bornier-dev/bornier/README.md

# Bornier

Open source EtherCAT slaves for machine tools running LinuxCNC: hardware, firmware and tooling.

- Website: [bornier.dev](https://bornier.dev)

> **Status: board bring-up.** Nothing here is usable yet. The first base boards are built and
> are being brought up block by block: the firmware runs on them and has on-target tests for
> the blocks checked so far, without the EtherCAT stack yet.

## Goals

- A family of standard-compliant EtherCAT slaves for CNC retrofits: motion (step/dir, encoders, probe), digital and analog I/O, spindle control, Modbus gateway.
- Works with any EtherCAT master; developed and tested against LinuxCNC with the IgH master (`lcec`).
- Firmware builds on the LinuxCNC PC itself with a free toolchain (`arm-none-eabi-gcc`, CMake) and updates over EtherCAT (FoE).
- Hardware designed in KiCad, published in full.

Out of scope: functional safety. E-stop and STO stay hardwired.

## Architecture

```
          EtherCAT (daisy chain)
LinuxCNC PC ──► [Base board A] ──► [EtherCAT drive] ──► [Base board B] ──► ...
 (IgH master)        │ HE10 ribbon (local bus, not EtherCAT)
                     ├── I/O module 1
                     └── I/O module n
```

- **One generic base board** per EtherCAT slave. More axes come from more boards on the
  EtherCAT chain (8 axes with two boards, 12 with three).
- **Extension modules** on DIN rail, chained to the base board by HE10 ribbons: slow I/O on SPI
  chips, without an MCU. A base board and its modules form a single modular slave.

## Base board

Schematic and PCB in [`hardware/base/`](hardware/base), generated by script (see below); the PCB is
being placed.

| Block | Content |
|---|---|
| Core | Microchip LAN9253 EtherCAT slave controller (two ports, RJ45 with magnetics), STM32H523 MCU in LQFP-100 over SPI/OCTOSPI, one shared 25 MHz MEMS oscillator |
| Power | 12 V or 24 V logic supply (10.8–30 V): fuse, TVS, reverse polarity protection, bucks to 5 V and 3.3 V; USB micro-B for bench power and DFU flashing |
| Motion | 4 axes, each on a dual RJ45: drive port (differential step/dir, enable, alarm, current-limited supply output) and encoder port (RS-422, TTL or HTL, 5 V or supply voltage); fast probe input |
| Spindle | 0-10 V speed reference, PWM, enable and direction |
| Modbus | Isolated RS-485, switchable termination |
| Safety | E-stop state input (wired, not a safety function), external watchdog on the MCU reset |
| Local bus | HE10 2 × 17 connector to the extension modules: SPI, 12 chip selects, I²C, IRQ, LATCH, OE |

The STM32H523 footprint takes any STM32H5 in LQFP-100 (H523, H533, H562, H563) without a PCB
change. The board is meant to be fed by a dedicated supply in the same cabinet; the
simulation of the input stage and its limits is in [`hardware/base/sim/`](hardware/base/sim/README.md).

The board is 107.5 × 150 mm. It mounts on a DIN rail in a Phoenix Contact UM-BASIC 108 profile
(housing kit UM-BASIC-KIT-B108-L150-7035), resting on the profile walls at the top level, or
screws onto a panel through four M3 holes at the corners, one of them plated to earth the board.
A plated hole takes the Phoenix PE contact, which earths the board to the DIN rail. Every edge
connector sits on a long edge: the profile closes the short ones; the USB jack is vertical.

## Repository layout

| Directory | Contents |
|---|---|
| [`firmware/`](firmware/README.md) | C++23 firmware on the [OpSy](https://github.com/Otatiaro/OpSy) RTOS, generated STM32H523 register headers, board support for the base board, bring-up examples and on-target tests |
| `hardware/lib/` | `kicadgen`, the Python schematic generator and checker (ERC, netlist), and the symbols, footprints and 3D models missing from the KiCad libraries, with their generators |
| `hardware/base/` | Base board: schematic generator (`gen/`), KiCad project (`kicad/`), Gerbers (`fab/`), circuit simulation (`sim/`) |
| [`tools/hil/`](tools/hil/README.md) | Hardware-in-the-loop test scripts |
| `tools/udev/` | udev rules for debug probes on Linux |

The schematic is generated: edit the scripts in `hardware/base/gen/`, then run
`python hardware/base/gen/schematic.py`, which regenerates it and runs the checks. The PCB is edited in
KiCad: after a schematic change, update it from the schematic (Tools > Update PCB from Schematic).

Building, flashing and coding rules: [CONTRIBUTING.md](CONTRIBUTING.md).

## Licensing

| Part | License |
|---|---|
| Hardware (KiCad projects) | [CERN-OHL-W-2.0](LICENSES/CERN-OHL-W-2.0.txt) |
| Firmware and tools | [MPL-2.0](LICENSES/MPL-2.0.txt) |
| Documentation | [CC-BY-4.0](LICENSES/CC-BY-4.0.txt) |

Each file carries an SPDX header naming its license.

## Official builds and forks

Official releases will carry the Bornier EtherCAT Vendor ID. Forks distributing hardware or firmware must use their own Vendor ID.

EtherCAT® is a registered trademark and patented technology, licensed by Beckhoff Automation GmbH, Germany.
