bornier-dev/bornier/firmware/devices/STM32H523/README.md

<!-- Generated by SvdGenerator 1.0.0; do not edit. -->

# STM32H523 register headers

Typed C++ register definitions for the STM32H523, generated by
[SvdGenerator](https://github.com/Otatiaro/SvdGenerator) 1.0.0. Every file here that
starts with a "Generated by SvdGenerator" line is replaced on the next run: change the
SVD file or the generator, not the file.

| | |
|---|---|
| Source | `STM32H523.svd` (device STM32H523, version 1.2) |
| SHA-256 of the source | `b989e9e5972266fa4f88ddf1c6e88730eb561bb5fadd696d822d5329803a197e` |
| Namespace | `STM32H523` |
| Core | CM33, r0p0, 4 interrupt priority bits, FPU, MPU |

## Whose is what

- **What the headers take from the source file**, names, addresses and descriptions,
  remains under the notice that file carries:

  > Copyright (c) 2025 STMicroelectronics.  
  >
  > SPDX-License-Identifier: Apache-2.0  
  >
  > Licensed under the Apache License, Version 2.0 (the "License");  
  > you may not use this file except in compliance with the License.  
  > You may obtain a copy of the License at  
  >
  > http://www.apache.org/licenses/LICENSE-2.0  
  >
  > Unless required by applicable law or agreed to in writing, software  
  > distributed under the License is distributed on an "AS IS" BASIS,  
  > WITHOUT WARRANTIES OR CONDITIONS OF ANY KIND, either express or implied.  
  > See the License for the specific language governing permissions and  
  > limitations under the License.  

- **The code generated around it** carries no license of SvdGenerator: the generator puts
  none of its own on what it generates.
- **`mmio.hpp`** is not generated from the source file: it is part of SvdGenerator, under
  the MIT license written in its header.

## Finding a register

A peripheral header can be thousands of lines long: do not read one from the top. Each
starts with a **map**: one line per register, with its offset, its access, its class, its
fields with their bits, and the lines of the file where its class is. From the table
below, open the header of the peripheral, read its map, then only the lines of the
register you need.

The [README of SvdGenerator](https://github.com/Otatiaro/SvdGenerator#the-generated-api)
describes the generated API: names, shared classes, arrays, named values, the vector table,
and what the code refuses to compile.

## Device headers

| Header | Holds |
|---|---|
| [`device.hpp`](device.hpp) | `device_name`, `device_version` and what the source says of the core |
| [`interrupts.hpp`](interrupts.hpp) | `irq_count` and the `IRQn_Type` enumeration |
| [`vectors.hpp`](vectors.hpp) | `vector_table`, the vector table built at compile time, and the `exception` enumeration of the core |
| [`mmio.hpp`](mmio.hpp) | The register building blocks every peripheral header includes (namespace `mmio`); the same for every device |

## Peripherals

"Line" is where the class starts in its header. Peripherals with the same registers share
a class.

| Peripheral | Address | Class | Header | Line | Interrupts | Description |
|---|---|---|---|---|---|---|
| `adc` | `0x42028000` | `adc_p` | [`adc.hpp`](adc.hpp) | 81 | `ADC1_IRQn` (37) | ADC register block |
| `adc2` | `0x42028100` | `adc_p` | [`adc.hpp`](adc.hpp) | 81 | `ADC2_IRQn` (69) | ADC register block |
| `adc2_s` | `0x52028100` | `adc_p` | [`adc.hpp`](adc.hpp) | 81 |  | ADC register block |
| `adcc` | `0x42028300` | `adcc_p` | [`adc.hpp`](adc.hpp) | 3921 |  | ADC common registers block |
| `adc_s` | `0x52028000` | `adc_p` | [`adc.hpp`](adc.hpp) | 81 |  | ADC register block |
| `crc` | `0x40023000` | `crc_p` | [`crc.hpp`](crc.hpp) | 47 |  | CRC address block description |
| `crc_s` | `0x50023000` | `crc_p` | [`crc.hpp`](crc.hpp) | 47 |  | CRC address block description |
| `crs` | `0x40006000` | `crs_p` | [`crs.hpp`](crs.hpp) | 46 | `CRS_IRQn` (75) | CRS address block description |
| `crs_s` | `0x50006000` | `crs_p` | [`crs.hpp`](crs.hpp) | 46 |  | CRS address block description |
| `dac` | `0x42028400` | `dac_p` | [`dac.hpp`](dac.hpp) | 62 | `DAC1_IRQn` (38) | DAC address block description |
| `dac_s` | `0x52028400` | `dac_p` | [`dac.hpp`](dac.hpp) | 62 |  | DAC address block description |
| `dbgmcu` | `0x44024000` | `dbgmcu_p` | [`dbgmcu.hpp`](dbgmcu.hpp) | 62 |  | DBGMCU register block |
| `dbgmcu_s` | `0x54024000` | `dbgmcu_p` | [`dbgmcu.hpp`](dbgmcu.hpp) | 62 |  | DBGMCU register block |
| `dcache` | `0x40031400` | `dcache_p` | [`dcache.hpp`](dcache.hpp) | 52 | `DCACHE_IRQn` (105) | DCACHE register block |
| `dcache_s` | `0x50031400` | `dcache_p` | [`dcache.hpp`](dcache.hpp) | 52 |  | DCACHE register block |
| `dcmi` | `0x4202C000` | `dcmi_p` | [`dcmi.hpp`](dcmi.hpp) | 53 | `DCMI_PSSI_IRQn` (108) | DCMI address block description |
| `dcmi_s` | `0x5202C000` | `dcmi_p` | [`dcmi.hpp`](dcmi.hpp) | 53 |  | DCMI address block description |
| `dlybos1` | `0x4600F000` | `dlyb_p` | [`dlyb.hpp`](dlyb.hpp) | 44 |  | DLYB address block description |
| `dlybos1_s` | `0x5600F000` | `dlyb_p` | [`dlyb.hpp`](dlyb.hpp) | 44 |  | DLYB address block description |
| `dlybsd1` | `0x46008400` | `dlyb_p` | [`dlyb.hpp`](dlyb.hpp) | 44 |  | DLYB address block description |
| `dlybsd1_s` | `0x56008400` | `dlyb_p` | [`dlyb.hpp`](dlyb.hpp) | 44 |  | DLYB address block description |
| `dts` | `0x40008C00` | `dts_p` | [`dts.hpp`](dts.hpp) | 51 | `DTS_OR_DTS_WKUP_IRQn` (113) | DTS address block description |
| `dts_s` | `0x50008C00` | `dts_p` | [`dts.hpp`](dts.hpp) | 51 |  | DTS address block description |
| `exti` | `0x44022000` | `exti_p` | [`exti.hpp`](exti.hpp) | 65 | `EXTI0_IRQn` (11), `EXTI1_IRQn` (12), `EXTI2_IRQn` (13), `EXTI3_IRQn` (14), `EXTI4_IRQn` (15), `EXTI5_IRQn` (16), `EXTI6_IRQn` (17), `EXTI7_IRQn` (18), `EXTI8_IRQn` (19), `EXTI9_IRQn` (20), `EXTI10_IRQn` (21), `EXTI11_IRQn` (22), `EXTI12_IRQn` (23), `EXTI13_IRQn` (24), `EXTI14_IRQn` (25), `EXTI15_IRQn` (26), `FPU_IRQn` (103), `CEC_IRQn` (119) | EXTI address block description |
| `exti_s` | `0x54022000` | `exti_p` | [`exti.hpp`](exti.hpp) | 65 |  | EXTI address block description |
| `fdcan` | `0x4000A400` | `fdcan_p` | [`fdcan.hpp`](fdcan.hpp) | 79 | `FDCAN1_IT0_IRQn` (39), `FDCAN1_IT1_IRQn` (40) | FDCAN register blank and RAM |
| `fdcan2` | `0x4000A800` | `fdcan_p` | [`fdcan.hpp`](fdcan.hpp) | 79 | `FDCAN2_IT0_IRQn` (109), `FDCAN2_IT1_IRQn` (110) | FDCAN register blank and RAM |
| `fdcan2_s` | `0x5000A800` | `fdcan_p` | [`fdcan.hpp`](fdcan.hpp) | 79 |  | FDCAN register blank and RAM |
| `fdcan_s` | `0x5000A400` | `fdcan_p` | [`fdcan.hpp`](fdcan.hpp) | 79 |  | FDCAN register blank and RAM |
| `flash` | `0x40022000` | `flash_p` | [`flash.hpp`](flash.hpp) | 107 | `FLASH_IRQn` (6) | Mustang_FLASH register block |
| `flash_s` | `0x50022000` | `flash_p` | [`flash.hpp`](flash.hpp) | 107 | `FLASH_S_IRQn` (7) | Mustang_FLASH register block |
| `fmc` | `0x47000400` | `fmc_p` | [`fmc.hpp`](fmc.hpp) | 67 | `FMC_IRQn` (77) | FMC address block description |
| `fmc_s` | `0x57000400` | `fmc_p` | [`fmc.hpp`](fmc.hpp) | 67 |  | FMC address block description |
| `gpdma` | `0x40020000` | `gpdma_p` | [`gpdma.hpp`](gpdma.hpp) | 60 | `GPDMA1_CH0_IRQn` (27), `GPDMA1_CH1_IRQn` (28), `GPDMA1_CH2_IRQn` (29), `GPDMA1_CH3_IRQn` (30), `GPDMA1_CH4_IRQn` (31), `GPDMA1_CH5_IRQn` (32), `GPDMA1_CH6_IRQn` (33), `GPDMA1_CH7_IRQn` (34) | GPDMA register block |
| `gpdma2` | `0x40021000` | `gpdma_p` | [`gpdma.hpp`](gpdma.hpp) | 60 | `GPDMA2_CH0_IRQn` (90), `GPDMA2_CH1_IRQn` (91), `GPDMA2_CH2_IRQn` (92), `GPDMA2_CH3_IRQn` (93), `GPDMA2_CH4_IRQn` (94), `GPDMA2_CH5_IRQn` (95), `GPDMA2_CH6_IRQn` (96), `GPDMA2_CH7_IRQn` (97) | GPDMA register block |
| `gpdma2_s` | `0x50021000` | `gpdma_p` | [`gpdma.hpp`](gpdma.hpp) | 60 |  | GPDMA register block |
| `gpdma_s` | `0x50020000` | `gpdma_p` | [`gpdma.hpp`](gpdma.hpp) | 60 |  | GPDMA register block |
| `gpioa` | `0x42020000` | `gpio_p` | [`gpio.hpp`](gpio.hpp) | 70 |  | GPIOA address block description |
| `gpioa_s` | `0x52020000` | `gpio_p` | [`gpio.hpp`](gpio.hpp) | 70 |  | GPIOA address block description |
| `gpiob` | `0x42020400` | `gpio_p` | [`gpio.hpp`](gpio.hpp) | 70 |  | GPIOB address block description |
| `gpiob_s` | `0x52020400` | `gpio_p` | [`gpio.hpp`](gpio.hpp) | 70 |  | GPIOB address block description |
| `gpioc` | `0x42020800` | `gpio_p` | [`gpio.hpp`](gpio.hpp) | 70 |  | GPIOC address block description |
| `gpioc_s` | `0x52020800` | `gpio_p` | [`gpio.hpp`](gpio.hpp) | 70 |  | GPIOC address block description |
| `gpiod` | `0x42020C00` | `gpio_p` | [`gpio.hpp`](gpio.hpp) | 70 |  | GPIOD address block description |
| `gpiod_s` | `0x52020C00` | `gpio_p` | [`gpio.hpp`](gpio.hpp) | 70 |  | GPIOD address block description |
| `gpioe` | `0x42021000` | `gpio_p` | [`gpio.hpp`](gpio.hpp) | 70 |  | GPIOE address block description |
| `gpioe_s` | `0x52021000` | `gpio_p` | [`gpio.hpp`](gpio.hpp) | 70 |  | GPIOE address block description |
| `gpiof` | `0x42021400` | `gpio_p` | [`gpio.hpp`](gpio.hpp) | 70 |  | GPIOF address block description |
| `gpiof_s` | `0x52021400` | `gpio_p` | [`gpio.hpp`](gpio.hpp) | 70 |  | GPIOF address block description |
| `gpiog` | `0x42021800` | `gpio_p` | [`gpio.hpp`](gpio.hpp) | 70 |  | GPIOG address block description |
| `gpiog_s` | `0x52021800` | `gpio_p` | [`gpio.hpp`](gpio.hpp) | 70 |  | GPIOG address block description |
| `gpioh` | `0x42021C00` | `gpio_p` | [`gpio.hpp`](gpio.hpp) | 70 |  | GPIOH address block description |
| `gpioh_s` | `0x52021C00` | `gpio_p` | [`gpio.hpp`](gpio.hpp) | 70 |  | GPIOH address block description |
| `gpioi` | `0x1A0` | `gpioi_p` | [`gpio.hpp`](gpio.hpp) | 5825 |  | GPIOI address block description |
| `gpioi_s` | `0x100001A0` | `gpioi_p` | [`gpio.hpp`](gpio.hpp) | 5825 |  | GPIOI address block description |
| `gtzc1_tzic` | `0x40032400` | `gtzc1_tzic_p` | [`gtzc1.hpp`](gtzc1.hpp) | 80 | `GTZC_IRQn` (8) | GTZC1_MPCBBz register block |
| `gtzc1_tzic_s` | `0x50032400` | `gtzc1_tzic_p` | [`gtzc1.hpp`](gtzc1.hpp) | 80 |  | GTZC1_MPCBBz register block |
| `gtzc1_tzsc` | `0x40036400` | `gtzc1_tzsc_p` | [`gtzc1.hpp`](gtzc1.hpp) | 7014 |  | GTZC1_MPCBBz register block |
| `gtzc1_tzsc_s` | `0x50036400` | `gtzc1_tzsc_p` | [`gtzc1.hpp`](gtzc1.hpp) | 7014 |  | GTZC1_MPCBBz register block |
| `hash` | `0x420C0400` | `hash_p` | [`hash.hpp`](hash.hpp) | 171 | `HASH_IRQn` (117) | HASH register bank |
| `hash_s` | `0x520C0400` | `hash_p` | [`hash.hpp`](hash.hpp) | 171 |  | HASH register bank |
| `i2c` | `0x40005400` | `i2c_p` | [`i2c.hpp`](i2c.hpp) | 53 | `I2C1_EV_IRQn` (51), `I2C1_ERR_IRQn` (52) | I2C address block description |
| `i2c2` | `0x40005800` | `i2c_p` | [`i2c.hpp`](i2c.hpp) | 53 | `I2C2_EV_IRQn` (53), `I2C2_ERR_IRQn` (54) | I2C address block description |
| `i2c2_s` | `0x50005800` | `i2c_p` | [`i2c.hpp`](i2c.hpp) | 53 |  | I2C address block description |
| `i2c3` | `0x44002800` | `i2c_p` | [`i2c.hpp`](i2c.hpp) | 53 | `I2C3_EV_IRQn` (80), `I2C3_ERR_IRQn` (81) | I2C address block description |
| `i2c3_s` | `0x54002800` | `i2c_p` | [`i2c.hpp`](i2c.hpp) | 53 |  | I2C address block description |
| `i2c_s` | `0x50005400` | `i2c_p` | [`i2c.hpp`](i2c.hpp) | 53 |  | I2C address block description |
| `i3c` | `0x40005C00` | `i3c_p` | [`i3c.hpp`](i3c.hpp) | 73 | `I3C1_EV_IRQn` (123), `I3C1_ERR_IRQn` (124) | I3C register block |
| `i3c2` | `0x44003000` | `i3c_p` | [`i3c.hpp`](i3c.hpp) | 73 | `I3C2_EV_IRQn` (131), `I3C2_ERR_IRQn` (132) | I3C register block |
| `i3c2_s` | `0x54003000` | `i3c_p` | [`i3c.hpp`](i3c.hpp) | 73 |  | I3C register block |
| `i3c_s` | `0x50005C00` | `i3c_p` | [`i3c.hpp`](i3c.hpp) | 73 |  | I3C register block |
| `icache` | `0x40030400` | `icache_p` | [`icache.hpp`](icache.hpp) | 52 | `ICACHE_IRQn` (104) | ICACHE register block |
| `icache_s` | `0x50030400` | `icache_p` | [`icache.hpp`](icache.hpp) | 52 |  | ICACHE register block |
| `iwdg` | `0x40003000` | `iwdg_p` | [`iwdg.hpp`](iwdg.hpp) | 48 | `IWDG_IRQn` (35) | IWDG address block description |
| `iwdg_s` | `0x50003000` | `iwdg_p` | [`iwdg.hpp`](iwdg.hpp) | 48 |  | IWDG address block description |
| `lptim1` | `0x44004400` | `lptim_p` | [`lptim.hpp`](lptim.hpp) | 57 | `LPTIM1_IRQn` (64) | LPTIM1 address block description |
| `lptim1_s` | `0x54004400` | `lptim_p` | [`lptim.hpp`](lptim.hpp) | 57 |  | LPTIM1 address block description |
| `lptim2` | `0x40009400` | `lptim_p` | [`lptim.hpp`](lptim.hpp) | 57 | `LPTIM2_IRQn` (70) | LPTIM2 address block description |
| `lptim2_s` | `0x50009400` | `lptim_p` | [`lptim.hpp`](lptim.hpp) | 57 |  | LPTIM2 address block description |
| `lpuart` | `0x44002400` | `lpuart_p` | [`lpuart.hpp`](lpuart.hpp) | 55 | `LPUART1_IRQn` (63) | LPUART address block description |
| `lpuart_s` | `0x54002400` | `lpuart_p` | [`lpuart.hpp`](lpuart.hpp) | 55 |  | LPUART address block description |
| `octospi` | `0x47001400` | `octospi_p` | [`octospi.hpp`](octospi.hpp) | 69 | `OCTOSPI1_IRQn` (78) | OCTOSPI register block |
| `octospi_s` | `0x57001400` | `octospi_p` | [`octospi.hpp`](octospi.hpp) | 69 |  | OCTOSPI register block |
| `pssi` | `0x4202C400` | `pssi_p` | [`pssi.hpp`](pssi.hpp) | 49 |  | PSSI register block |
| `pssi_s` | `0x5202C400` | `pssi_p` | [`pssi.hpp`](pssi.hpp) | 49 |  | PSSI register block |
| `pwr` | `0x44020800` | `pwr_p` | [`pwr.hpp`](pwr.hpp) | 61 |  | PWR address block description |
| `pwr_s` | `0x54020800` | `pwr_p` | [`pwr.hpp`](pwr.hpp) | 61 |  | PWR address block description |
| `ramcfg` | `0x40026000` | `ramcfg_p` | [`ramcfg.hpp`](ramcfg.hpp) | 73 | `RAMCFG_IRQn` (5) | RAMCFG address block description |
| `ramcfg_s` | `0x50026000` | `ramcfg_p` | [`ramcfg.hpp`](ramcfg.hpp) | 73 |  | RAMCFG address block description |
| `rcc` | `0x44020C00` | `rcc_p` | [`rcc.hpp`](rcc.hpp) | 90 | `RCC_IRQn` (9), `RCC_S_IRQn` (10) | RCC address block description |
| `rcc_s` | `0x54020C00` | `rcc_p` | [`rcc.hpp`](rcc.hpp) | 90 |  | RCC address block description |
| `rng` | `0x420C0800` | `rng_p` | [`rng.hpp`](rng.hpp) | 47 | `RNG_IRQn` (114) | RNG address block description |
| `rng_s` | `0x520C0800` | `rng_p` | [`rng.hpp`](rng.hpp) | 47 |  | RNG address block description |
| `rtc` | `0x44007800` | `rtc_p` | [`rtc.hpp`](rtc.hpp) | 68 | `RTC_IRQn` (2), `RTC_S_IRQn` (3) | RTC register block |
| `rtc_s` | `0x54007800` | `rtc_p` | [`rtc.hpp`](rtc.hpp) | 68 |  | RTC register block |
| `sbs` | `0x44000400` | `sbs_p` | [`sbs.hpp`](sbs.hpp) | 60 |  | SBS address block description |
| `sbs_s` | `0x54000400` | `sbs_p` | [`sbs.hpp`](sbs.hpp) | 60 |  | SBS address block description |
| `sdmmc` | `0x46008000` | `sdmmc_p` | [`sdmmc.hpp`](sdmmc.hpp) | 80 | `SDMMC1_IRQn` (79) | SDMMC address block description |
| `sdmmc_s` | `0x56008000` | `sdmmc_p` | [`sdmmc.hpp`](sdmmc.hpp) | 80 |  | SDMMC address block description |
| `sec_adcc` | `0x52028300` | `adcc_p` | [`adc.hpp`](adc.hpp) | 3921 |  | ADC common registers block |
| `spi` | `0x40013000` | `spi_p` | [`spi.hpp`](spi.hpp) | 56 | `SPI1_IRQn` (55) | SPI address block description |
| `spi2` | `0x40003800` | `spi_p` | [`spi.hpp`](spi.hpp) | 56 | `SPI2_IRQn` (56) | SPI address block description |
| `spi2_s` | `0x50003800` | `spi_p` | [`spi.hpp`](spi.hpp) | 56 |  | SPI address block description |
| `spi3` | `0x40003C00` | `spi_p` | [`spi.hpp`](spi.hpp) | 56 | `SPI3_IRQn` (57) | SPI address block description |
| `spi3_s` | `0x50003C00` | `spi_p` | [`spi.hpp`](spi.hpp) | 56 |  | SPI address block description |
| `spi4` | `0x40014C00` | `spi_p` | [`spi.hpp`](spi.hpp) | 56 | `SPI4_IRQn` (82) | SPI address block description |
| `spi4_s` | `0x50014C00` | `spi_p` | [`spi.hpp`](spi.hpp) | 56 |  | SPI address block description |
| `spi_s` | `0x50013000` | `spi_p` | [`spi.hpp`](spi.hpp) | 56 |  | SPI address block description |
| `tamp` | `0x44007C00` | `tamp_p` | [`tamp.hpp`](tamp.hpp) | 92 | `TAMP_IRQn` (4) | TAMP register block |
| `tamp_s` | `0x54007C00` | `tamp_p` | [`tamp.hpp`](tamp.hpp) | 92 |  | TAMP register block |
| `tim1` | `0x40012C00` | `tim1_p` | [`tim.hpp`](tim.hpp) | 162 | `TIM1_BRK_TERR_IERR_IRQn` (41), `TIM1_UPD_IRQn` (42), `TIM1_TRGI_COM_DIR_IDX_IRQn` (43), `TIM1_CC_IRQn` (44) | TIM1 address block description |
| `tim1_s` | `0x50012C00` | `tim1_p` | [`tim.hpp`](tim.hpp) | 162 |  | TIM1 address block description |
| `tim2` | `0x40000000` | `tim2_p` | [`tim.hpp`](tim.hpp) | 6623 | `TIM2_IRQn` (45) | TIM2 address block description |
| `tim2_s` | `0x50000000` | `tim2_p` | [`tim.hpp`](tim.hpp) | 6623 |  | TIM2 address block description |
| `tim3` | `0x40000400` | `tim3_p` | [`tim.hpp`](tim.hpp) | 10581 | `TIM3_IRQn` (46) | TIM3 address block description |
| `tim3_s` | `0x50000400` | `tim3_p` | [`tim.hpp`](tim.hpp) | 10581 |  | TIM3 address block description |
| `tim4` | `0x40000800` | `tim3_p` | [`tim.hpp`](tim.hpp) | 10581 | `TIM4_IRQn` (47) | TIM4 address block description |
| `tim4_s` | `0x50000800` | `tim3_p` | [`tim.hpp`](tim.hpp) | 10581 |  | TIM4 address block description |
| `tim5` | `0x40000C00` | `tim2_p` | [`tim.hpp`](tim.hpp) | 6623 | `TIM5_IRQn` (48) | TIM5 address block description |
| `tim5_s` | `0x50000C00` | `tim2_p` | [`tim.hpp`](tim.hpp) | 6623 |  | TIM5 address block description |
| `tim6` | `0x40001000` | `tim6_p` | [`tim.hpp`](tim.hpp) | 14539 | `TIM6_IRQn` (49) | TIM6 address block description |
| `tim6_s` | `0x50001000` | `tim6_p` | [`tim.hpp`](tim.hpp) | 14539 |  | TIM6 address block description |
| `tim7` | `0x40001400` | `tim6_p` | [`tim.hpp`](tim.hpp) | 14539 | `TIM7_IRQn` (50) | TIM7 address block description |
| `tim7_s` | `0x50001400` | `tim6_p` | [`tim.hpp`](tim.hpp) | 14539 |  | TIM7 address block description |
| `tim8` | `0x40013400` | `tim1_p` | [`tim.hpp`](tim.hpp) | 162 | `TIM8_BRK_TERR_IERR_IRQn` (65), `TIM8_UPD_IRQn` (66), `TIM8_TRGI_DIR_IDX_IRQn` (67), `TIM8_CC_IRQn` (68) | TIM8 address block description |
| `tim8_s` | `0x50013400` | `tim1_p` | [`tim.hpp`](tim.hpp) | 162 |  | TIM8 address block description |
| `tim15` | `0x40014000` | `tim15_p` | [`tim.hpp`](tim.hpp) | 15136 | `TIM15_IRQn` (71) | TIM15 address block description |
| `tim15_s` | `0x50014000` | `tim15_p` | [`tim.hpp`](tim.hpp) | 15136 |  | TIM15 address block description |
| `uart4` | `0x40004C00` | `usart_p` | [`usart.hpp`](usart.hpp) | 57 | `UART4_IRQn` (61) | USART address block description |
| `uart4_s` | `0x50004C00` | `usart_p` | [`usart.hpp`](usart.hpp) | 57 |  | USART address block description |
| `uart5` | `0x40005000` | `usart_p` | [`usart.hpp`](usart.hpp) | 57 | `UART5_IRQn` (62) | USART address block description |
| `uart5_s` | `0x50005000` | `usart_p` | [`usart.hpp`](usart.hpp) | 57 |  | USART address block description |
| `ucpd` | `0x4000DC00` | `ucpd_p` | [`ucpd.hpp`](ucpd.hpp) | 57 | `UCPD1_IRQn` (76) | UCPD register block |
| `ucpd_s` | `0x5000DC00` | `ucpd_p` | [`ucpd.hpp`](ucpd.hpp) | 57 |  | UCPD register block |
| `usart` | `0x40013800` | `usart_p` | [`usart.hpp`](usart.hpp) | 57 | `USART1_IRQn` (58) | USART address block description |
| `usart2` | `0x40004400` | `usart_p` | [`usart.hpp`](usart.hpp) | 57 | `USART2_IRQn` (59) | USART address block description |
| `usart2_s` | `0x50004400` | `usart_p` | [`usart.hpp`](usart.hpp) | 57 |  | USART address block description |
| `usart3` | `0x40004800` | `usart_p` | [`usart.hpp`](usart.hpp) | 57 | `USART3_IRQn` (60) | USART address block description |
| `usart3_s` | `0x50004800` | `usart_p` | [`usart.hpp`](usart.hpp) | 57 |  | USART address block description |
| `usart6` | `0x40006400` | `usart_p` | [`usart.hpp`](usart.hpp) | 57 | `USART6_IRQn` (85) | USART address block description |
| `usart6_s` | `0x50006400` | `usart_p` | [`usart.hpp`](usart.hpp) | 57 |  | USART address block description |
| `usart_s` | `0x50013800` | `usart_p` | [`usart.hpp`](usart.hpp) | 57 |  | USART address block description |
| `usb` | `0x40016000` | `usb_p` | [`usb.hpp`](usb.hpp) | 56 | `USB_FS_IRQn` (74) | USB address block description |
| `usbsram` | `0x40016400` | `usbsram_p` | [`usbsram.hpp`](usbsram.hpp) | 74 |  | USBSRAM address block description |
| `usbsram_s` | `0x50016400` | `usbsram_p` | [`usbsram.hpp`](usbsram.hpp) | 74 |  | USBSRAM address block description |
| `usb_s` | `0x50016000` | `usb_p` | [`usb.hpp`](usb.hpp) | 56 |  | USB address block description |
| `vrefbuf` | `0x44007400` | `vrefbuf_p` | [`vrefbuf.hpp`](vrefbuf.hpp) | 44 |  | VREFBUF address block description |
| `vrefbuf_s` | `0x54007400` | `vrefbuf_p` | [`vrefbuf.hpp`](vrefbuf.hpp) | 44 |  | VREFBUF address block description |
| `wwdg` | `0x40002C00` | `wwdg_p` | [`wwdg.hpp`](wwdg.hpp) | 45 | `WWDG_IRQn` (0) | WWDG address block description |
| `wwdg_s` | `0x50002C00` | `wwdg_p` | [`wwdg.hpp`](wwdg.hpp) | 45 |  | WWDG address block description |
