bornier-dev/bornier/hardware/base/fab/base-bom.csv

Comment | Designator | Footprint | LCSC Part #
TLP2361 | U29 | SO-5-6_4.55x3.7mm_P1.27mm | C107626
1k | R14,R18,R188,R228,R238,R240,R247,R248,R25,R251,R253,R26,R29,R30,R303,R304,R305,R31,R310,R313,R315,R32,R33,R34,R35,R36,R46,R55,R59,R65,R7,R71,R77 | R_0402_1005Metric | C11702
LTV-357T-C | U12,U14,U17,U19,U39 | SO-4_4.4x3.6mm_P2.54mm | C119091
SMF15A | D59 | D_SOD-123F | C123802
BAT54S | D29,D30,D31,D32,D33,D34,D36,D37,D38,D39,D40,D41,D43,D44,D45,D46,D47,D48,D50,D51,D52,D53,D54,D55 | SOT-23 | C12765
TPD4E05U06DQAR | D60,U13,U15,U18,U2,U20,U31,U32,U33,U34,U35,U7,U8 | USON-10_2.5x1.0mm_P0.5mm | C138714
SS56B | D2,D28,D3,D35,D4,D42,D49,D5 | D_SMB | C14651
AO3401A | Q11 | SOT-23 | C15127
2.2uF 100V | C2,C3 | C_1210_3225Metric | C153036
470pF | C21,C80 | C_0402_1005Metric | C1537
1uF 50V | C20,C25,C27,C29,C310,C311,C314,C315,C317,C318,C32,C46,C47,C48,C50,C54,C55,C59,C60,C63,C64,C67,C68,C71,C72,C78 | C_0603_1608Metric | C15849
10uF 25V | C10,C19,C300,C43,C76,C83,C85,C9 | C_0805_2012Metric | C15850
4.7k | R108,R116,R124,R13,R134,R142,R150,R160,R168,R176,R184,R185,R249,R250,R306,R60,R66,R72,R78,R82,R90,R98 | R_1206_3216Metric | C17936
3.5A 63V | F1 | Fuse_1206_3216Metric | C182975
TPS3828-33DBVR | U40 | SOT-23-5 | C20032
OPA2990IDR | U36 | SOIC-8_3.9x4.9mm_P1.27mm | C2058283
LOCAL BUS | J10 | IDC-Header_2x17_P2.54mm_Vertical | C20920
1N4148WS | D15,D19,D23,D27,D57,D70 | D_SOD-323 | C2128
120 | R232,R234,R235,R242,R243,R244,R245,R246 | R_0603_1608Metric | C22787
red ALM | D14,D18,D22,D26,D58,D71,D9 | LED_0603_1608Metric | C2286
green MCU | D11,D12,D16,D20,D24,D300,D56,D6,D61,D62,D64,D67,D68,D69,D7,D8 | LED_0603_1608Metric | C2289
49.9 | R15,R16,R203,R204,R205,R206,R207,R208,R209,R210,R211,R212,R213,R214,R215,R216,R217,R218,R219,R220,R221,R316,R37,R38,R39,R40,R41,R42,R43,R44,R47,R48,R49,R50,R51,R52 | R_0603_1608Metric | C23185
100k | R1,R11,R19,R223,R224,R225,R229,R233,R237,R239,R3,R300,R308,R311,R58,R64,R70,R76 | R_0402_1005Metric | C25741
10k | R106,R132,R158,R189,R190,R191,R192,R193,R194,R195,R196,R197,R198,R199,R20,R200,R201,R202,R21,R22,R222,R23,R230,R24,R241,R252,R312,R314,R45,R5,R54,R56,R57,R61,R62,R63,R67,R68,R69,R73,R74,R75,R79,R80,R9 | R_0402_1005Metric | C25744
47k | R187,R2,R301,R4 | R_0402_1005Metric | C25792
12.1k | R17,R302,R6 | R_0402_1005Metric | C25852
2.2k | R10,R107,R133,R159,R226,R227,R236,R8,R81 | R_0402_1005Metric | C25879
4.7k | R100,R101,R103,R104,R110,R111,R113,R114,R118,R119,R12,R121,R122,R126,R127,R129,R130,R136,R137,R139,R140,R144,R145,R147,R148,R152,R153,R155,R156,R162,R163,R165,R166,R170,R171,R173,R174,R178,R179,R181,R182,R186,R231,R84,R85,R87,R88,R92,R93,R95,R96 | R_0402_1005Metric | C25900
3.3k | R102,R109,R112,R117,R120,R125,R128,R135,R138,R143,R146,R151,R154,R161,R164,R169,R172,R177,R180,R83,R86,R91,R94,R99 | R_1206_3216Metric | C26032
TPS1H000AQDGNRQ1 | U10,U21,U23,U25,U27,U302,U303 | HVSSOP-8-1EP_3x3mm_P0.65mm_EP1.57x1.89mm | C2653764
STM32H523VET6 | U9 | LQFP-100_14x14mm_P0.5mm | C27338462
SN75ALS191DR | U11,U16,U300,U301 | SOIC-8_3.9x4.9mm_P1.27mm | C2871261
CA-IS3092W | U38 | SOIC-16W_7.5x10.3mm_P1.27mm | C2890051
ENC 5V|VIN | JP1,JP2,JP3,JP4 | PinHeader_1x03_P2.54mm_Vertical | C2937625
100nF | C11,C12,C13,C14,C15,C16,C17,C18,C22,C23,C24,C26,C28,C30,C31,C312,C313,C316,C320,C321,C33,C35,C36,C38,C39,C4,C40,C41,C42,C44,C45,C49,C51,C52,C53,C56,C57,C58,C61,C62,C65,C66,C69,C7,C70,C73,C74,C75,C77,C79,C81,C82,C84,C87 | C_0402_1005Metric | C307331
BOOT | SW1 | SW_XKB_TS-1187A | C318884
PSM712-LF-T7 | D66 | SOT-23 | C32677
AO3422 | Q1,Q2,Q3,Q4,Q6,Q7 | SOT-23 | C37130
8.2uH | L1 | L_Sunlord_MWSA1004S | C408486
1uH | L2 | L_1008_2520Metric | C435392
TPS3808G33DBVR | U5 | SOT-23-6 | C43698
POWER | J1,J11,J12,J13,J14 | PhoenixContact_MC_1,5_4-G-3.81_1x04_P3.81mm_Horizontal | C441184
47uF 63V | C1 | CP_Elec_6.3x7.7 | C46550423
TPS54360BDDAR | U1 | TI_SO-PowerPAD-8_ThermalVias | C524806
AM26LV32EIDR | U22,U24,U26,U28 | SOIC-16_3.9x9.9mm_P1.27mm | C527448
TPS2553DBVR | U30 | SOT-23-6 | C55266
LAN9253-I/R4X | U4 | QFN-64-1EP_9x9mm_P0.5mm_EP6x6mm_ThermalVias | C5745149
TPS62A02ADRLR | U3 | SOT-563 | C5820994
HY911105AE IN | J3,J4 | RJ45_Hanrun_HR911105A_Horizontal | C69427
SN74AHCT1G125DBVR | U37 | SOT-23-5 | C7484
HC-WK88-H132-1X2-55B | J6,J7,J8,J9 | RJ45x2_HongCheng_HC-WK88-H132-1X2-55B | C7501828
USB micro-B | J2 | USB_Micro-B_Molex-105133-0001 | C782257
SMBJ33CA | D1,D13,D17,D21,D25,D63,D65 | D_SMB | C78420
220R@100MHz | FB1,FB2,FB3,FB4,FB5 | L_0603_1608Metric | C80165
SiT8008BI-71-33E-25.000000 | X1 | Oscillator_SMD_SiT_PQFN-4Pin_2.0x1.6mm | C806295
100uF 10V | C5 | C_1210_3225Metric | C84455
SS8550 | Q5 | SOT-23 | C8542
1nF 2kV | C301,C302,C37,C86 | C_1206_3216Metric | C9196
