bornier-dev/bornier/hardware/base/sim/results.md

# VIN -> 5 V buck (TPS54360B): simulation results

Generated by `buck_sim.py`. Behavioural model of the regulator from its datasheet; see the module docstring for what it includes.

## Loop gain

| Vin | Load | Cout | Crossover | Phase margin | Gain margin |
|---|---|---|---|---|---|
| 7.8 V | 0.25 A | 34 uF | 38.0 kHz | 84 deg | 11.6 dB |
| 7.8 V | 0.25 A | 56 uF | 22.9 kHz | 87 deg | 16.0 dB |
| 7.8 V | 0.25 A | 80 uF | 16.0 kHz | 87 deg | 19.0 dB |
| 7.8 V | 2.50 A | 34 uF | 37.6 kHz | 87 deg | 11.6 dB |
| 7.8 V | 2.50 A | 56 uF | 22.9 kHz | 90 deg | 16.0 dB |
| 7.8 V | 2.50 A | 80 uF | 15.8 kHz | 91 deg | 19.0 dB |
| 7.8 V | 3.50 A | 34 uF | 37.6 kHz | 89 deg | 11.6 dB |
| 7.8 V | 3.50 A | 56 uF | 22.6 kHz | 91 deg | 16.0 dB |
| 7.8 V | 3.50 A | 80 uF | 15.8 kHz | 92 deg | 19.0 dB |
| 10.8 V | 0.25 A | 34 uF | 37.6 kHz | 82 deg | 15.4 dB |
| 10.8 V | 0.25 A | 56 uF | 22.9 kHz | 85 deg | 20.0 dB |
| 10.8 V | 0.25 A | 80 uF | 16.0 kHz | 86 deg | 23.3 dB |
| 10.8 V | 2.50 A | 34 uF | 37.6 kHz | 85 deg | 15.4 dB |
| 10.8 V | 2.50 A | 56 uF | 22.9 kHz | 88 deg | 20.0 dB |
| 10.8 V | 2.50 A | 80 uF | 15.8 kHz | 90 deg | 23.3 dB |
| 10.8 V | 3.50 A | 34 uF | 37.6 kHz | 87 deg | 15.4 dB |
| 10.8 V | 3.50 A | 56 uF | 22.6 kHz | 90 deg | 20.0 dB |
| 10.8 V | 3.50 A | 80 uF | 15.8 kHz | 91 deg | 23.3 dB |
| 16 V | 0.25 A | 34 uF | 37.6 kHz | 80 deg | 12.9 dB |
| 16 V | 0.25 A | 56 uF | 22.9 kHz | 84 deg | 17.4 dB |
| 16 V | 0.25 A | 80 uF | 16.0 kHz | 86 deg | 20.5 dB |
| 16 V | 2.50 A | 34 uF | 37.6 kHz | 84 deg | 13.0 dB |
| 16 V | 2.50 A | 56 uF | 22.6 kHz | 87 deg | 17.4 dB |
| 16 V | 2.50 A | 80 uF | 15.8 kHz | 89 deg | 20.5 dB |
| 16 V | 3.50 A | 34 uF | 37.6 kHz | 85 deg | 13.0 dB |
| 16 V | 3.50 A | 56 uF | 22.6 kHz | 89 deg | 17.4 dB |
| 16 V | 3.50 A | 80 uF | 15.8 kHz | 90 deg | 20.5 dB |
| 24 V | 0.25 A | 34 uF | 37.6 kHz | 79 deg | 16.3 dB |
| 24 V | 0.25 A | 56 uF | 22.9 kHz | 83 deg | 20.9 dB |
| 24 V | 0.25 A | 80 uF | 16.0 kHz | 85 deg | 24.4 dB |
| 24 V | 2.50 A | 34 uF | 37.6 kHz | 82 deg | 16.5 dB |
| 24 V | 2.50 A | 56 uF | 22.6 kHz | 87 deg | 21.0 dB |
| 24 V | 2.50 A | 80 uF | 15.8 kHz | 88 deg | 24.4 dB |
| 24 V | 3.50 A | 34 uF | 37.6 kHz | 84 deg | 16.5 dB |
| 24 V | 3.50 A | 56 uF | 22.6 kHz | 88 deg | 21.0 dB |
| 24 V | 3.50 A | 80 uF | 15.8 kHz | 90 deg | 24.4 dB |
| 30 V | 0.25 A | 34 uF | 37.6 kHz | 79 deg | 17.2 dB |
| 30 V | 0.25 A | 56 uF | 22.9 kHz | 83 deg | 21.9 dB |
| 30 V | 0.25 A | 80 uF | 16.0 kHz | 85 deg | 25.3 dB |
| 30 V | 2.50 A | 34 uF | 37.6 kHz | 82 deg | 17.3 dB |
| 30 V | 2.50 A | 56 uF | 22.6 kHz | 86 deg | 21.9 dB |
| 30 V | 2.50 A | 80 uF | 15.8 kHz | 88 deg | 25.4 dB |
| 30 V | 3.50 A | 34 uF | 37.2 kHz | 83 deg | 17.4 dB |
| 30 V | 3.50 A | 56 uF | 22.6 kHz | 88 deg | 21.9 dB |
| 30 V | 3.50 A | 80 uF | 15.8 kHz | 90 deg | 25.4 dB |

## Transient scenarios

- **start-up 10.8 V, 2.5 A**: vout = 5.09, ripple = 0.008064, overshoot = 5.093, il_max = 2.873, t_rise = 0.001454, iin_max = 19.18, vin_max = 12.53
- **start-up 12.0 V, 2.5 A**: vout = 5.09, ripple = 0.008596, overshoot = 5.094, il_max = 2.901, t_rise = 0.001456, iin_max = 21.41, vin_max = 13.99
- **start-up 19.2 V, 2.5 A**: vout = 5.089, ripple = 0.009127, overshoot = 5.093, il_max = 3, t_rise = 0.001469, iin_max = 34.79, vin_max = 22.74
- **start-up 24.0 V, 2.5 A**: vout = 5.089, ripple = 0.009923, overshoot = 5.093, il_max = 3.034, t_rise = 0.00148, iin_max = 43.72, vin_max = 28.57
- **start-up 30.0 V, 2.5 A**: vout = 5.089, ripple = 0.01089, overshoot = 5.094, il_max = 3.059, t_rise = 0.001482, iin_max = 54.88, vin_max = 35.87
- **load step 0.5-2.5-0.5 A, 10.8 V, Cout 56 uF**: vmin = 4.854, vmax = 5.229, il_max = 2.757
- **load step 0.5-2.5-0.5 A, 10.8 V, Cout 34 uF**: vmin = 4.848, vmax = 5.231, il_max = 2.751
- **load step 0.5-2.5-0.5 A, 24.0 V, Cout 56 uF**: vmin = 4.851, vmax = 5.229, il_max = 2.92
- **load step 0.5-2.5-0.5 A, 24.0 V, Cout 34 uF**: vmin = 4.844, vmax = 5.231, il_max = 2.915
- **load step 0.5-2.5-0.5 A, 30.0 V, Cout 56 uF**: vmin = 4.85, vmax = 5.229, il_max = 2.947
- **load step 0.5-2.5-0.5 A, 30.0 V, Cout 34 uF**: vmin = 4.844, vmax = 5.231, il_max = 2.944
- **7.8 V input (UVLO stop 7.79 V), Ron hot 0.19 ohm, 2.5 A**: vout = 5.09, ripple = 0.006806
- **light load 20 mA, 24 V**: vout = 5.1, ripple = 0.006181, il_max = 0.3374
- **output short 1 ms at 30.0 V**: il_max = 5.498, il_mean = 4.851, isw_max = 113.9, recover_overshoot = 5.493
- **output short 1 ms at 53.0 V**: il_max = 5.623, il_mean = 4.957, isw_max = 168.4, recover_overshoot = 5.552
- **hot plug 30 V, with C1**: vin_max = 35.87, iin_max = 54.88, i2t_fuse = 0.03146, tvs_max = 2.079e-06
- **hot plug 30 V, without C1**: vin_max = 47.4, iin_max = 49.92, i2t_fuse = 0.01195, tvs_max = 7.131
- **surge 0.5 kV 1.2/50 us, 2 ohm**: vin_max = 118.2, vclamp = 121.3, tvs_max = 62.61, tvs_energy = 0.5592, i2t_fuse = 1.168, vmin = 4.818, vmax = 5.448
