bornier-dev/bornier/hardware/base/kicad/base.kicad_pcb

## KiCad design hardware/base/kicad/base.kicad_pcb (2026-11-02)

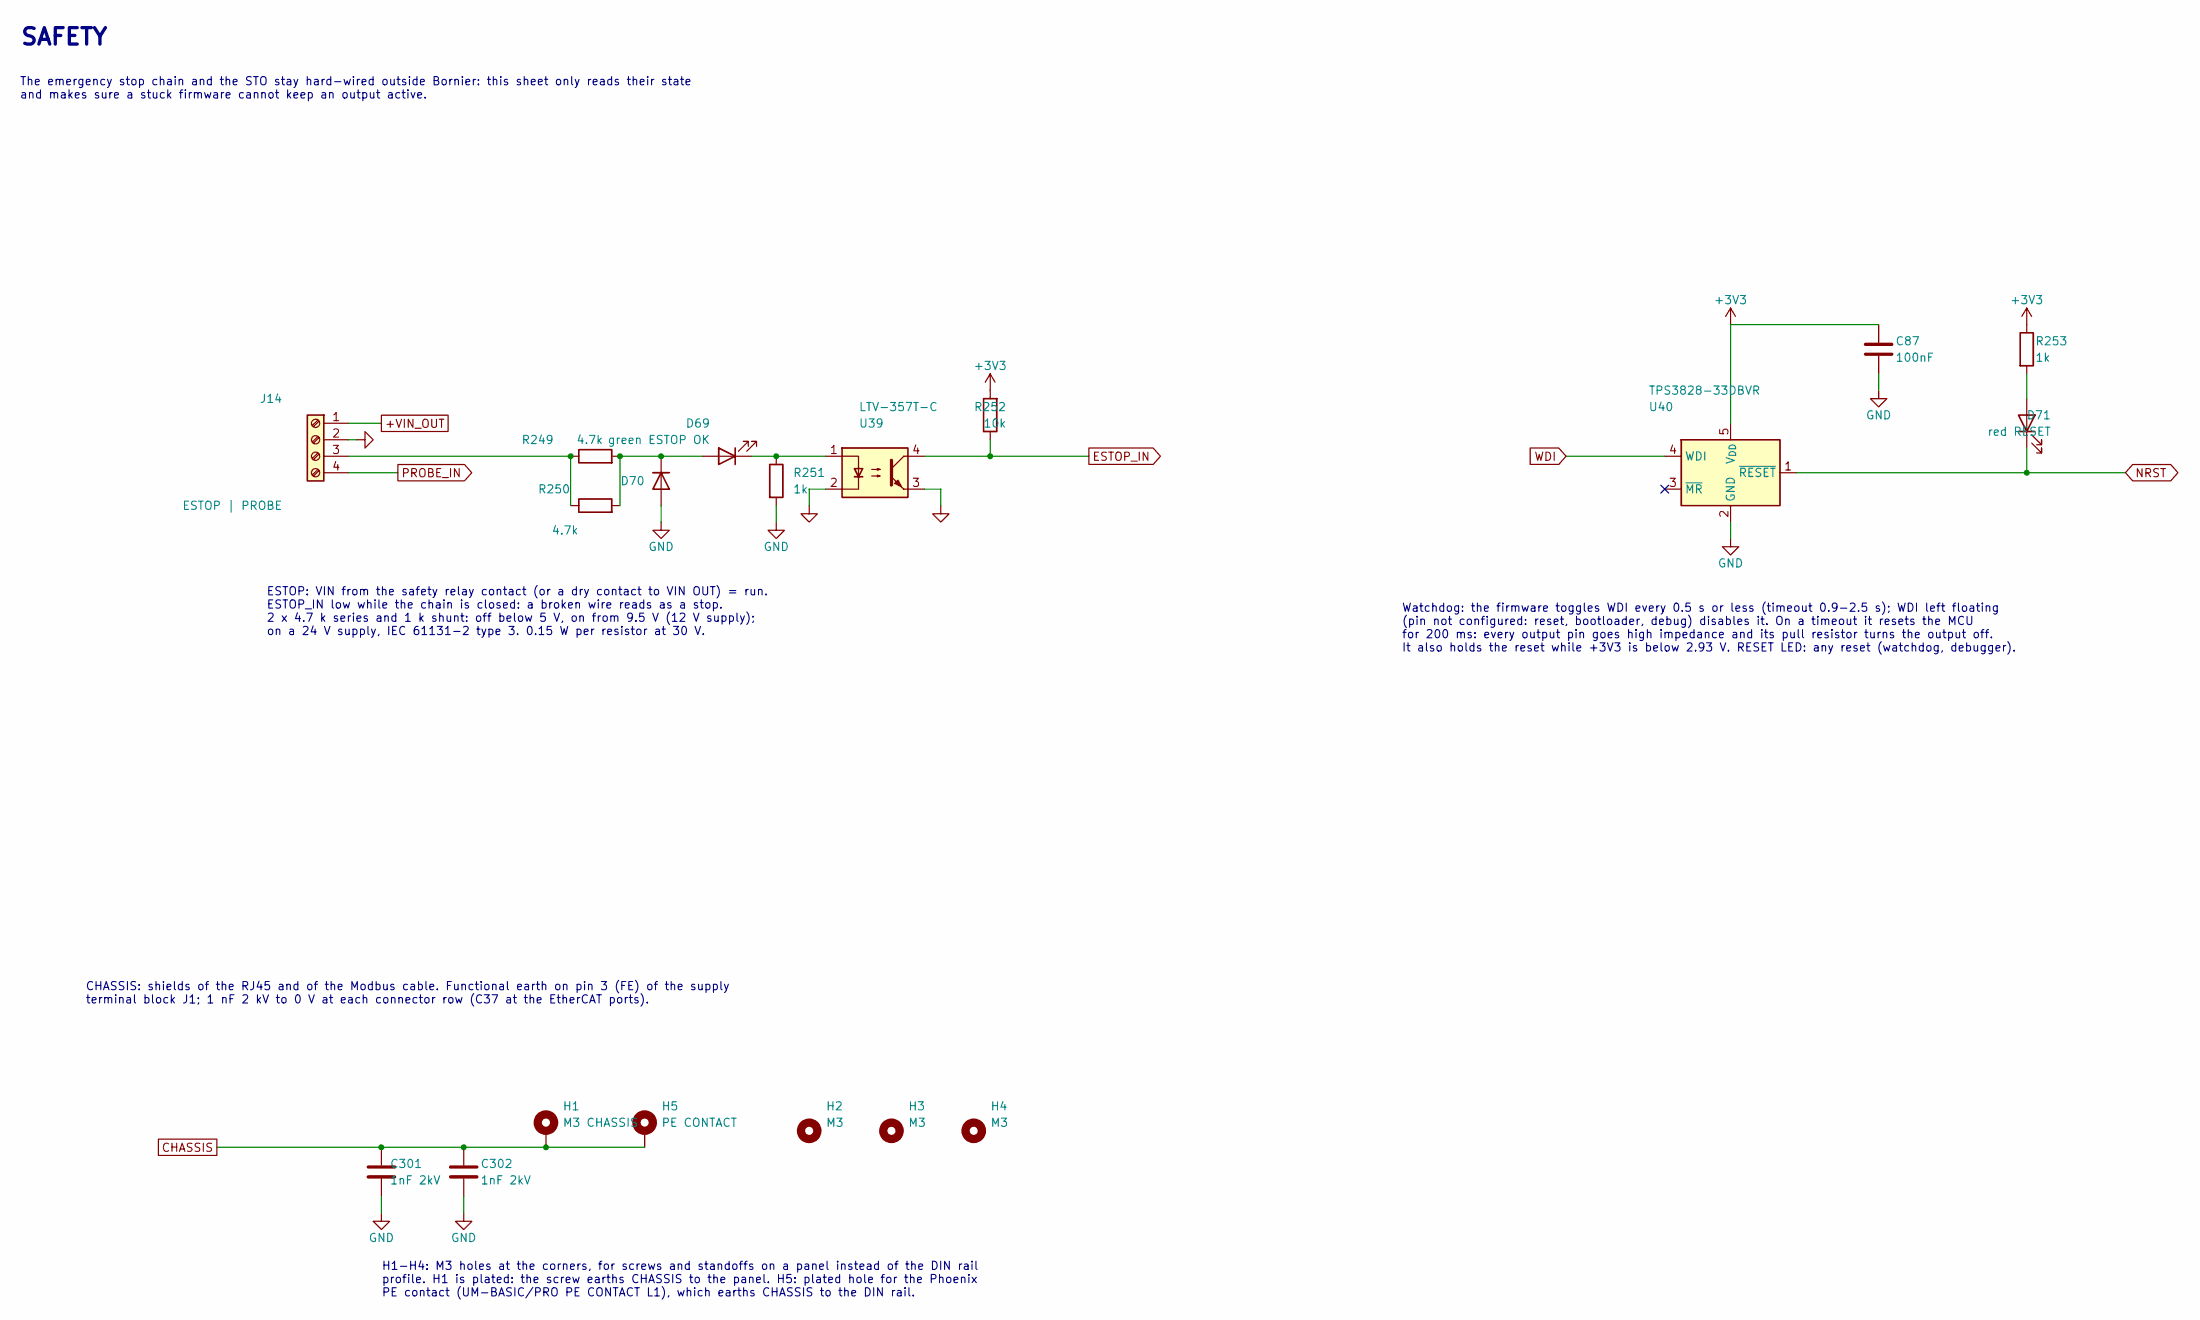
[picture p1: schematic safety.kicad_sch, Emergency stop state, external watchdog]

Parts:
C87: 100nF; C_0402_1005Metric; LCSC C307331
C301, C302: 1nF 2kV; C_1206_3216Metric; LCSC C9196
D69: green ESTOP OK; LED_0603_1608Metric; LCSC C2289
D70: 1N4148WS; D_SOD-323; LCSC C2128
D71: red RESET; LED_0603_1608Metric; LCSC C2286
H1: M3 CHASSIS; MountingHole_3.2mm_M3_Pad
H2, H3, H4: M3; MountingHole_3.2mm_M3
H5: PE CONTACT; MountingHole_3.2mm_M3_Pad
J14: ESTOP | PROBE; PhoenixContact_MC_1,5_4-G-3.81_1x04_P3.81mm_Horizontal; LCSC C441184
R249, R250: 4.7k; R_1206_3216Metric; LCSC C17936
R251, R253: 1k; R_0402_1005Metric; LCSC C11702
R252: 10k; R_0402_1005Metric; LCSC C25744
U39: LTV-357T-C; SO-4_4.4x3.6mm_P2.54mm; LCSC C119091
U40: TPS3828-33DBVR; SOT-23-5; LCSC C20032

Connections:
+3V3: C87.1, R252.2, R253.1, U40.5 (V_{DD}); also elsewhere on the board
+VIN_OUT: J14.1; also elsewhere on the board
CHASSIS: C301.1, C302.1, H1.1, H5.1; also elsewhere on the board
ESTOP_IN: R252.1, U39.4; also elsewhere on the board
GND: C87.2, C301.2, C302.2, D70.2 (A), J14.2, R251.2, U39.2, U39.3, U40.2 (GND); also elsewhere on the board
NRST: D71.1 (K), U40.1 (~RESET); also elsewhere on the board
unnamed: D69.2 (A), D70.1 (K), R249.2, R250.2
unnamed: D69.1 (K), R251.1, U39.1
unnamed: D71.2 (A), R253.2
unnamed: J14.3, R249.1, R250.1
PROBE_IN: J14.4; also elsewhere on the board
WDI: U40.4 (WDI); also elsewhere on the board

Notes on the sheet:
SAFETY
The emergency stop chain and the STO stay hard-wired outside Bornier: this sheet only reads their state and makes sure a stuck firmware cannot keep an output active.
ESTOP: VIN from the safety relay contact (or a dry contact to VIN OUT) = run. ESTOP_IN low while the chain is closed: a broken wire reads as a stop. 2 x 4.7 k series and 1 k shunt: off below 5 V, on from 9.5 V (12 V supply); on a 24 V supply, IEC 61131-2 type 3. 0.15 W per resistor at 30 V.
Watchdog: the firmware toggles WDI every 0.5 s or less (timeout 0.9-2.5 s); WDI left floating (pin not configured: reset, bootloader, debug) disables it. On a timeout it resets the MCU for 200 ms: every output pin goes high impedance and its pull resistor turns the output off. It also holds the res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
CHASSIS: shields of the RJ45 and of the Modbus cable. Functional earth on pin 3 (FE) of the supply terminal block J1; 1 nF 2 kV to 0 V at each connector row (C37 at the EtherCAT ports).
H1-H4: M3 holes at the corners, for screws and standoffs on a panel instead of the DIN rail profile. H1 is plated: the screw earths CHASSIS to the panel. H5: plated hole for the Phoenix PE contact (UM-BASIC/PRO PE CONTACT L1), which earths CHASSIS to the DIN rail.

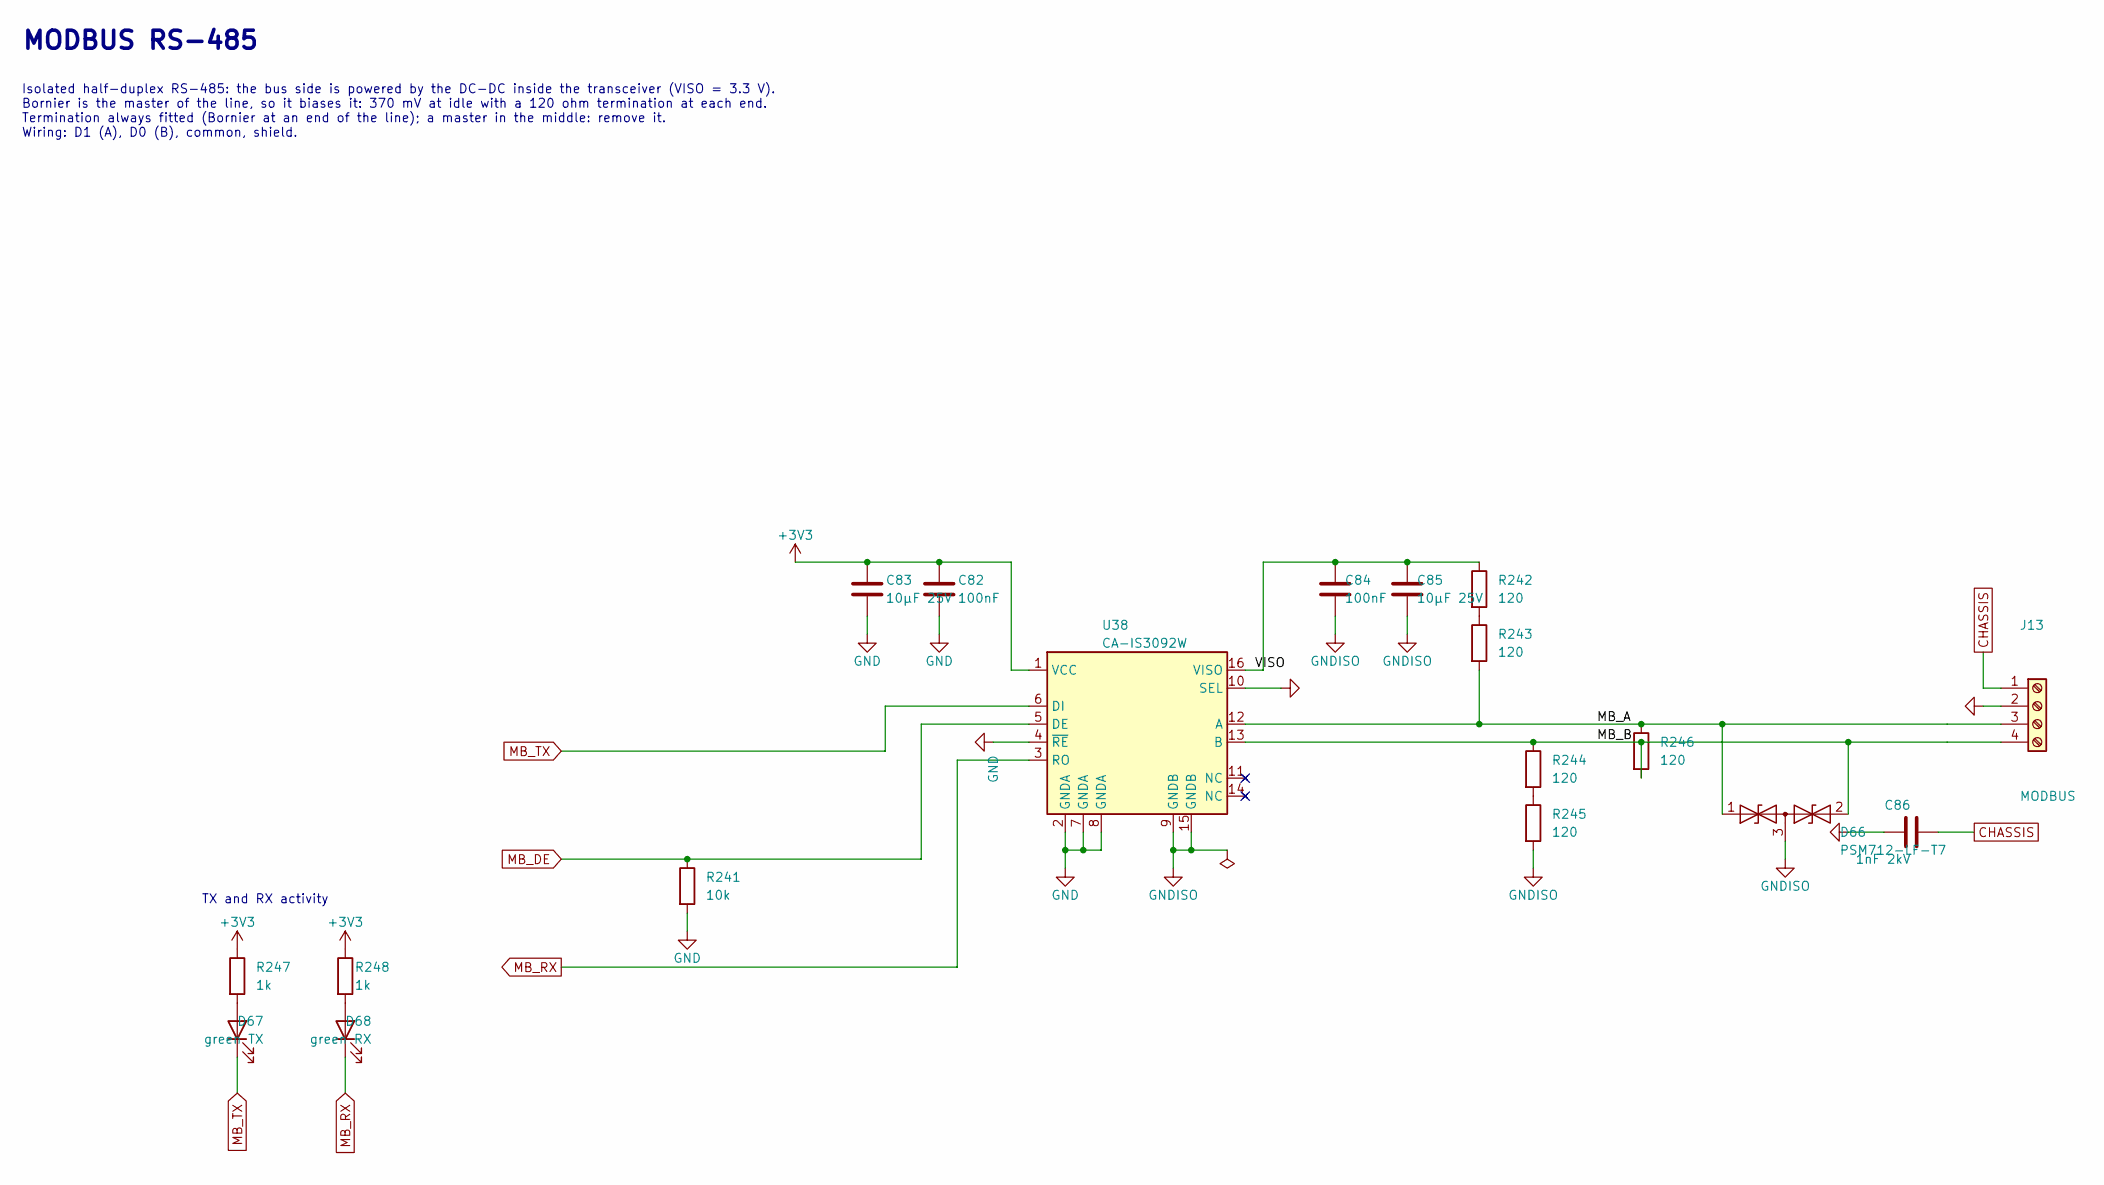
[picture p2: schematic modbus.kicad_sch, Modbus RS-485, isolated, Bornier is the line master]

Parts:
C82, C84: 100nF; C_0402_1005Metric; LCSC C307331
C83, C85: 10µF 25V; C_0805_2012Metric; LCSC C15850
C86: 1nF 2kV; C_1206_3216Metric; LCSC C9196
D66: PSM712-LF-T7; SOT-23; LCSC C32677
D67: green TX; LED_0603_1608Metric; LCSC C2289
D68: green RX; LED_0603_1608Metric; LCSC C2289
J13: MODBUS; PhoenixContact_MC_1,5_4-G-3.81_1x04_P3.81mm_Horizontal; LCSC C441184
R241: 10k; R_0402_1005Metric; LCSC C25744
R242, R243, R244, R245, R246: 120; R_0603_1608Metric; LCSC C22787
R247, R248: 1k; R_0402_1005Metric; LCSC C11702
U38: CA-IS3092W; SOIC-16W_7.5x10.3mm_P1.27mm; LCSC C2890051

Connections:
+3V3: C82.1, C83.1, R247.1, R248.1, U38.1 (VCC); also elsewhere on the board
/Modbus/MB_A: D66.1 (A1), J13.3, R243.2, R246.1, U38.12 (A)
/Modbus/MB_B: D66.2 (A2), J13.4, R244.1, R246.2, U38.13 (B)
/Modbus/VISO: C84.1, C85.1, R242.1, U38.16 (VISO)
CHASSIS: C86.2, J13.1; also elsewhere on the board
GND: C82.2, C83.2, R241.2, U38.2 (GNDA), U38.4 (~RE), U38.7 (GNDA), U38.8 (GNDA); also elsewhere on the board
GNDISO: C84.2, C85.2, C86.1, D66.3 (common), J13.2, R245.2, U38.9 (GNDB), U38.10 (SEL), U38.15 (GNDB)
MB_DE: R241.1, U38.5 (DE); also elsewhere on the board
MB_RX: D68.1 (K), U38.3 (RO); also elsewhere on the board
MB_TX: D67.1 (K), U38.6 (DI); also elsewhere on the board
unnamed: D67.2 (A), R247.2
unnamed: D68.2 (A), R248.2
unnamed: R242.2, R243.1
unnamed: R244.2, R245.1

Notes on the sheet:
MODBUS RS-485
Isolated half-duplex RS-485: the bus side is powered by the DC-DC inside the transceiver (VISO = 3.3 V). Bornier is the master of the line, so it biases it: 370 mV at idle with a 120 ohm termination at each end. Termination always fitted (Bornier at an end of the line); a master in the middle: remo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
TX and RX activity

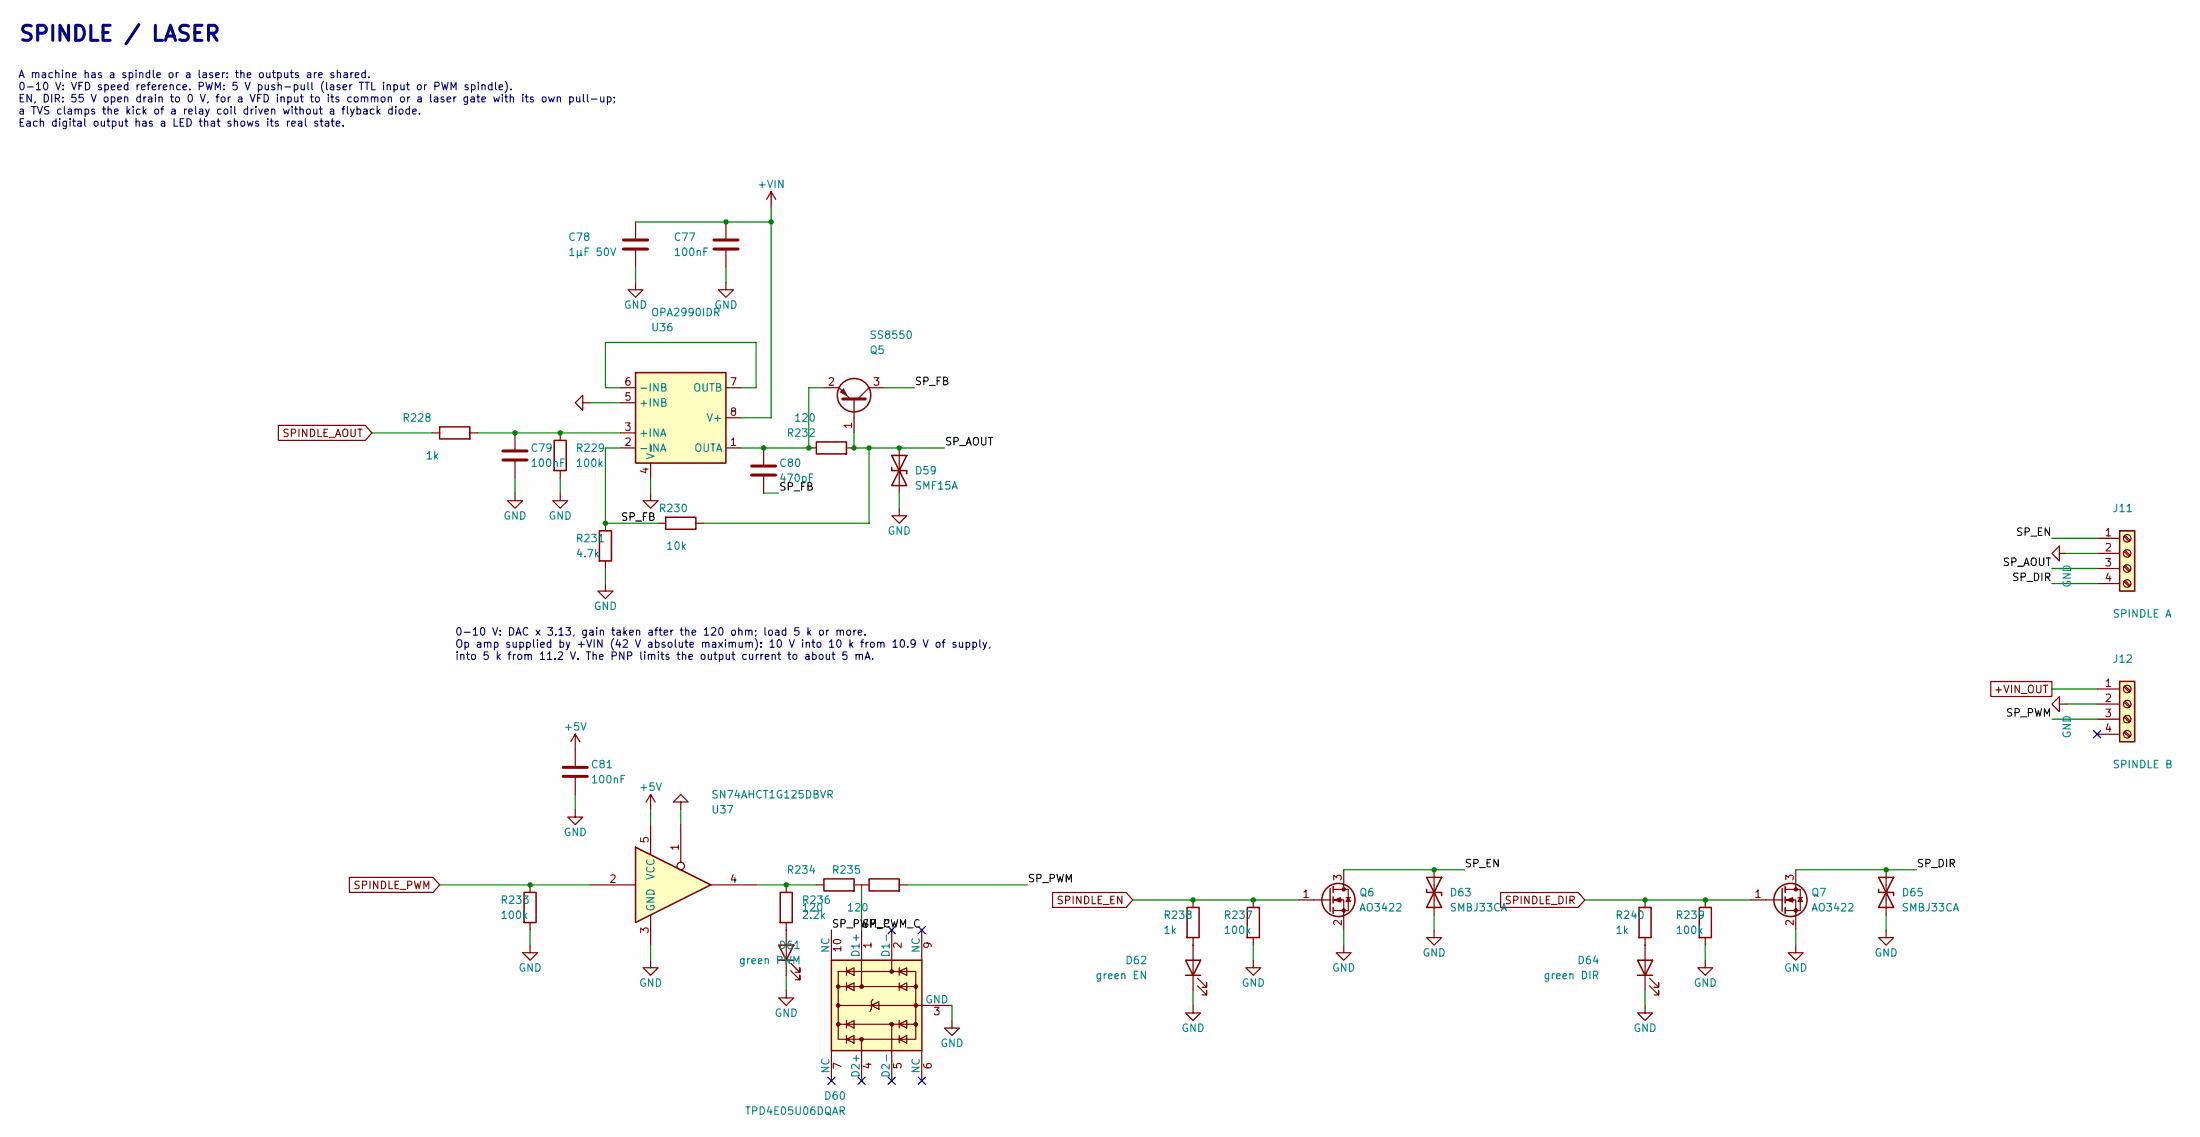
[picture p3: schematic spindle.kicad_sch, Spindle or laser: 0-10 V, PWM, enable, direction]

Parts:
C77, C79, C81: 100nF; C_0402_1005Metric; LCSC C307331
C78: 1µF 50V; C_0603_1608Metric; LCSC C15849
C80: 470pF; C_0402_1005Metric; LCSC C1537
D59: SMF15A; D_SOD-123F; LCSC C123802
D60: TPD4E05U06DQAR; USON-10_2.5x1.0mm_P0.5mm; LCSC C138714
D61: green PWM; LED_0603_1608Metric; LCSC C2289
D62: green EN; LED_0603_1608Metric; LCSC C2289
D63, D65: SMBJ33CA; D_SMB; LCSC C78420
D64: green DIR; LED_0603_1608Metric; LCSC C2289
J11: SPINDLE A; PhoenixContact_MC_1,5_4-G-3.81_1x04_P3.81mm_Horizontal; LCSC C441184
J12: SPINDLE B; PhoenixContact_MC_1,5_4-G-3.81_1x04_P3.81mm_Horizontal; LCSC C441184
Q5: SS8550; SOT-23; LCSC C8542
Q6, Q7: AO3422; SOT-23; LCSC C37130
R228, R238, R240: 1k; R_0402_1005Metric; LCSC C11702
R229, R233, R237, R239: 100k; R_0402_1005Metric; LCSC C25741
R230: 10k; R_0402_1005Metric; LCSC C25744
R231: 4.7k; R_0402_1005Metric; LCSC C25900
R232, R234, R235: 120; R_0603_1608Metric; LCSC C22787
R236: 2.2k; R_0402_1005Metric; LCSC C25879
U36: OPA2990IDR; SOIC-8_3.9x4.9mm_P1.27mm; LCSC C2058283
U37: SN74AHCT1G125DBVR; SOT-23-5; LCSC C7484

Connections:
+5V: C81.1, U37.5 (VCC); also elsewhere on the board
+VIN: C77.1, C78.1, U36.8 (V+); also elsewhere on the board
+VIN_OUT: J12.1; also elsewhere on the board
/Spindle/SP_AOUT: D59.1 (A1), J11.3, Q5.1 (B), R230.1, R232.2
/Spindle/SP_DIR: D65.1 (A1), J11.4, Q7.3 (D)
/Spindle/SP_EN: D63.1 (A1), J11.1, Q6.3 (D)
/Spindle/SP_FB: C80.2, Q5.3 (C), R230.2, R231.1, U36.2 (-INA)
/Spindle/SP_PWM: J12.3, R235.2
/Spindle/SP_PWM_C: D60.1 (D1+), D60.10 (NC), R234.2, R235.1
GND: C77.2, C78.2, C79.2, C81.2, D59.2 (A2), D60.3 (GND), D60.8 (GND), D61.1 (K), D62.1 (K), D63.2 (A2), D64.1 (K), D65.2 (A2), J11.2, J12.2, Q6.2 (S), Q7.2 (S), R229.2, R231.2, R233.2, R237.2, R239.2, U36.4 (V-), U36.5 (+INB), U37.1, U37.3 (GND); also elsewhere on the board
unnamed: D61.2 (A), R236.2
unnamed: D62.2 (A), R238.2
unnamed: D64.2 (A), R240.2
unnamed: C80.1, Q5.2 (E), R232.1, U36.1 (OUTA)
unnamed: R234.1, R236.1, U37.4
unnamed: C79.1, R228.2, R229.1, U36.3 (+INA)
unnamed: U36.6 (-INB), U36.7 (OUTB)
SPINDLE_AOUT: R228.1; also elsewhere on the board
SPINDLE_DIR: Q7.1 (G), R239.1, R240.1; also elsewhere on the board
SPINDLE_EN: Q6.1 (G), R237.1, R238.1; also elsewhere on the board
SPINDLE_PWM: R233.1, U37.2; also elsewhere on the board

Notes on the sheet:
SPINDLE / LASER
A machine has a spindle or a laser: the outputs are shared. 0-10 V: VFD speed reference. PWM: 5 V push-pull (laser TTL input or PWM spindle). EN, DIR: 55 V open drain to 0 V, for a VFD input to its common or a laser gate with its own pull-up; a TVS clamps the kick of a relay coil driven without a f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
0-10 V: DAC x 3.13, gain taken after the 120 ohm; load 5 k or more. Op amp supplied by +VIN (42 V absolute maximum): 10 V into 10 k from 10.9 V of supply, into 5 k from 11.2 V. The PNP limits the output current to about 5 mA.

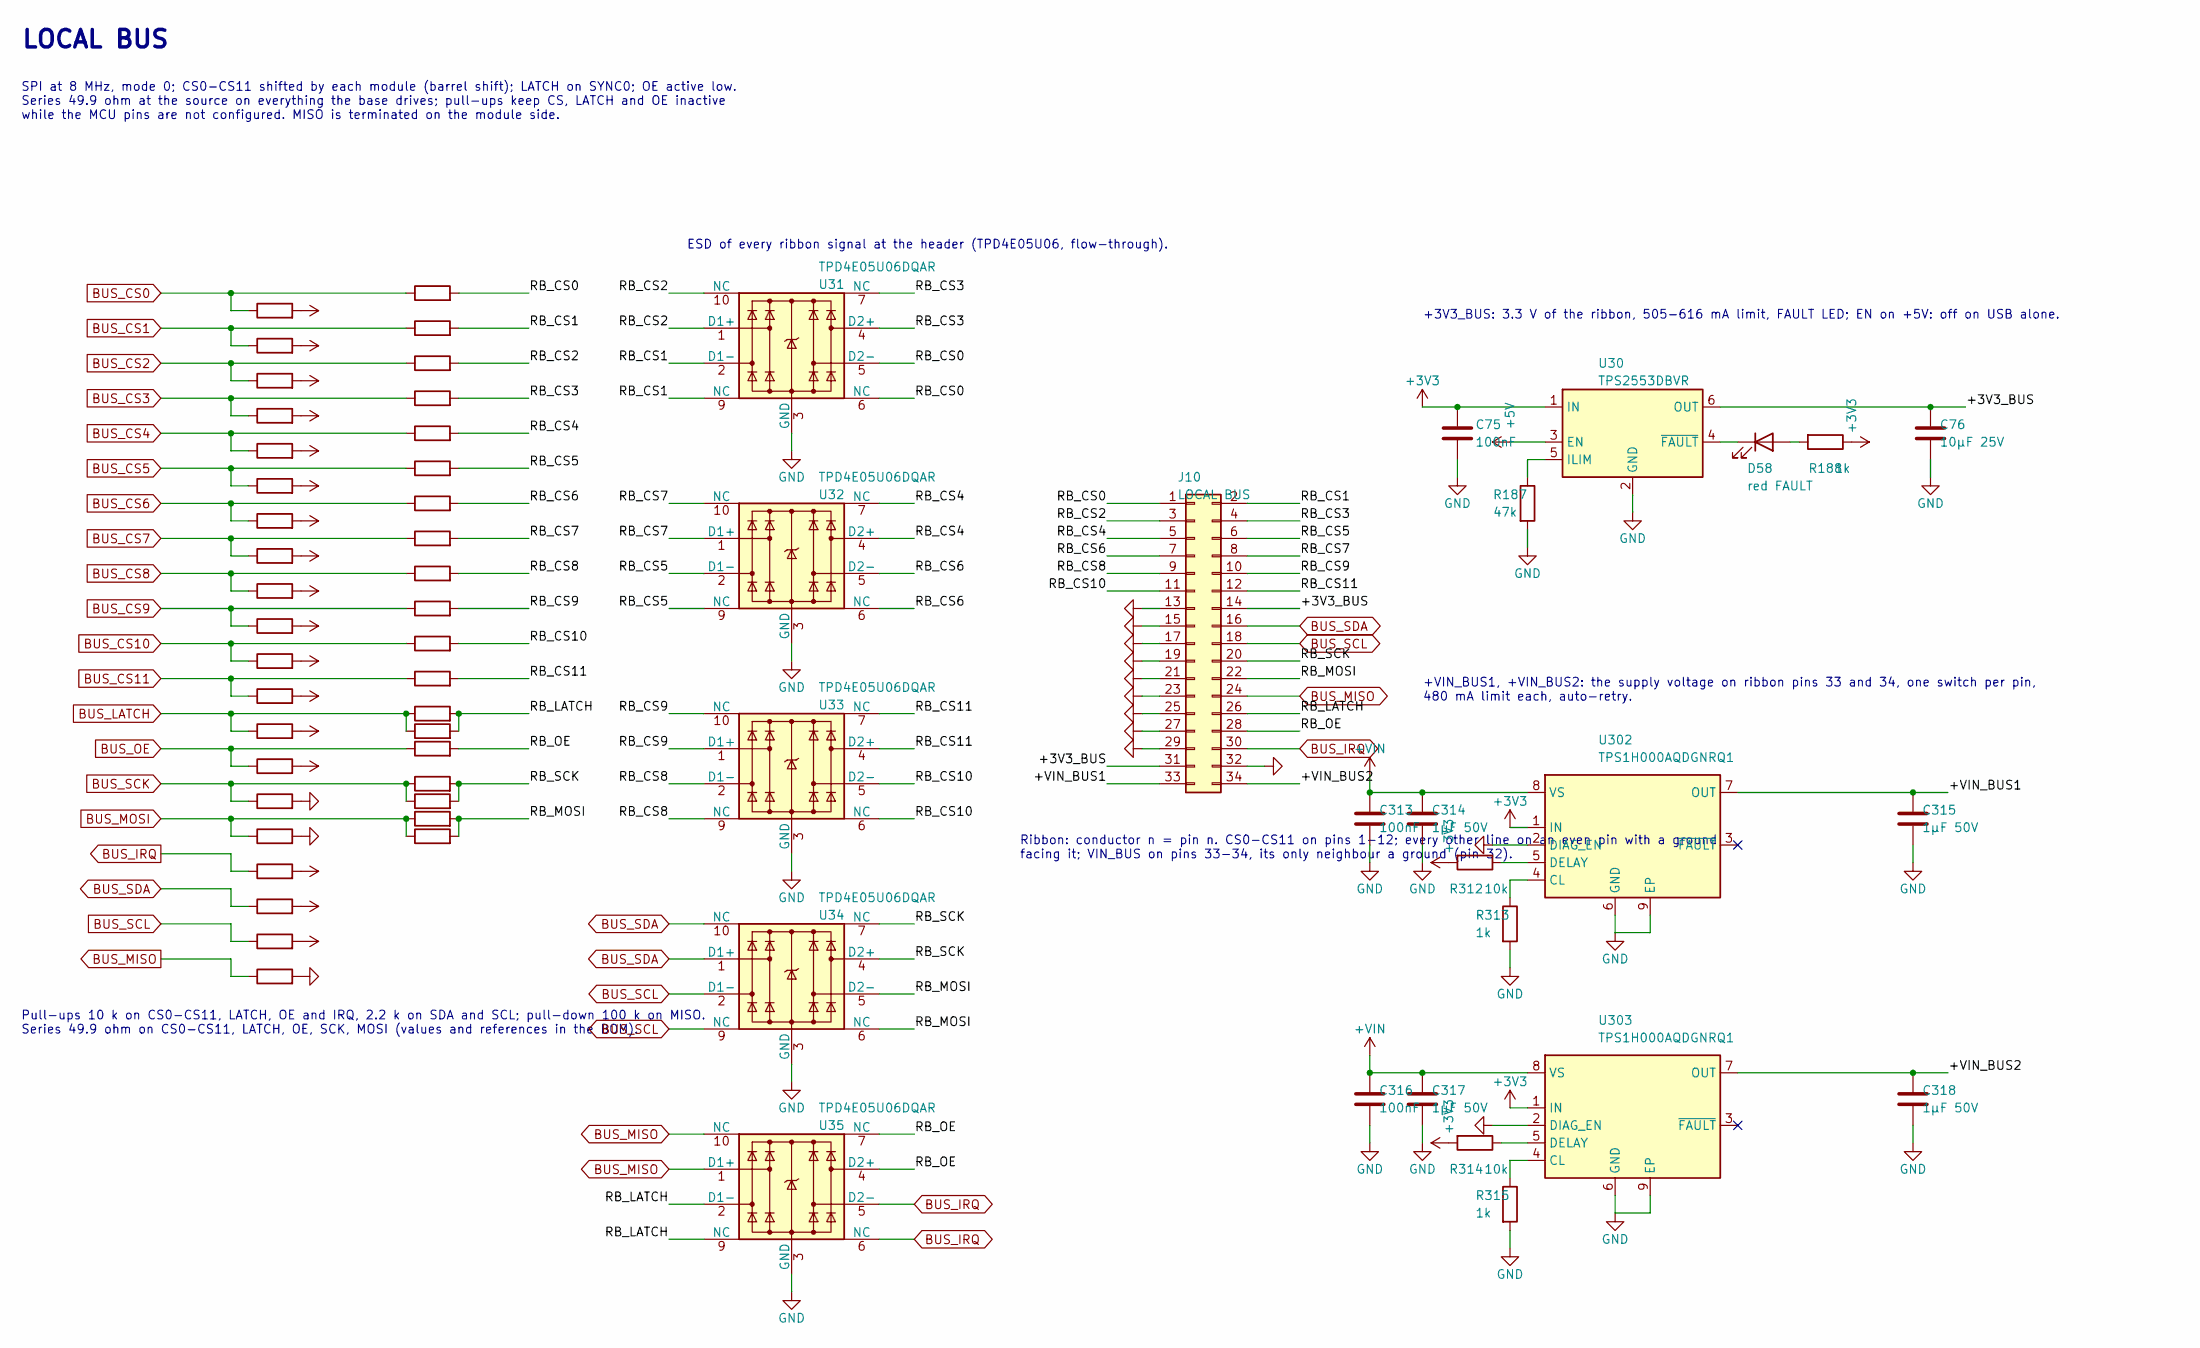
[picture p4: schematic bus.kicad_sch, Local bus: HE10 2x17 ribbon to the extension modules]

Parts:
C75, C313, C316: 100nF; C_0402_1005Metric; LCSC C307331
C76: 10µF 25V; C_0805_2012Metric; LCSC C15850
C314, C315, C317, C318: 1µF 50V; C_0603_1608Metric; LCSC C15849
D58: red FAULT; LED_0603_1608Metric; LCSC C2286
J10: LOCAL BUS; IDC-Header_2x17_P2.54mm_Vertical; LCSC C20920
R187: 47k; R_0402_1005Metric; LCSC C25792
R188, R313, R315: 1k; R_0402_1005Metric; LCSC C11702
R189, R190, R191, R192, R193, R194, R195, R196, R197, R198, R199, R200, R201, R202, R222, R312, R314: 10k; R_0402_1005Metric; LCSC C25744
R203, R204, R205, R206, R207, R208, R209, R210, R211, R212, R213, R214, R215, R216, R217, R218, R219, R220, R221: 49.9; R_0603_1608Metric; LCSC C23185
R223, R224, R225: 100k; R_0402_1005Metric; LCSC C25741
R226, R227: 2.2k; R_0402_1005Metric; LCSC C25879
U30: TPS2553DBVR; SOT-23-6; LCSC C55266
U31, U32, U33, U34, U35: TPD4E05U06DQAR; USON-10_2.5x1.0mm_P0.5mm; LCSC C138714
U302, U303: TPS1H000AQDGNRQ1; HVSSOP-8-1EP_3x3mm_P0.65mm_EP1.57x1.89mm; LCSC C2653764

Connections:
+3V3: C75.1, R188.1, R189.2, R190.2, R191.2, R192.2, R193.2, R194.2, R195.2, R196.2, R197.2, R198.2, R199.2, R200.2, R201.2, R202.2, R222.2, R226.2, R227.2, R312.2, R314.2, U30.1 (IN), U302.1 (IN), U303.1 (IN); also elsewhere on the board
+5V: U30.3 (EN); also elsewhere on the board
+VIN: C313.1, C314.1, C316.1, C317.1, U302.8 (VS), U303.8 (VS); also elsewhere on the board
/Local bus/+3V3_BUS: C76.1, J10.14, J10.31, U30.6 (OUT)
/Local bus/+VIN_BUS1: C315.1, J10.33, U302.7 (OUT)
/Local bus/+VIN_BUS2: C318.1, J10.34, U303.7 (OUT)
/Local bus/RB_CS0: J10.1, R203.2, U31.5 (D2-), U31.6 (NC)
/Local bus/RB_CS1: J10.2, R204.2, U31.2 (D1-), U31.9 (NC)
/Local bus/RB_CS2: J10.3, R205.2, U31.1 (D1+), U31.10 (NC)
/Local bus/RB_CS3: J10.4, R206.2, U31.4 (D2+), U31.7 (NC)
/Local bus/RB_CS4: J10.5, R207.2, U32.4 (D2+), U32.7 (NC)
/Local bus/RB_CS5: J10.6, R208.2, U32.2 (D1-), U32.9 (NC)
/Local bus/RB_CS6: J10.7, R209.2, U32.5 (D2-), U32.6 (NC)
/Local bus/RB_CS7: J10.8, R210.2, U32.1 (D1+), U32.10 (NC)
/Local bus/RB_CS8: J10.9, R211.2, U33.2 (D1-), U33.9 (NC)
/Local bus/RB_CS9: J10.10, R212.2, U33.1 (D1+), U33.10 (NC)
/Local bus/RB_CS10: J10.11, R213.2, U33.5 (D2-), U33.6 (NC)
/Local bus/RB_CS11: J10.12, R214.2, U33.4 (D2+), U33.7 (NC)
/Local bus/RB_LATCH: J10.26, R217.2, R221.2, U35.2 (D1-), U35.9 (NC)
/Local bus/RB_MOSI: J10.22, R216.2, R220.2, U34.5 (D2-), U34.6 (NC)
/Local bus/RB_OE: J10.28, R218.2, U35.4 (D2+), U35.7 (NC)
/Local bus/RB_SCK: J10.20, R215.2, R219.2, U34.4 (D2+), U34.7 (NC)
BUS_CS0: R189.1, R203.1; also elsewhere on the board
BUS_CS1: R190.1, R204.1; also elsewhere on the board
BUS_CS2: R191.1, R205.1; also elsewhere on the board
BUS_CS3: R192.1, R206.1; also elsewhere on the board
BUS_CS4: R193.1, R207.1; also elsewhere on the board
BUS_CS5: R194.1, R208.1; also elsewhere on the board
BUS_CS6: R195.1, R209.1; also elsewhere on the board
BUS_CS7: R196.1, R210.1; also elsewhere on the board
BUS_CS8: R197.1, R211.1; also elsewhere on the board
BUS_CS9: R198.1, R212.1; also elsewhere on the board
BUS_CS10: R199.1, R213.1; also elsewhere on the board
BUS_CS11: R200.1, R214.1; also elsewhere on the board
BUS_IRQ: J10.30, R222.1, U35.5 (D2-), U35.6 (NC); also elsewhere on the board
BUS_LATCH: R201.1, R217.1, R221.1; also elsewhere on the board
BUS_MISO: J10.24, R223.1, U35.1 (D1+), U35.10 (NC); also elsewhere on the board
BUS_MOSI: R216.1, R220.1, R225.1; also elsewhere on the board
BUS_OE: R202.1, R218.1; also elsewhere on the board
BUS_SCK: R215.1, R219.1, R224.1; also elsewhere on the board
BUS_SCL: J10.18, R227.1, U34.2 (D1-), U34.9 (NC); also elsewhere on the board
BUS_SDA: J10.16, R226.1, U34.1 (D1+), U34.10 (NC); also elsewhere on the board
GND: C75.2, C76.2, C313.2, C314.2, C315.2, C316.2, C317.2, C318.2, J10.13, J10.15, J10.17, J10.19, J10.21, J10.23, J10.25, J10.27, J10.29, J10.32, R187.2, R223.2, R224.2, R225.2, R313.2, R315.2, U30.2 (GND), U31.3 (GND), U31.8 (GND), U32.3 (GND), U32.8 (GND), U33.3 (GND), U33.8 (GND), U34.3 (GND), U34.8 (GND), U35.3 (GND), U35.8 (GND), U302.2 (DIAG_EN), U302.6 (GND), U302.9 (EP), U303.2 (DIAG_EN), U303.6 (GND), U303.9 (EP); also elsewhere on the board
unnamed: D58.2 (A), R188.2
unnamed: D58.1 (K), U30.4 (~FAULT)
unnamed: R187.1, U30.5 (ILIM)
unnamed: R313.1, U302.4 (CL)
unnamed: R312.1, U302.5 (DELAY)
unnamed: R315.1, U303.4 (CL)
unnamed: R314.1, U303.5 (DELAY)

Notes on the sheet:
LOCAL BUS
SPI at 8 MHz, mode 0; CS0-CS11 shifted by each module (barrel shift); LATCH on SYNC0; OE active low. Series 49.9 ohm at the source on everything the base drives; pull-ups keep CS, LATCH and OE inactive while the MCU pins are not configured. MISO is terminated on the module side.
Pull-ups 10 k on CS0-CS11, LATCH, OE and IRQ, 2.2 k on SDA and SCL; pull-down 100 k on MISO. Series 49.9 ohm on CS0-CS11, LATCH, OE, SCK, MOSI (values and references in the BOM).
Ribbon: conductor n = pin n. CS0-CS11 on pins 1-12; every other line on an even pin with a ground facing it; VIN_BUS on pins 33-34, its only neighbour a ground (pin 32).
ESD of every ribbon signal at the header (TPD4E05U06, flow-through).
+3V3_BUS: 3.3 V of the ribbon, 505-616 mA limit, FAULT LED; EN on +5V: off on USB alone.
+VIN_BUS1, +VIN_BUS2: the supply voltage on ribbon pins 33 and 34, one switch per pin, 480 mA limit each, auto-retry.
