bornier-dev/bornier/hardware/base/kicad/base.kicad_pcb

## KiCad design hardware/base/kicad/base.kicad_pcb (continued)

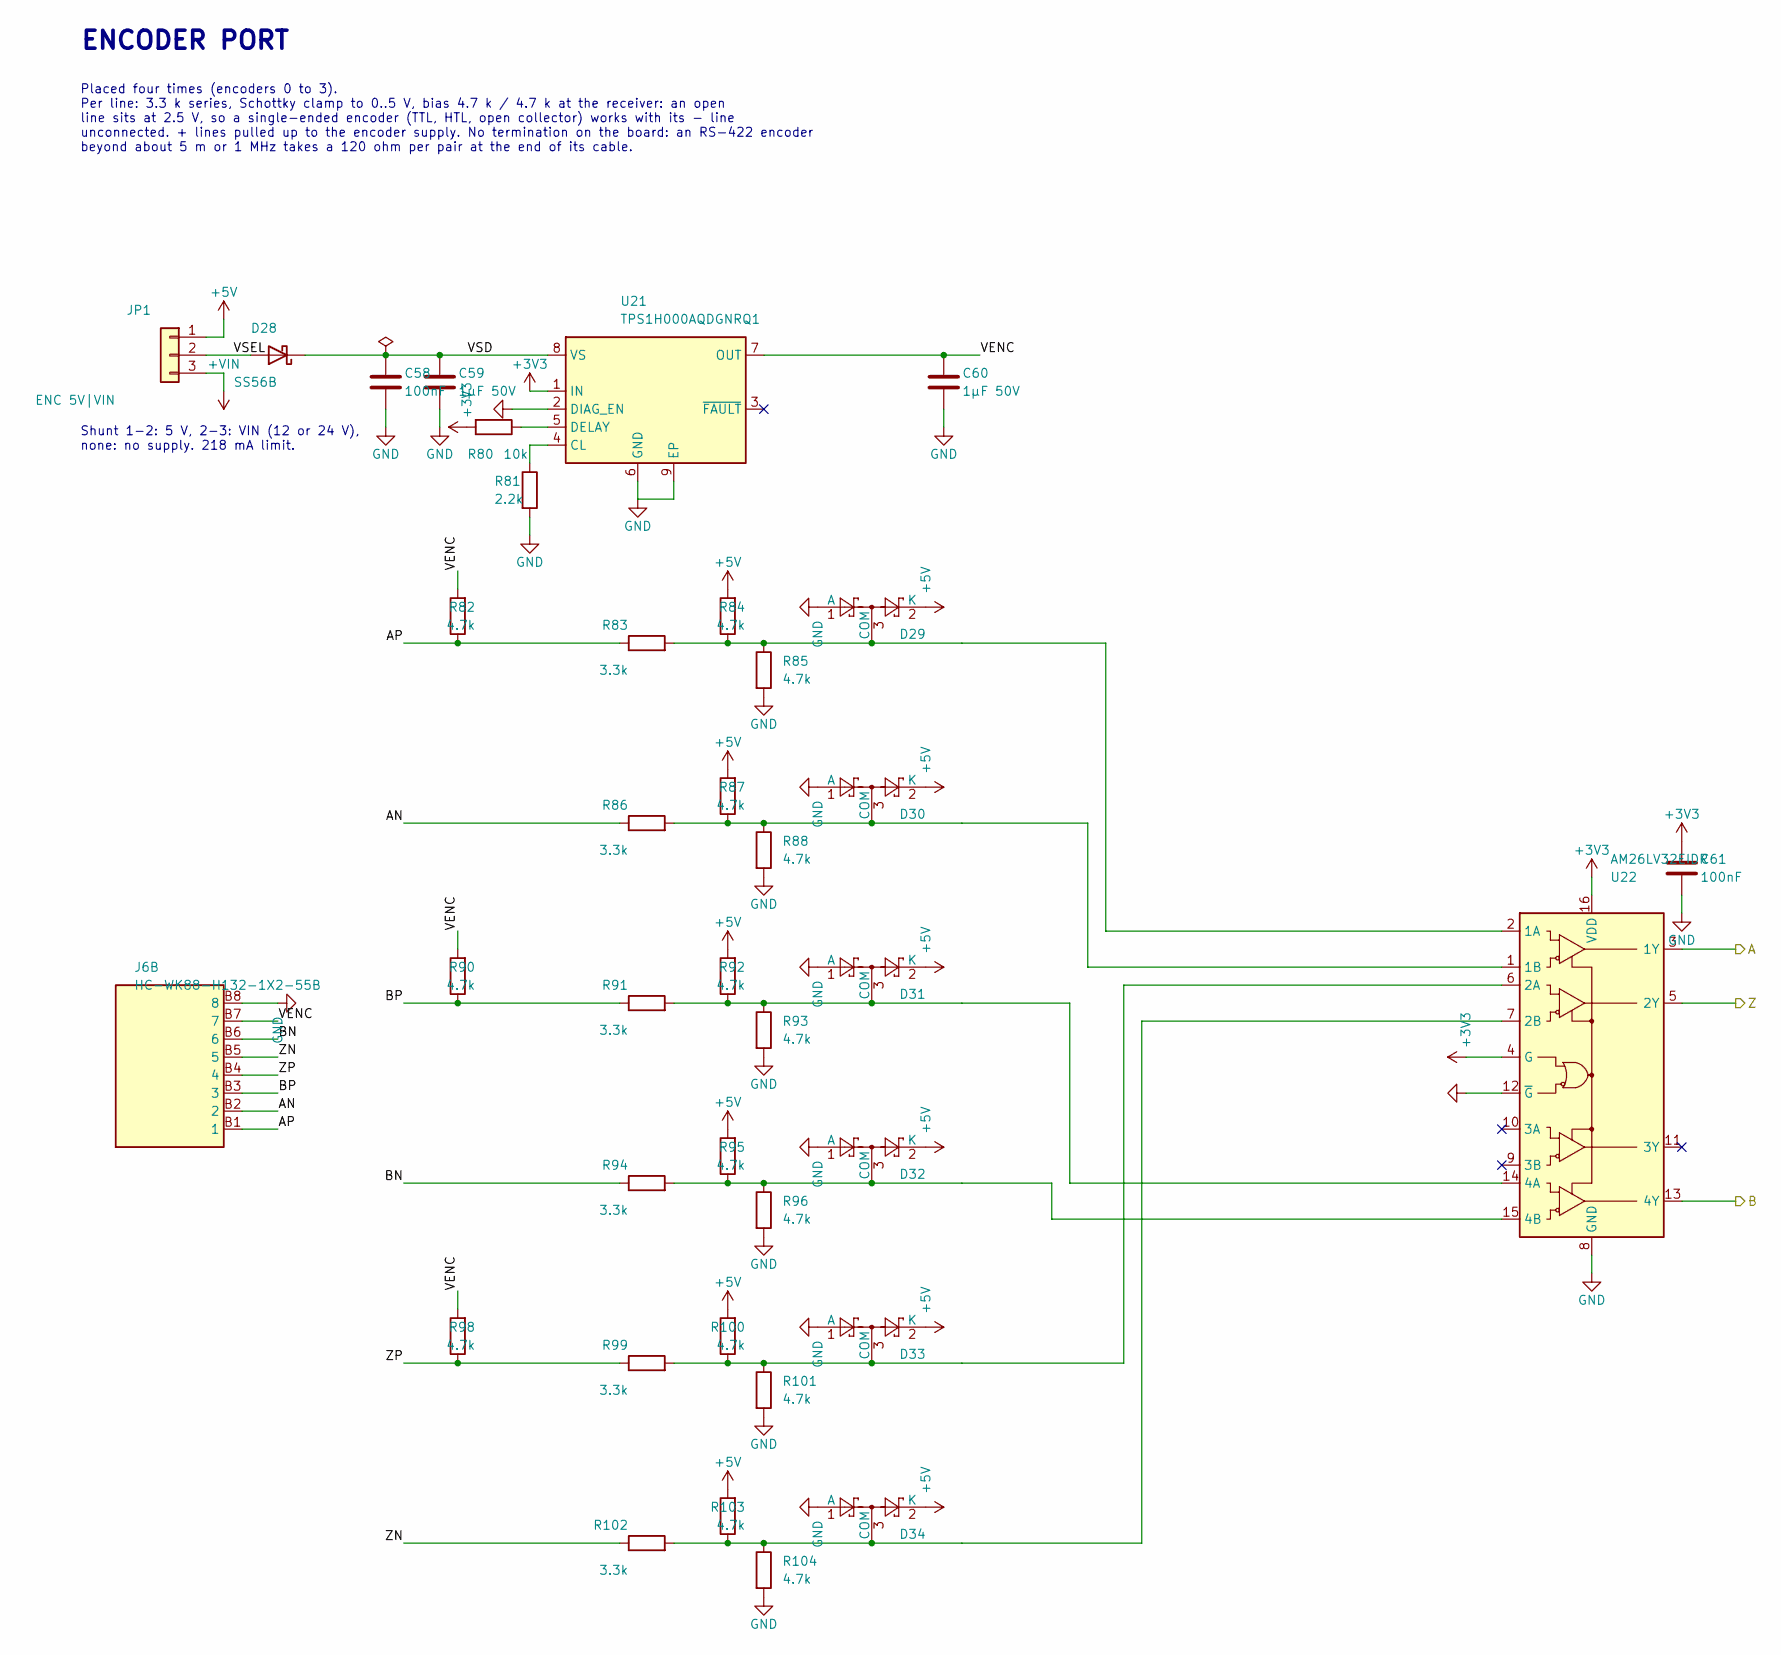
[picture p5: schematic encoder.kicad_sch, Encoder port: RS-422, TTL or HTL, 5 V or VIN (4 instances)]

Parts:
C58, C61: 100nF; C_0402_1005Metric; LCSC C307331
C59, C60: 1µF 50V; C_0603_1608Metric; LCSC C15849
D28: SS56B; D_SMB; LCSC C14651
D29, D30, D31, D32, D33, D34: BAT54S; SOT-23; LCSC C12765
J6: HC-WK88-H132-1X2-55B; RJ45x2_HongCheng_HC-WK88-H132-1X2-55B; LCSC C7501828
JP1: ENC 5V|VIN; PinHeader_1x03_P2.54mm_Vertical; LCSC C2937625
R80: 10k; R_0402_1005Metric; LCSC C25744
R81: 2.2k; R_0402_1005Metric; LCSC C25879
R82, R90, R98: 4.7k; R_1206_3216Metric; LCSC C17936
R83, R86, R91, R94, R99, R102: 3.3k; R_1206_3216Metric; LCSC C26032
R84, R85, R87, R88, R92, R93, R95, R96, R100, R101, R103, R104: 4.7k; R_0402_1005Metric; LCSC C25900
U21: TPS1H000AQDGNRQ1; HVSSOP-8-1EP_3x3mm_P0.65mm_EP1.57x1.89mm; LCSC C2653764
U22: AM26LV32EIDR; SOIC-16_3.9x9.9mm_P1.27mm; LCSC C527448

Connections:
+3V3: C61.1, R80.2, U21.1 (IN), U22.4 (G), U22.16 (VDD); also elsewhere on the board
+5V: D29.2 (K), D30.2 (K), D31.2 (K), D32.2 (K), D33.2 (K), D34.2 (K), JP1.1, R84.2, R87.2, R92.2, R95.2, R100.2, R103.2; also elsewhere on the board
+VIN: JP1.3; also elsewhere on the board
/Encoder 0/AN: J6.B2 (2), R86.1
/Encoder 0/AP: J6.B1 (1), R82.1, R83.1
/Encoder 0/BN: J6.B6 (6), R94.1
/Encoder 0/BP: J6.B3 (3), R90.1, R91.1
/Encoder 0/VENC: C60.1, J6.B7 (7), R82.2, R90.2, R98.2, U21.7 (OUT)
/Encoder 0/VSD: C58.1, C59.1, D28.1 (K), U21.8 (VS)
/Encoder 0/VSEL: D28.2 (A), JP1.2
/Encoder 0/ZN: J6.B5 (5), R102.1
/Encoder 0/ZP: J6.B4 (4), R98.1, R99.1
ENC0_A: U22.3 (1Y); also elsewhere on the board
ENC0_B: U22.13 (4Y); also elsewhere on the board
ENC0_Z: U22.5 (2Y); also elsewhere on the board
GND: C58.2, C59.2, C60.2, C61.2, D29.1 (A), D30.1 (A), D31.1 (A), D32.1 (A), D33.1 (A), D34.1 (A), J6.B8 (8), R81.2, R85.2, R88.2, R93.2, R96.2, R101.2, R104.2, U21.2 (DIAG_EN), U21.6 (GND), U21.9 (EP), U22.8 (GND), U22.12 (~G); also elsewhere on the board
unnamed: D29.3 (COM), R83.2, R84.1, R85.1, U22.2 (1A)
unnamed: D30.3 (COM), R86.2, R87.1, R88.1, U22.1 (1B)
unnamed: D31.3 (COM), R91.2, R92.1, R93.1, U22.14 (4A)
unnamed: D32.3 (COM), R94.2, R95.1, R96.1, U22.15 (4B)
unnamed: D33.3 (COM), R99.2, R100.1, R101.1, U22.6 (2A)
unnamed: D34.3 (COM), R102.2, R103.1, R104.1, U22.7 (2B)
unnamed: R81.1, U21.4 (CL)
unnamed: R80.1, U21.5 (DELAY)

Parts of its further copies:
C62, C65, C66, C69, C70, C73: 100nF; C_0402_1005Metric; LCSC C307331
C63, C64, C67, C68, C71, C72: 1µF 50V; C_0603_1608Metric; LCSC C15849
D35, D42, D49: SS56B; D_SMB; LCSC C14651
D36, D37, D38, D39, D40, D41, D43, D44, D45, D46, D47, D48, D50, D51, D52, D53, D54, D55: BAT54S; SOT-23; LCSC C12765
J7, J8, J9: HC-WK88-H132-1X2-55B; RJ45x2_HongCheng_HC-WK88-H132-1X2-55B; LCSC C7501828
JP2, JP3, JP4: ENC 5V|VIN; PinHeader_1x03_P2.54mm_Vertical; LCSC C2937625
R106, R132, R158: 10k; R_0402_1005Metric; LCSC C25744
R107, R133, R159: 2.2k; R_0402_1005Metric; LCSC C25879
R108, R116, R124, R134, R142, R150, R160, R168, R176: 4.7k; R_1206_3216Metric; LCSC C17936
R109, R112, R117, R120, R125, R128, R135, R138, R143, R146, R151, R154, R161, R164, R169, R172, R177, R180: 3.3k; R_1206_3216Metric; LCSC C26032
R110, R111, R113, R114, R118, R119, R121, R122, R126, R127, R129, R130, R136, R137, R139, R140, R144, R145, R147, R148, R152, R153, R155, R156, R162, R163, R165, R166, R170, R171, R173, R174, R178, R179, R181, R182: 4.7k; R_0402_1005Metric; LCSC C25900
U23, U25, U27: TPS1H000AQDGNRQ1; HVSSOP-8-1EP_3x3mm_P0.65mm_EP1.57x1.89mm; LCSC C2653764
U24, U26, U28: AM26LV32EIDR; SOIC-16_3.9x9.9mm_P1.27mm; LCSC C527448

Connections of its further copies:
+3V3: C65.1, C69.1, C73.1, R106.2, R132.2, R158.2, U23.1 (IN), U24.4 (G), U24.16 (VDD), U25.1 (IN), U26.4 (G), U26.16 (VDD), U27.1 (IN), U28.4 (G), U28.16 (VDD); also elsewhere on the board
+5V: D36.2 (K), D37.2 (K), D38.2 (K), D39.2 (K), D40.2 (K), D41.2 (K), D43.2 (K), D44.2 (K), D45.2 (K), D46.2 (K), D47.2 (K), D48.2 (K), D50.2 (K), D51.2 (K), D52.2 (K), D53.2 (K), D54.2 (K), D55.2 (K), JP2.1, JP3.1, JP4.1, R110.2, R113.2, R118.2, R121.2, R126.2, R129.2, R136.2, R139.2, R144.2, R147.2, R152.2, R155.2, R162.2, R165.2, R170.2, R173.2, R178.2, R181.2; also elsewhere on the board
+VIN: JP2.3, JP3.3, JP4.3; also elsewhere on the board
+VIN_OUT: J7.A7 (7), J8.A7 (7), J9.A7 (7); also elsewhere on the board
/Drive 1/ALM_IN: J7.A5 (5); also elsewhere on the board
/Drive 1/DIR_N: J7.A6 (6); also elsewhere on the board
/Drive 1/DIR_P: J7.A3 (3); also elsewhere on the board
/Drive 1/ENA_OUT: J7.A4 (4); also elsewhere on the board
/Drive 1/STEP_N: J7.A2 (2); also elsewhere on the board
/Drive 1/STEP_P: J7.A1 (1); also elsewhere on the board
/Drive 2/ALM_IN: J8.A5 (5); also elsewhere on the board
/Drive 2/DIR_N: J8.A6 (6); also elsewhere on the board
/Drive 2/DIR_P: J8.A3 (3); also elsewhere on the board
/Drive 2/ENA_OUT: J8.A4 (4); also elsewhere on the board
/Drive 2/STEP_N: J8.A2 (2); also elsewhere on the board
/Drive 2/STEP_P: J8.A1 (1); also elsewhere on the board
/Drive 3/ALM_IN: J9.A5 (5); also elsewhere on the board
/Drive 3/DIR_N: J9.A6 (6); also elsewhere on the board
/Drive 3/DIR_P: J9.A3 (3); also elsewhere on the board
/Drive 3/ENA_OUT: J9.A4 (4); also elsewhere on the board
/Drive 3/STEP_N: J9.A2 (2); also elsewhere on the board
/Drive 3/STEP_P: J9.A1 (1); also elsewhere on the board
/Encoder 1/AN: J7.B2 (2), R112.1
/Encoder 1/AP: J7.B1 (1), R108.1, R109.1
/Encoder 1/BN: J7.B6 (6), R120.1
/Encoder 1/BP: J7.B3 (3), R116.1, R117.1
/Encoder 1/VENC: C64.1, J7.B7 (7), R108.2, R116.2, R124.2, U23.7 (OUT)
/Encoder 1/VSD: C62.1, C63.1, D35.1 (K), U23.8 (VS)
/Encoder 1/VSEL: D35.2 (A), JP2.2
/Encoder 1/ZN: J7.B5 (5), R128.1
/Encoder 1/ZP: J7.B4 (4), R124.1, R125.1
/Encoder 2/AN: J8.B2 (2), R138.1
/Encoder 2/AP: J8.B1 (1), R134.1, R135.1
/Encoder 2/BN: J8.B6 (6), R146.1
/Encoder 2/BP: J8.B3 (3), R142.1, R143.1
/Encoder 2/VENC: C68.1, J8.B7 (7), R134.2, R142.2, R150.2, U25.7 (OUT)
/Encoder 2/VSD: C66.1, C67.1, D42.1 (K), U25.8 (VS)
/Encoder 2/VSEL: D42.2 (A), JP3.2
/Encoder 2/ZN: J8.B5 (5), R154.1
/Encoder 2/ZP: J8.B4 (4), R150.1, R151.1
/Encoder 3/AN: J9.B2 (2), R164.1
/Encoder 3/AP: J9.B1 (1), R160.1, R161.1
/Encoder 3/BN: J9.B6 (6), R172.1
/Encoder 3/BP: J9.B3 (3), R168.1, R169.1
/Encoder 3/VENC: C72.1, J9.B7 (7), R160.2, R168.2, R176.2, U27.7 (OUT)
/Encoder 3/VSD: C70.1, C71.1, D49.1 (K), U27.8 (VS)
/Encoder 3/VSEL: D49.2 (A), JP4.2
/Encoder 3/ZN: J9.B5 (5), R180.1
/Encoder 3/ZP: J9.B4 (4), R176.1, R177.1
CHASSIS: J7.SH, J8.SH, J9.SH; also elsewhere on the board
ENC1_A: U24.3 (1Y); also elsewhere on the board
ENC1_B: U24.13 (4Y); also elsewhere on the board
ENC1_Z: U24.5 (2Y); also elsewhere on the board
ENC2_A: U26.3 (1Y); also elsewhere on the board
ENC2_B: U26.13 (4Y); also elsewhere on the board
ENC2_Z: U26.5 (2Y); also elsewhere on the board
ENC3_A: U28.3 (1Y); also elsewhere on the board
ENC3_B: U28.13 (4Y); also elsewhere on the board
ENC3_Z: U28.5 (2Y); also elsewhere on the board
GND: C62.2, C63.2, C64.2, C65.2, C66.2, C67.2, C68.2, C69.2, C70.2, C71.2, C72.2, C73.2, D36.1 (A), D37.1 (A), D38.1 (A), D39.1 (A), D40.1 (A), D41.1 (A), D43.1 (A), D44.1 (A), D45.1 (A), D46.1 (A), D47.1 (A), D48.1 (A), D50.1 (A), D51.1 (A), D52.1 (A), D53.1 (A), D54.1 (A), D55.1 (A), J7.A8 (8), J7.B8 (8), J8.A8 (8), J8.B8 (8), J9.A8 (8), J9.B8 (8), R107.2, R111.2, R114.2, R119.2, R122.2, R127.2, R130.2, R133.2, R137.2, R140.2, R145.2, R148.2, R153.2, R156.2, R159.2, R163.2, R166.2, R171.2, R174.2, R179.2, R182.2, U23.2 (DIAG_EN), U23.6 (GND), U23.9 (EP), U24.8 (GND), U24.12 (~G), U25.2 (DIAG_EN), U25.6 (GND), U25.9 (EP), U26.8 (GND), U26.12 (~G), U27.2 (DIAG_EN), U27.6 (GND), U27.9 (EP), U28.8 (GND), U28.12 (~G); also elsewhere on the board
unnamed: D36.3 (COM), R109.2, R110.1, R111.1, U24.2 (1A)
unnamed: D37.3 (COM), R112.2, R113.1, R114.1, U24.1 (1B)
unnamed: D38.3 (COM), R117.2, R118.1, R119.1, U24.14 (4A)
unnamed: D39.3 (COM), R120.2, R121.1, R122.1, U24.15 (4B)
unnamed: D40.3 (COM), R125.2, R126.1, R127.1, U24.6 (2A)
unnamed: D41.3 (COM), R128.2, R129.1, R130.1, U24.7 (2B)
unnamed: D43.3 (COM), R135.2, R136.1, R137.1, U26.2 (1A)
unnamed: D44.3 (COM), R138.2, R139.1, R140.1, U26.1 (1B)
unnamed: D45.3 (COM), R143.2, R144.1, R145.1, U26.14 (4A)
unnamed: D46.3 (COM), R146.2, R147.1, R148.1, U26.15 (4B)
unnamed: D47.3 (COM), R151.2, R152.1, R153.1, U26.6 (2A)
unnamed: D48.3 (COM), R154.2, R155.1, R156.1, U26.7 (2B)
unnamed: D50.3 (COM), R161.2, R162.1, R163.1, U28.2 (1A)
unnamed: D51.3 (COM), R164.2, R165.1, R166.1, U28.1 (1B)
unnamed: D52.3 (COM), R169.2, R170.1, R171.1, U28.14 (4A)
unnamed: D53.3 (COM), R172.2, R173.1, R174.1, U28.15 (4B)
unnamed: D54.3 (COM), R177.2, R178.1, R179.1, U28.6 (2A)
unnamed: D55.3 (COM), R180.2, R181.1, R182.1, U28.7 (2B)
unnamed: R107.1, U23.4 (CL)
unnamed: R106.1, U23.5 (DELAY)
unnamed: R133.1, U25.4 (CL)
unnamed: R132.1, U25.5 (DELAY)
unnamed: R159.1, U27.4 (CL)
unnamed: R158.1, U27.5 (DELAY)

Notes on the sheet:
ENCODER PORT
Placed four times (encoders 0 to 3). Per line: 3.3 k series, Schottky clamp to 0..5 V, bias 4.7 k / 4.7 k at the receiver: an open line sits at 2.5 V, so a single-ended encoder (TTL, HTL, open collector) works with its - line unconnected. + lines pulled up to the encoder supply. No termination on t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
Shunt 1-2: 5 V, 2-3: VIN (12 or 24 V), none: no supply. 218 mA limit.

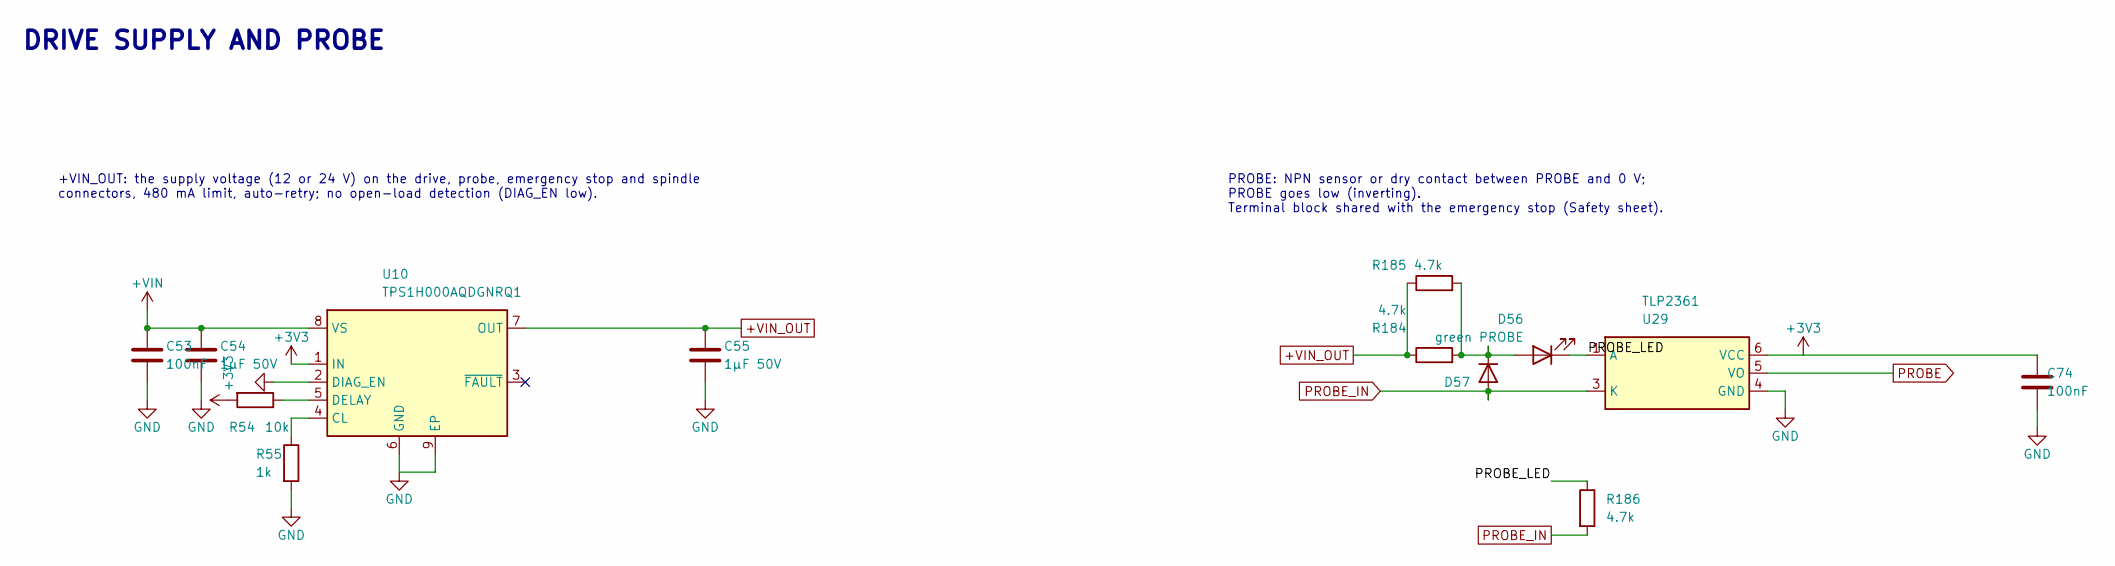
[picture p6: schematic drive_supply.kicad_sch, VIN OUT of the drive ports; probe input]

Parts:
C53, C74: 100nF; C_0402_1005Metric; LCSC C307331
C54, C55: 1µF 50V; C_0603_1608Metric; LCSC C15849
D56: green PROBE; LED_0603_1608Metric; LCSC C2289
D57: 1N4148WS; D_SOD-323; LCSC C2128
R54: 10k; R_0402_1005Metric; LCSC C25744
R55: 1k; R_0402_1005Metric; LCSC C11702
R184, R185: 4.7k; R_1206_3216Metric; LCSC C17936
R186: 4.7k; R_0402_1005Metric; LCSC C25900
U10: TPS1H000AQDGNRQ1; HVSSOP-8-1EP_3x3mm_P0.65mm_EP1.57x1.89mm; LCSC C2653764
U29: TLP2361; SO-5-6_4.55x3.7mm_P1.27mm; LCSC C107626

Connections:
+3V3: C74.1, R54.2, U10.1 (IN), U29.6 (VCC); also elsewhere on the board
+VIN: C53.1, C54.1, U10.8 (VS); also elsewhere on the board
+VIN_OUT: C55.1, R184.1, R185.1, U10.7 (OUT); also elsewhere on the board
/Drive supply and probe/PROBE_LED: D56.1 (K), R186.1, U29.1 (A)
GND: C53.2, C54.2, C55.2, C74.2, R55.2, U10.2 (DIAG_EN), U10.6 (GND), U10.9 (EP), U29.4 (GND); also elsewhere on the board
unnamed: D56.2 (A), D57.1 (K), R184.2, R185.2
unnamed: R55.1, U10.4 (CL)
unnamed: R54.1, U10.5 (DELAY)
PROBE: U29.5 (VO); also elsewhere on the board
PROBE_IN: D57.2 (A), R186.2, U29.3 (K); also elsewhere on the board

Notes on the sheet:
DRIVE SUPPLY AND PROBE
+VIN_OUT: the supply voltage (12 or 24 V) on the drive, probe, emergency stop and spindle connectors, 480 mA limit, auto-retry; no open-load detection (DIAG_EN low).
PROBE: NPN sensor or dry contact between PROBE and 0 V; PROBE goes low (inverting). Terminal block shared with the emergency stop (Safety sheet).

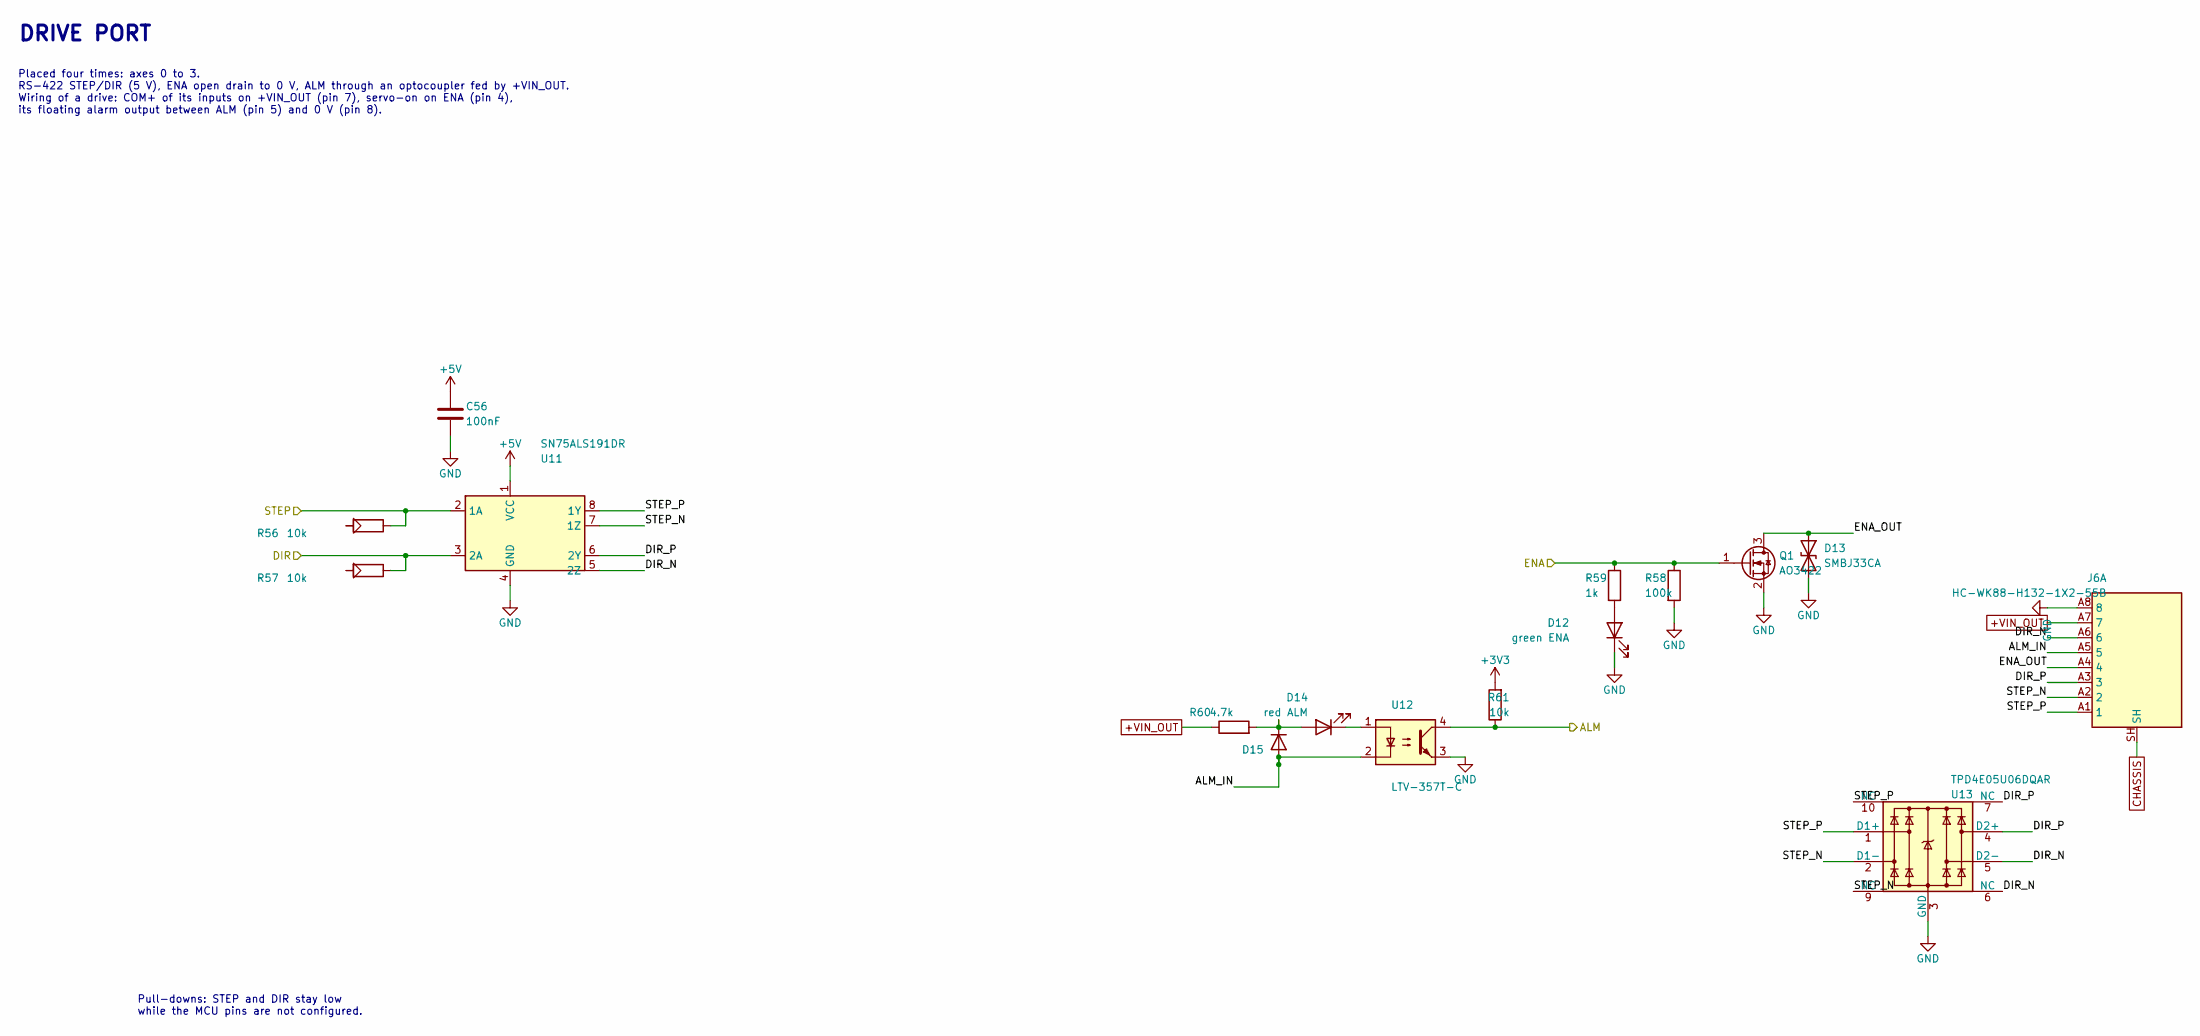
[picture p7: schematic drive.kicad_sch, Drive port: STEP/DIR, ENA, ALM (4 instances)]

Parts:
C56: 100nF; C_0402_1005Metric; LCSC C307331
D12: green ENA; LED_0603_1608Metric; LCSC C2289
D13: SMBJ33CA; D_SMB; LCSC C78420
D14: red ALM; LED_0603_1608Metric; LCSC C2286
D15: 1N4148WS; D_SOD-323; LCSC C2128
J6: HC-WK88-H132-1X2-55B; RJ45x2_HongCheng_HC-WK88-H132-1X2-55B; LCSC C7501828
Q1: AO3422; SOT-23; LCSC C37130
R56, R57, R61: 10k; R_0402_1005Metric; LCSC C25744
R58: 100k; R_0402_1005Metric; LCSC C25741
R59: 1k; R_0402_1005Metric; LCSC C11702
R60: 4.7k; R_1206_3216Metric; LCSC C17936
U11: SN75ALS191DR; SOIC-8_3.9x4.9mm_P1.27mm; LCSC C2871261
U12: LTV-357T-C; SO-4_4.4x3.6mm_P2.54mm; LCSC C119091
U13: TPD4E05U06DQAR; USON-10_2.5x1.0mm_P0.5mm; LCSC C138714

Connections:
+3V3: R61.2; also elsewhere on the board
+5V: C56.1, U11.1 (VCC); also elsewhere on the board
+VIN_OUT: J6.A7 (7), R60.1; also elsewhere on the board
/Drive 0/ALM_IN: D15.2 (A), J6.A5 (5), U12.2
/Drive 0/DIR_N: J6.A6 (6), U11.5 (2Z), U13.5 (D2-), U13.6 (NC)
/Drive 0/DIR_P: J6.A3 (3), U11.6 (2Y), U13.4 (D2+), U13.7 (NC)
/Drive 0/ENA_OUT: D13.1 (A1), J6.A4 (4), Q1.3 (D)
/Drive 0/STEP_N: J6.A2 (2), U11.7 (1Z), U13.2 (D1-), U13.9 (NC)
/Drive 0/STEP_P: J6.A1 (1), U11.8 (1Y), U13.1 (D1+), U13.10 (NC)
ALM0: R61.1, U12.4; also elsewhere on the board
CHASSIS: J6.SH; also elsewhere on the board
DIR0: R57.1, U11.3 (2A); also elsewhere on the board
ENA0: Q1.1 (G), R58.1, R59.1; also elsewhere on the board
GND: C56.2, D12.1 (K), D13.2 (A2), J6.A8 (8), Q1.2 (S), R56.2, R57.2, R58.2, U11.4 (GND), U12.3, U13.3 (GND), U13.8 (GND); also elsewhere on the board
unnamed: D12.2 (A), R59.2
unnamed: D14.2 (A), D15.1 (K), R60.2
unnamed: D14.1 (K), U12.1
STEP0: R56.1, U11.2 (1A); also elsewhere on the board

Parts of its further copies:
C57, C320, C321: 100nF; C_0402_1005Metric; LCSC C307331
D16, D20, D24: green ENA; LED_0603_1608Metric; LCSC C2289
D17, D21, D25: SMBJ33CA; D_SMB; LCSC C78420
D18, D22, D26: red ALM; LED_0603_1608Metric; LCSC C2286
D19, D23, D27: 1N4148WS; D_SOD-323; LCSC C2128
J7, J8, J9: HC-WK88-H132-1X2-55B; RJ45x2_HongCheng_HC-WK88-H132-1X2-55B; LCSC C7501828
Q2, Q3, Q4: AO3422; SOT-23; LCSC C37130
R62, R63, R67, R68, R69, R73, R74, R75, R79: 10k; R_0402_1005Metric; LCSC C25744
R64, R70, R76: 100k; R_0402_1005Metric; LCSC C25741
R65, R71, R77: 1k; R_0402_1005Metric; LCSC C11702
R66, R72, R78: 4.7k; R_1206_3216Metric; LCSC C17936
U14, U17, U19: LTV-357T-C; SO-4_4.4x3.6mm_P2.54mm; LCSC C119091
U15, U18, U20: TPD4E05U06DQAR; USON-10_2.5x1.0mm_P0.5mm; LCSC C138714
U16, U300, U301: SN75ALS191DR; SOIC-8_3.9x4.9mm_P1.27mm; LCSC C2871261

Connections of its further copies:
+3V3: R67.2, R73.2, R79.2; also elsewhere on the board
+5V: C57.1, C320.1, C321.1, U16.1 (VCC), U300.1 (VCC), U301.1 (VCC); also elsewhere on the board
+VIN_OUT: J7.A7 (7), J8.A7 (7), J9.A7 (7), R66.1, R72.1, R78.1; also elsewhere on the board
/Drive 1/ALM_IN: D19.2 (A), J7.A5 (5), U14.2
/Drive 1/DIR_N: J7.A6 (6), U15.5 (D2-), U15.6 (NC), U300.5 (2Z)
/Drive 1/DIR_P: J7.A3 (3), U15.4 (D2+), U15.7 (NC), U300.6 (2Y)
/Drive 1/ENA_OUT: D17.1 (A1), J7.A4 (4), Q2.3 (D)
/Drive 1/STEP_N: J7.A2 (2), U15.2 (D1-), U15.9 (NC), U300.7 (1Z)
/Drive 1/STEP_P: J7.A1 (1), U15.1 (D1+), U15.10 (NC), U300.8 (1Y)
/Drive 2/ALM_IN: D23.2 (A), J8.A5 (5), U17.2
/Drive 2/DIR_N: J8.A6 (6), U16.5 (2Z), U18.5 (D2-), U18.6 (NC)
/Drive 2/DIR_P: J8.A3 (3), U16.6 (2Y), U18.4 (D2+), U18.7 (NC)
/Drive 2/ENA_OUT: D21.1 (A1), J8.A4 (4), Q3.3 (D)
/Drive 2/STEP_N: J8.A2 (2), U16.7 (1Z), U18.2 (D1-), U18.9 (NC)
/Drive 2/STEP_P: J8.A1 (1), U16.8 (1Y), U18.1 (D1+), U18.10 (NC)
/Drive 3/ALM_IN: D27.2 (A), J9.A5 (5), U19.2
/Drive 3/DIR_N: J9.A6 (6), U20.5 (D2-), U20.6 (NC), U301.5 (2Z)
/Drive 3/DIR_P: J9.A3 (3), U20.4 (D2+), U20.7 (NC), U301.6 (2Y)
/Drive 3/ENA_OUT: D25.1 (A1), J9.A4 (4), Q4.3 (D)
/Drive 3/STEP_N: J9.A2 (2), U20.2 (D1-), U20.9 (NC), U301.7 (1Z)
/Drive 3/STEP_P: J9.A1 (1), U20.1 (D1+), U20.10 (NC), U301.8 (1Y)
/Encoder 1/AN: J7.B2 (2); also elsewhere on the board
/Encoder 1/AP: J7.B1 (1); also elsewhere on the board
/Encoder 1/BN: J7.B6 (6); also elsewhere on the board
/Encoder 1/BP: J7.B3 (3); also elsewhere on the board
/Encoder 1/VENC: J7.B7 (7); also elsewhere on the board
/Encoder 1/ZN: J7.B5 (5); also elsewhere on the board
/Encoder 1/ZP: J7.B4 (4); also elsewhere on the board
/Encoder 2/AN: J8.B2 (2); also elsewhere on the board
/Encoder 2/AP: J8.B1 (1); also elsewhere on the board
/Encoder 2/BN: J8.B6 (6); also elsewhere on the board
/Encoder 2/BP: J8.B3 (3); also elsewhere on the board
/Encoder 2/VENC: J8.B7 (7); also elsewhere on the board
/Encoder 2/ZN: J8.B5 (5); also elsewhere on the board
/Encoder 2/ZP: J8.B4 (4); also elsewhere on the board
/Encoder 3/AN: J9.B2 (2); also elsewhere on the board
/Encoder 3/AP: J9.B1 (1); also elsewhere on the board
/Encoder 3/BN: J9.B6 (6); also elsewhere on the board
/Encoder 3/BP: J9.B3 (3); also elsewhere on the board
/Encoder 3/VENC: J9.B7 (7); also elsewhere on the board
/Encoder 3/ZN: J9.B5 (5); also elsewhere on the board
/Encoder 3/ZP: J9.B4 (4); also elsewhere on the board
ALM1: R67.1, U14.4; also elsewhere on the board
ALM2: R73.1, U17.4; also elsewhere on the board
ALM3: R79.1, U19.4; also elsewhere on the board
CHASSIS: J7.SH, J8.SH, J9.SH; also elsewhere on the board
DIR1: R63.1, U300.3 (2A); also elsewhere on the board
DIR2: R69.1, U16.3 (2A); also elsewhere on the board
DIR3: R75.1, U301.3 (2A); also elsewhere on the board
ENA1: Q2.1 (G), R64.1, R65.1; also elsewhere on the board
ENA2: Q3.1 (G), R70.1, R71.1; also elsewhere on the board
ENA3: Q4.1 (G), R76.1, R77.1; also elsewhere on the board
GND: C57.2, C320.2, C321.2, D16.1 (K), D17.2 (A2), D20.1 (K), D21.2 (A2), D24.1 (K), D25.2 (A2), J7.A8 (8), J7.B8 (8), J8.A8 (8), J8.B8 (8), J9.A8 (8), J9.B8 (8), Q2.2 (S), Q3.2 (S), Q4.2 (S), R62.2, R63.2, R64.2, R68.2, R69.2, R70.2, R74.2, R75.2, R76.2, U14.3, U15.3 (GND), U15.8 (GND), U16.4 (GND), U17.3, U18.3 (GND), U18.8 (GND), U19.3, U20.3 (GND), U20.8 (GND), U300.4 (GND), U301.4 (GND); also elsewhere on the board
unnamed: D16.2 (A), R65.2
unnamed: D18.2 (A), D19.1 (K), R66.2
unnamed: D18.1 (K), U14.1
unnamed: D20.2 (A), R71.2
unnamed: D22.2 (A), D23.1 (K), R72.2
unnamed: D22.1 (K), U17.1
unnamed: D24.2 (A), R77.2
unnamed: D26.2 (A), D27.1 (K), R78.2
unnamed: D26.1 (K), U19.1
STEP1: R62.1, U300.2 (1A); also elsewhere on the board
STEP2: R68.1, U16.2 (1A); also elsewhere on the board
STEP3: R74.1, U301.2 (1A); also elsewhere on the board

Notes on the sheet:
DRIVE PORT
Placed four times: axes 0 to 3. RS-422 STEP/DIR (5 V), ENA open drain to 0 V, ALM through an optocoupler fed by +VIN_OUT. Wiring of a drive: COM+ of its inputs on +VIN_OUT (pin 7), servo-on on ENA (pin 4), its floating alarm output between ALM (pin 5) and 0 V (pin 8).
Pull-downs: STEP and DIR stay low while the MCU pins are not configured.
