bornier-dev/bornier/hardware/base/kicad/base.kicad_pcb

## KiCad design hardware/base/kicad/base.kicad_pcb (continued)

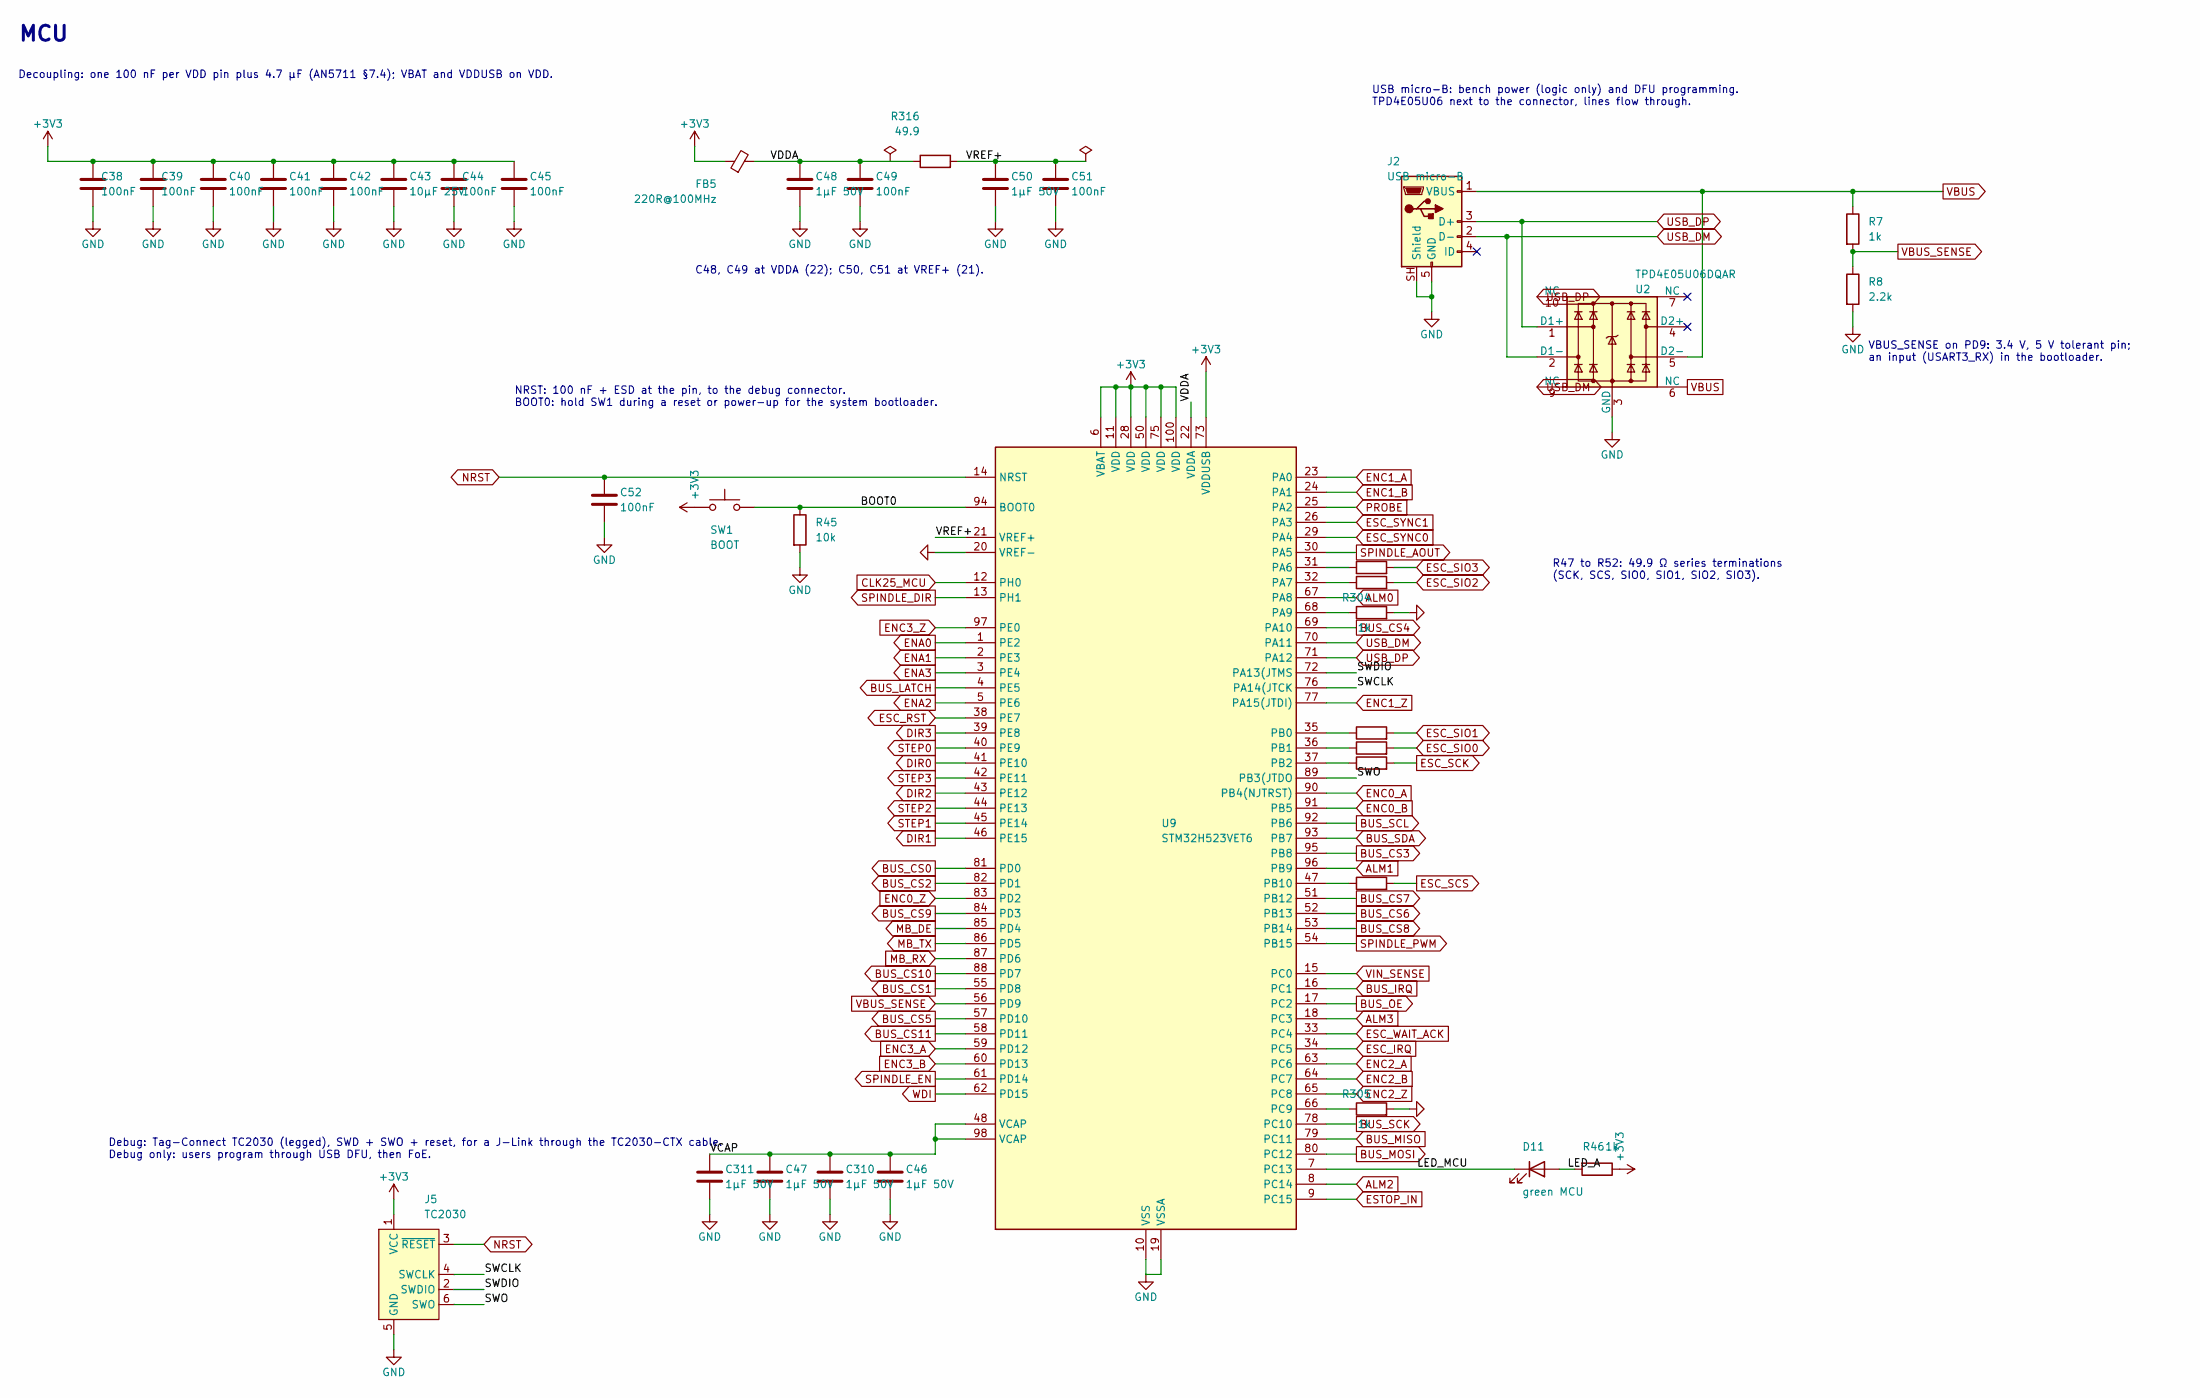
[picture p8: schematic mcu.kicad_sch, MCU STM32H523VET6, decoupling, debug, USB]

Parts:
C38, C39, C40, C41, C42, C44, C45, C49, C51, C52: 100nF; C_0402_1005Metric; LCSC C307331
C43: 10µF 25V; C_0805_2012Metric; LCSC C15850
C46, C47, C48, C50, C310, C311: 1µF 50V; C_0603_1608Metric; LCSC C15849
D11: green MCU; LED_0603_1608Metric; LCSC C2289
FB5: 220R@100MHz; L_0603_1608Metric; LCSC C80165
J2: USB micro-B; USB_Micro-B_Molex-105133-0001; LCSC C782257
J5: TC2030; Tag-Connect_TC2030-IDC-FP_2x03_P1.27mm_Vertical
R7, R46, R304, R305: 1k; R_0402_1005Metric; LCSC C11702
R8: 2.2k; R_0402_1005Metric; LCSC C25879
R45: 10k; R_0402_1005Metric; LCSC C25744
R47, R48, R49, R50, R51, R52, R316: 49.9; R_0603_1608Metric; LCSC C23185
SW1: BOOT; SW_XKB_TS-1187A; LCSC C318884
U2: TPD4E05U06DQAR; USON-10_2.5x1.0mm_P0.5mm; LCSC C138714
U9: STM32H523VET6; LQFP-100_14x14mm_P0.5mm; LCSC C27338462

Connections:
+3V3: C38.1, C39.1, C40.1, C41.1, C42.1, C43.1, C44.1, C45.1, FB5.1, J5.1 (VCC), R46.1, SW1.1, U9.6 (VBAT), U9.11 (VDD), U9.28 (VDD), U9.50 (VDD), U9.73 (VDDUSB), U9.75 (VDD), U9.100 (VDD); also elsewhere on the board
/MCU/BOOT0: R45.1, SW1.2, U9.94 (BOOT0)
/MCU/LED_A: D11.2 (A), R46.2
/MCU/LED_MCU: D11.1 (K), U9.7 (PC13)
/MCU/SWCLK: J5.4 (SWCLK), U9.76 (PA14(JTCK)
/MCU/SWDIO: J5.2 (SWDIO), U9.72 (PA13(JTMS)
/MCU/SWO: J5.6 (SWO), U9.89 (PB3(JTDO)
/MCU/VCAP: C46.1, C47.1, C310.1, C311.1, U9.48 (VCAP), U9.98 (VCAP)
/MCU/VDDA: C48.1, C49.1, FB5.2, R316.1, U9.22 (VDDA)
/MCU/VREF+: C50.1, C51.1, R316.2, U9.21 (VREF+)
ALM0: U9.67 (PA8); also elsewhere on the board
ALM1: U9.96 (PB9); also elsewhere on the board
ALM2: U9.8 (PC14); also elsewhere on the board
ALM3: U9.18 (PC3); also elsewhere on the board
BUS_CS0: U9.81 (PD0); also elsewhere on the board
BUS_CS1: U9.55 (PD8); also elsewhere on the board
BUS_CS2: U9.82 (PD1); also elsewhere on the board
BUS_CS3: U9.95 (PB8); also elsewhere on the board
BUS_CS4: U9.69 (PA10); also elsewhere on the board
BUS_CS5: U9.57 (PD10); also elsewhere on the board
BUS_CS6: U9.52 (PB13); also elsewhere on the board
BUS_CS7: U9.51 (PB12); also elsewhere on the board
BUS_CS8: U9.53 (PB14); also elsewhere on the board
BUS_CS9: U9.84 (PD3); also elsewhere on the board
BUS_CS10: U9.88 (PD7); also elsewhere on the board
BUS_CS11: U9.58 (PD11); also elsewhere on the board
BUS_IRQ: U9.16 (PC1); also elsewhere on the board
BUS_LATCH: U9.4 (PE5); also elsewhere on the board
BUS_MISO: U9.79 (PC11); also elsewhere on the board
BUS_MOSI: U9.80 (PC12); also elsewhere on the board
BUS_OE: U9.17 (PC2); also elsewhere on the board
BUS_SCK: U9.78 (PC10); also elsewhere on the board
BUS_SCL: U9.92 (PB6); also elsewhere on the board
BUS_SDA: U9.93 (PB7); also elsewhere on the board
CLK25_MCU: U9.12 (PH0); also elsewhere on the board
DIR0: U9.41 (PE10); also elsewhere on the board
DIR1: U9.46 (PE15); also elsewhere on the board
DIR2: U9.43 (PE12); also elsewhere on the board
DIR3: U9.39 (PE8); also elsewhere on the board
ENA0: U9.1 (PE2); also elsewhere on the board
ENA1: U9.2 (PE3); also elsewhere on the board
ENA2: U9.5 (PE6); also elsewhere on the board
ENA3: U9.3 (PE4); also elsewhere on the board
ENC0_A: U9.90 (PB4(NJTRST)); also elsewhere on the board
ENC0_B: U9.91 (PB5); also elsewhere on the board
ENC0_Z: U9.83 (PD2); also elsewhere on the board
ENC1_A: U9.23 (PA0); also elsewhere on the board
ENC1_B: U9.24 (PA1); also elsewhere on the board
ENC1_Z: U9.77 (PA15(JTDI)); also elsewhere on the board
ENC2_A: U9.63 (PC6); also elsewhere on the board
ENC2_B: U9.64 (PC7); also elsewhere on the board
ENC2_Z: U9.65 (PC8); also elsewhere on the board
ENC3_A: U9.59 (PD12); also elsewhere on the board
ENC3_B: U9.60 (PD13); also elsewhere on the board
ENC3_Z: U9.97 (PE0); also elsewhere on the board
ESC_IRQ: U9.34 (PC5); also elsewhere on the board
ESC_RST: U9.38 (PE7); also elsewhere on the board
ESC_SCK: R47.2; also elsewhere on the board
ESC_SCS: R48.2; also elsewhere on the board
ESC_SIO0: R49.2; also elsewhere on the board
ESC_SIO1: R50.2; also elsewhere on the board
ESC_SIO2: R51.2; also elsewhere on the board
ESC_SIO3: R52.2; also elsewhere on the board
ESC_SYNC0: U9.29 (PA4); also elsewhere on the board
ESC_SYNC1: U9.26 (PA3); also elsewhere on the board
ESC_WAIT_ACK: U9.33 (PC4); also elsewhere on the board
ESTOP_IN: U9.9 (PC15); also elsewhere on the board
GND: C38.2, C39.2, C40.2, C41.2, C42.2, C43.2, C44.2, C45.2, C46.2, C47.2, C48.2, C49.2, C50.2, C51.2, C52.2, C310.2, C311.2, J2.5 (GND), J2.SH (Shield), J5.5 (GND), R8.2, R45.2, R304.2, R305.2, U2.3 (GND), U2.8 (GND), U9.10 (VSS), U9.19 (VSSA), U9.20 (VREF-), U9.27 (VSS), U9.49 (VSS), U9.74 (VSS), U9.99 (VSS); also elsewhere on the board
MB_DE: U9.85 (PD4); also elsewhere on the board
MB_RX: U9.87 (PD6); also elsewhere on the board
MB_TX: U9.86 (PD5); also elsewhere on the board
NRST: C52.1, J5.3 (~RESET), U9.14 (NRST); also elsewhere on the board
unnamed: R52.1, U9.31 (PA6)
unnamed: R51.1, U9.32 (PA7)
unnamed: R304.1, U9.68 (PA9)
unnamed: R50.1, U9.35 (PB0)
unnamed: R49.1, U9.36 (PB1)
unnamed: R47.1, U9.37 (PB2)
unnamed: R48.1, U9.47 (PB10)
unnamed: R305.1, U9.66 (PC9)
PROBE: U9.25 (PA2); also elsewhere on the board
SPINDLE_AOUT: U9.30 (PA5); also elsewhere on the board
SPINDLE_DIR: U9.13 (PH1); also elsewhere on the board
SPINDLE_EN: U9.61 (PD14); also elsewhere on the board
SPINDLE_PWM: U9.54 (PB15); also elsewhere on the board
STEP0: U9.40 (PE9); also elsewhere on the board
STEP1: U9.45 (PE14); also elsewhere on the board
STEP2: U9.44 (PE13); also elsewhere on the board
STEP3: U9.42 (PE11); also elsewhere on the board
USB_DM: J2.2 (D-), U2.2 (D1-), U2.9 (NC), U9.70 (PA11)
USB_DP: J2.3 (D+), U2.1 (D1+), U2.10 (NC), U9.71 (PA12)
VBUS: J2.1 (VBUS), R7.1, U2.5 (D2-), U2.6 (NC); also elsewhere on the board
VBUS_SENSE: R7.2, R8.1, U9.56 (PD9)
VIN_SENSE: U9.15 (PC0); also elsewhere on the board
WDI: U9.62 (PD15); also elsewhere on the board

Notes on the sheet:
MCU
Decoupling: one 100 nF per VDD pin plus 4.7 µF (AN5711 §7.4); VBAT and VDDUSB on VDD.
C48, C49 at VDDA (22); C50, C51 at VREF+ (21).
NRST: 100 nF + ESD at the pin, to the debug connector. BOOT0: hold SW1 during a reset or power-up for the system bootloader.
R47 to R52: 49.9 Ω series terminations (SCK, SCS, SIO0, SIO1, SIO2, SIO3).
Debug: Tag-Connect TC2030 (legged), SWD + SWO + reset, for a J-Link through the TC2030-CTX cable. Debug only: users program through USB DFU, then FoE.
USB micro-B: bench power (logic only) and DFU programming. TPD4E05U06 next to the connector, lines flow through.
VBUS_SENSE on PD9: 3.4 V, 5 V tolerant pin; an input (USART3_RX) in the bootloader.

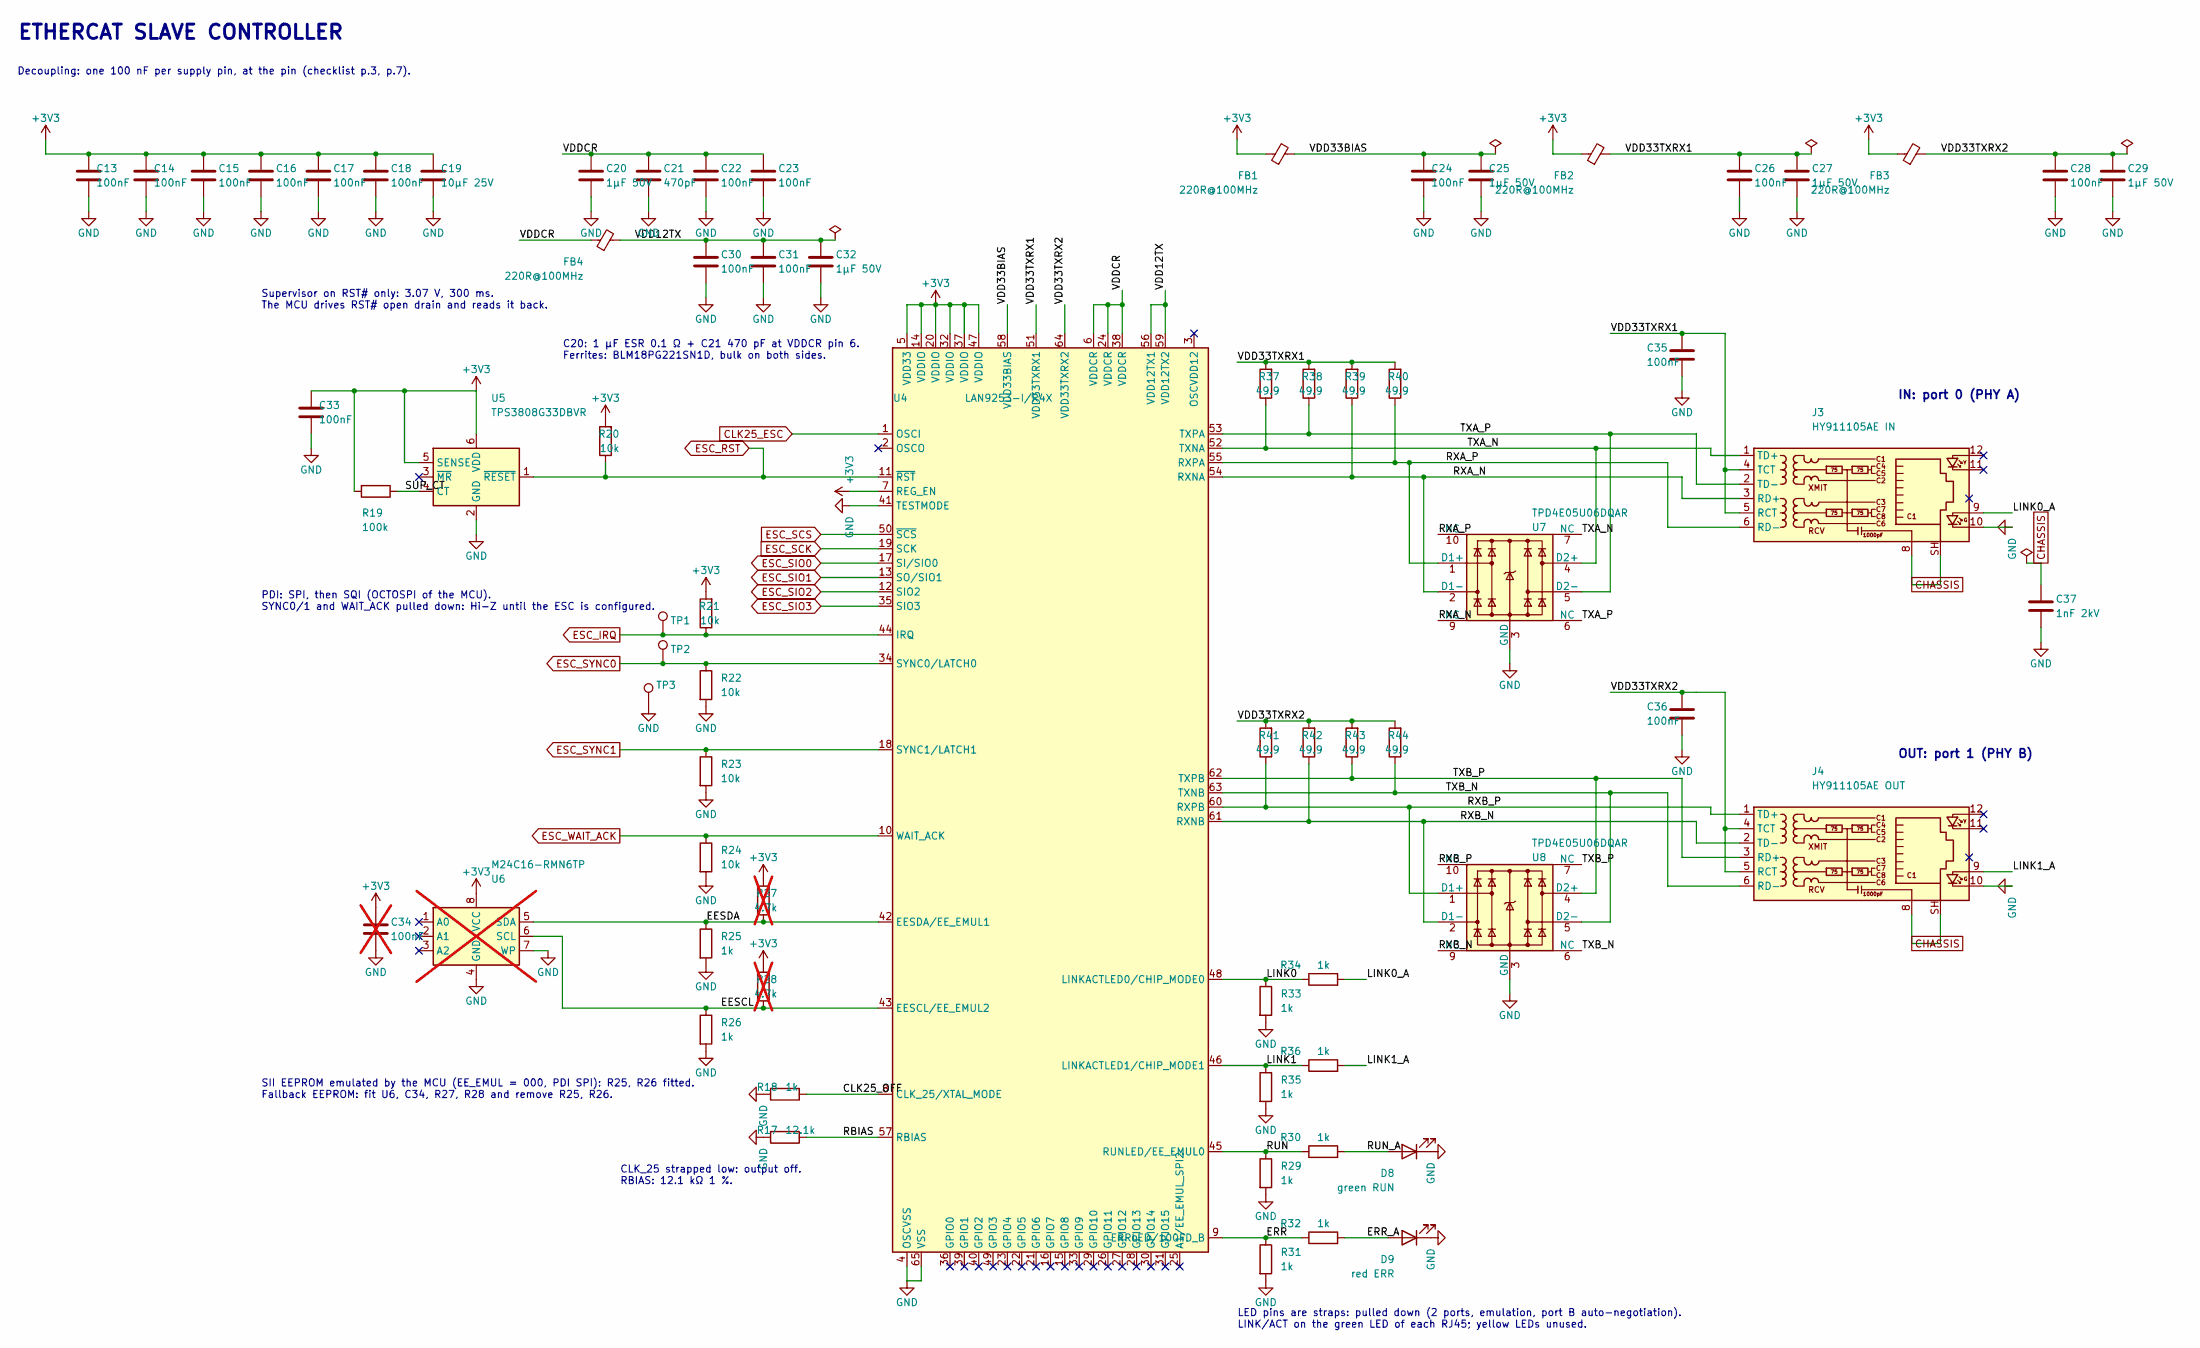
[picture p9: schematic esc.kicad_sch, EtherCAT slave controller LAN9253, ports, LEDs]

Parts:
C13, C14, C15, C16, C17, C18, C22, C23, C24, C26, C28, C30, C31, C33, C35, C36: 100nF; C_0402_1005Metric; LCSC C307331
C19: 10µF 25V; C_0805_2012Metric; LCSC C15850
C20, C25, C27, C29, C32: 1µF 50V; C_0603_1608Metric; LCSC C15849
C21: 470pF; C_0402_1005Metric; LCSC C1537
C34: 100nF; C_0402_1005Metric; LCSC C307331; not fitted
C37: 1nF 2kV; C_1206_3216Metric; LCSC C9196
D8: green RUN; LED_0603_1608Metric; LCSC C2289
D9: red ERR; LED_0603_1608Metric; LCSC C2286
FB1, FB2, FB3, FB4: 220R@100MHz; L_0603_1608Metric; LCSC C80165
J3: HY911105AE IN; RJ45_Hanrun_HR911105A_Horizontal; LCSC C69427
J4: HY911105AE OUT; RJ45_Hanrun_HR911105A_Horizontal; LCSC C69427
R17: 12.1k; R_0402_1005Metric; LCSC C25852
R18, R25, R26, R29, R30, R31, R32, R33, R34, R35, R36: 1k; R_0402_1005Metric; LCSC C11702
R19: 100k; R_0402_1005Metric; LCSC C25741
R20, R21, R22, R23, R24: 10k; R_0402_1005Metric; LCSC C25744
R27, R28: 4.7k; R_0402_1005Metric; LCSC C25900; not fitted
R37, R38, R39, R40, R41, R42, R43, R44: 49.9; R_0603_1608Metric; LCSC C23185
TP1: ESC_IRQ; TestPoint_Pad_D1.5mm
TP2: SYNC0; TestPoint_Pad_D1.5mm
TP3: GND; TestPoint_Pad_D1.5mm
U4: LAN9253-I/R4X; QFN-64-1EP_9x9mm_P0.5mm_EP6x6mm_ThermalVias; LCSC C5745149
U5: TPS3808G33DBVR; SOT-23-6; LCSC C43698
U6: M24C16-RMN6TP; SOIC-8_3.9x4.9mm_P1.27mm; LCSC C79946; not fitted
U7, U8: TPD4E05U06DQAR; USON-10_2.5x1.0mm_P0.5mm; LCSC C138714

Connections:
+3V3: C13.1, C14.1, C15.1, C16.1, C17.1, C18.1, C19.1, C33.1, C34.1, FB1.1, FB2.1, FB3.1, R19.2, R20.2, R21.2, R27.2, R28.2, U4.5 (VDD33), U4.7 (REG_EN), U4.14 (VDDIO), U4.20 (VDDIO), U4.32 (VDDIO), U4.37 (VDDIO), U4.47 (VDDIO), U5.5 (SENSE), U5.6 (VDD), U6.8 (VCC); also elsewhere on the board
/ESC/CLK25_OFF: R18.1, U4.8 (CLK_25/XTAL_MODE)
/ESC/EESCL: R26.1, R28.1, U4.43 (EESCL/EE_EMUL2), U6.6 (SCL)
/ESC/EESDA: R25.1, R27.1, U4.42 (EESDA/EE_EMUL1), U6.5 (SDA)
/ESC/ERR: R31.1, R32.1, U4.9 (ERRLED/100FD_B)
/ESC/ERR_A: D9.2 (A), R32.2
/ESC/LINK0: R33.1, R34.1, U4.48 (LINKACTLED0/CHIP_MODE0)
/ESC/LINK0_A: J3.9, R34.2
/ESC/LINK1: R35.1, R36.1, U4.46 (LINKACTLED1/CHIP_MODE1)
/ESC/LINK1_A: J4.9, R36.2
/ESC/RBIAS: R17.1, U4.57 (RBIAS)
/ESC/RUN: R29.1, R30.1, U4.45 (RUNLED/EE_EMUL0)
/ESC/RUN_A: D8.2 (A), R30.2
/ESC/RXA_N: J3.3 (RD+), R39.1, U4.54 (RXNA), U7.2 (D1-), U7.9 (NC)
/ESC/RXA_P: J3.6 (RD-), R40.1, U4.55 (RXPA), U7.1 (D1+), U7.10 (NC)
/ESC/RXB_N: J4.2 (TD-), R42.1, U4.61 (RXNB), U8.2 (D1-), U8.9 (NC)
/ESC/RXB_P: J4.1 (TD+), R41.1, U4.60 (RXPB), U8.1 (D1+), U8.10 (NC)
/ESC/SUP_CT: R19.1, U5.4 (CT)
/ESC/TXA_N: J3.1 (TD+), R37.1, U4.52 (TXNA), U7.4 (D2+), U7.7 (NC)
/ESC/TXA_P: J3.2 (TD-), R38.1, U4.53 (TXPA), U7.5 (D2-), U7.6 (NC)
/ESC/TXB_N: J4.6 (RD-), R44.1, U4.63 (TXNB), U8.5 (D2-), U8.6 (NC)
/ESC/TXB_P: J4.3 (RD+), R43.1, U4.62 (TXPB), U8.4 (D2+), U8.7 (NC)
/ESC/VDD12TX: C30.1, C31.1, C32.1, FB4.2, U4.56 (VDD12TX1), U4.59 (VDD12TX2)
/ESC/VDD33BIAS: C24.1, C25.1, FB1.2, U4.58 (VDD33BIAS)
/ESC/VDD33TXRX1: C26.1, C27.1, C35.1, FB2.2, J3.4 (TCT), J3.5 (RCT), R37.2, R38.2, R39.2, R40.2, U4.51 (VDD33TXRX1)
/ESC/VDD33TXRX2: C28.1, C29.1, C36.1, FB3.2, J4.4 (TCT), J4.5 (RCT), R41.2, R42.2, R43.2, R44.2, U4.64 (VDD33TXRX2)
/ESC/VDDCR: C20.1, C21.1, C22.1, C23.1, FB4.1, U4.6 (VDDCR), U4.24 (VDDCR), U4.38 (VDDCR)
CHASSIS: C37.1, J3.8, J3.SH, J4.8, J4.SH; also elsewhere on the board
CLK25_ESC: U4.1 (OSCI); also elsewhere on the board
ESC_IRQ: R21.1, TP1.1, U4.44 (IRQ); also elsewhere on the board
ESC_RST: R20.1, U4.11 (~RST), U5.1 (~RESET); also elsewhere on the board
ESC_SCK: U4.19 (SCK); also elsewhere on the board
ESC_SCS: U4.50 (~SCS); also elsewhere on the board
ESC_SIO0: U4.17 (SI/SIO0); also elsewhere on the board
ESC_SIO1: U4.13 (SO/SIO1); also elsewhere on the board
ESC_SIO2: U4.12 (SIO2); also elsewhere on the board
ESC_SIO3: U4.35 (SIO3); also elsewhere on the board
ESC_SYNC0: R22.1, TP2.1, U4.34 (SYNC0/LATCH0); also elsewhere on the board
ESC_SYNC1: R23.1, U4.18 (SYNC1/LATCH1); also elsewhere on the board
ESC_WAIT_ACK: R24.1, U4.10 (WAIT_ACK); also elsewhere on the board
GND: C13.2, C14.2, C15.2, C16.2, C17.2, C18.2, C19.2, C20.2, C21.2, C22.2, C23.2, C24.2, C25.2, C26.2, C27.2, C28.2, C29.2, C30.2, C31.2, C32.2, C33.2, C34.2, C35.2, C36.2, C37.2, D8.1 (K), D9.1 (K), J3.10, J4.10, R17.2, R18.2, R22.2, R23.2, R24.2, R25.2, R26.2, R29.2, R31.2, R33.2, R35.2, TP3.1, U4.4 (OSCVSS), U4.41 (TESTMODE), U4.65 (VSS), U5.2 (GND), U6.4 (GND), U6.7 (WP), U7.3 (GND), U7.8 (GND), U8.3 (GND), U8.8 (GND); also elsewhere on the board

Notes on the sheet:
ETHERCAT SLAVE CONTROLLER
Decoupling: one 100 nF per supply pin, at the pin (checklist p.3, p.7).
C20: 1 µF ESR 0.1 Ω + C21 470 pF at VDDCR pin 6. Ferrites: BLM18PG221SN1D, bulk on both sides.
Supervisor on RST# only: 3.07 V, 300 ms. The MCU drives RST# open drain and reads it back.
PDI: SPI, then SQI (OCTOSPI of the MCU). SYNC0/1 and WAIT_ACK pulled down: Hi-Z until the ESC is configured.
SII EEPROM emulated by the MCU (EE_EMUL = 000, PDI SPI): R25, R26 fitted. Fallback EEPROM: fit U6, C34, R27, R28 and remove R25, R26.
CLK_25 strapped low: output off. RBIAS: 12.1 kΩ 1 %.
IN: port 0 (PHY A)
OUT: port 1 (PHY B)
LED pins are straps: pulled down (2 ports, emulation, port B auto-negotiation). LINK/ACT on the green LED of each RJ45; yellow LEDs unused.

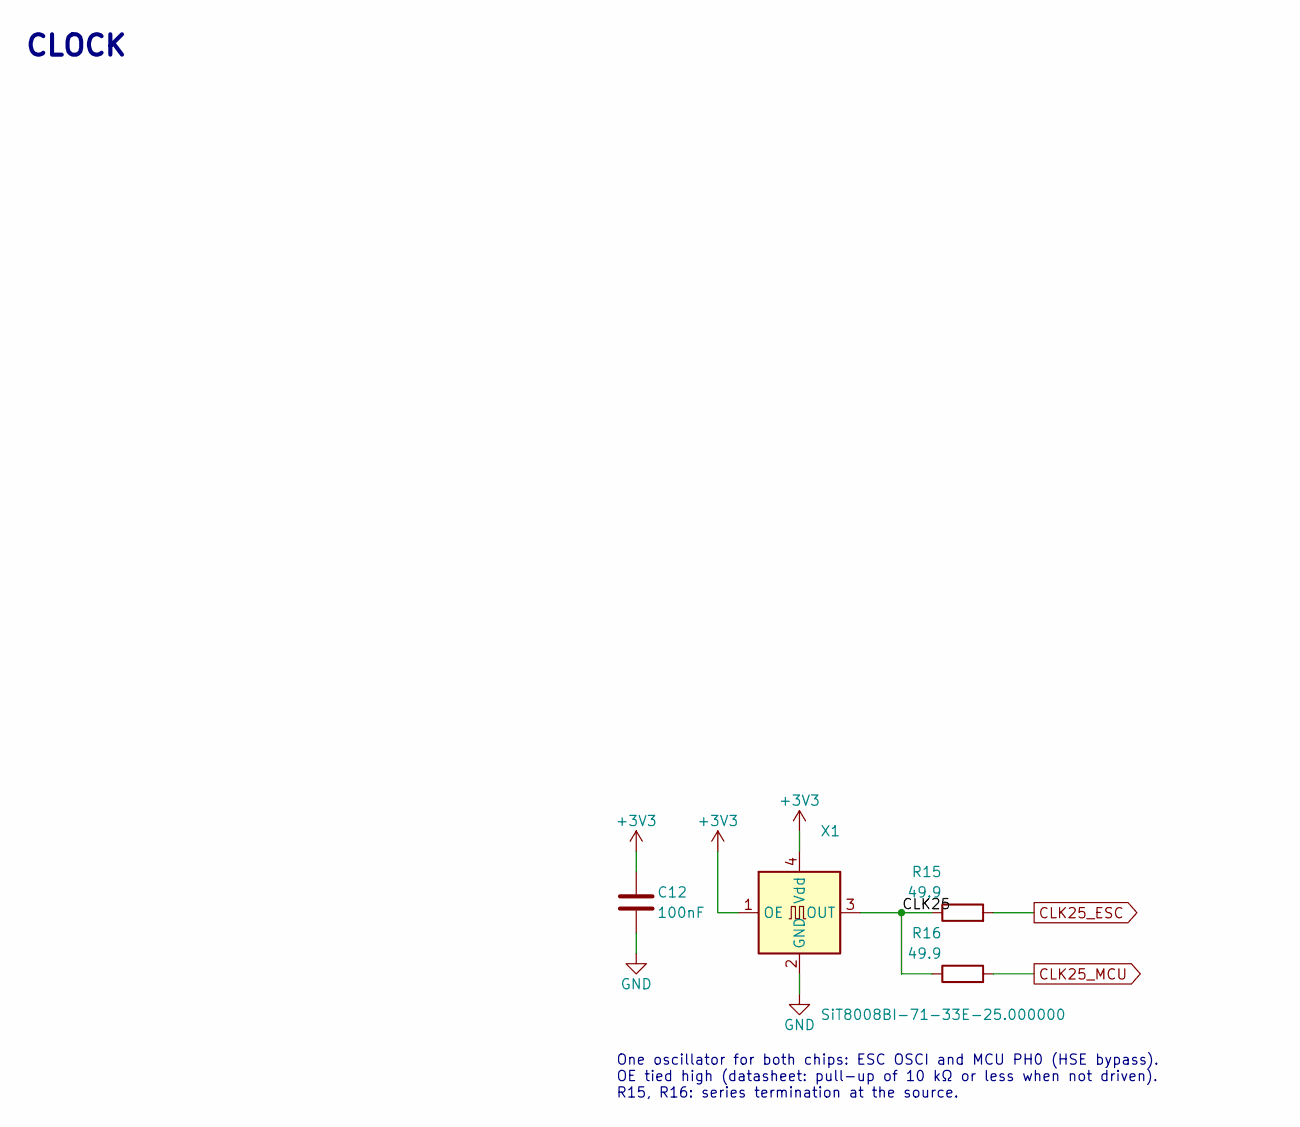
[picture p10: schematic clock.kicad_sch, 25 MHz clock shared by the ESC and the MCU]

Parts:
C12: 100nF; C_0402_1005Metric; LCSC C307331
R15, R16: 49.9; R_0603_1608Metric; LCSC C23185
X1: SiT8008BI-71-33E-25.000000; Oscillator_SMD_SiT_PQFN-4Pin_2.0x1.6mm; LCSC C806295

Connections:
+3V3: C12.1, X1.1 (OE), X1.4 (Vdd); also elsewhere on the board
/Clock/CLK25: R15.1, R16.1, X1.3 (OUT)
CLK25_ESC: R15.2; also elsewhere on the board
CLK25_MCU: R16.2; also elsewhere on the board
GND: C12.2, X1.2 (GND); also elsewhere on the board

Notes on the sheet:
CLOCK
One oscillator for both chips: ESC OSCI and MCU PH0 (HSE bypass). OE tied high (datasheet: pull-up of 10 kΩ or less when not driven). R15, R16: series termination at the source.

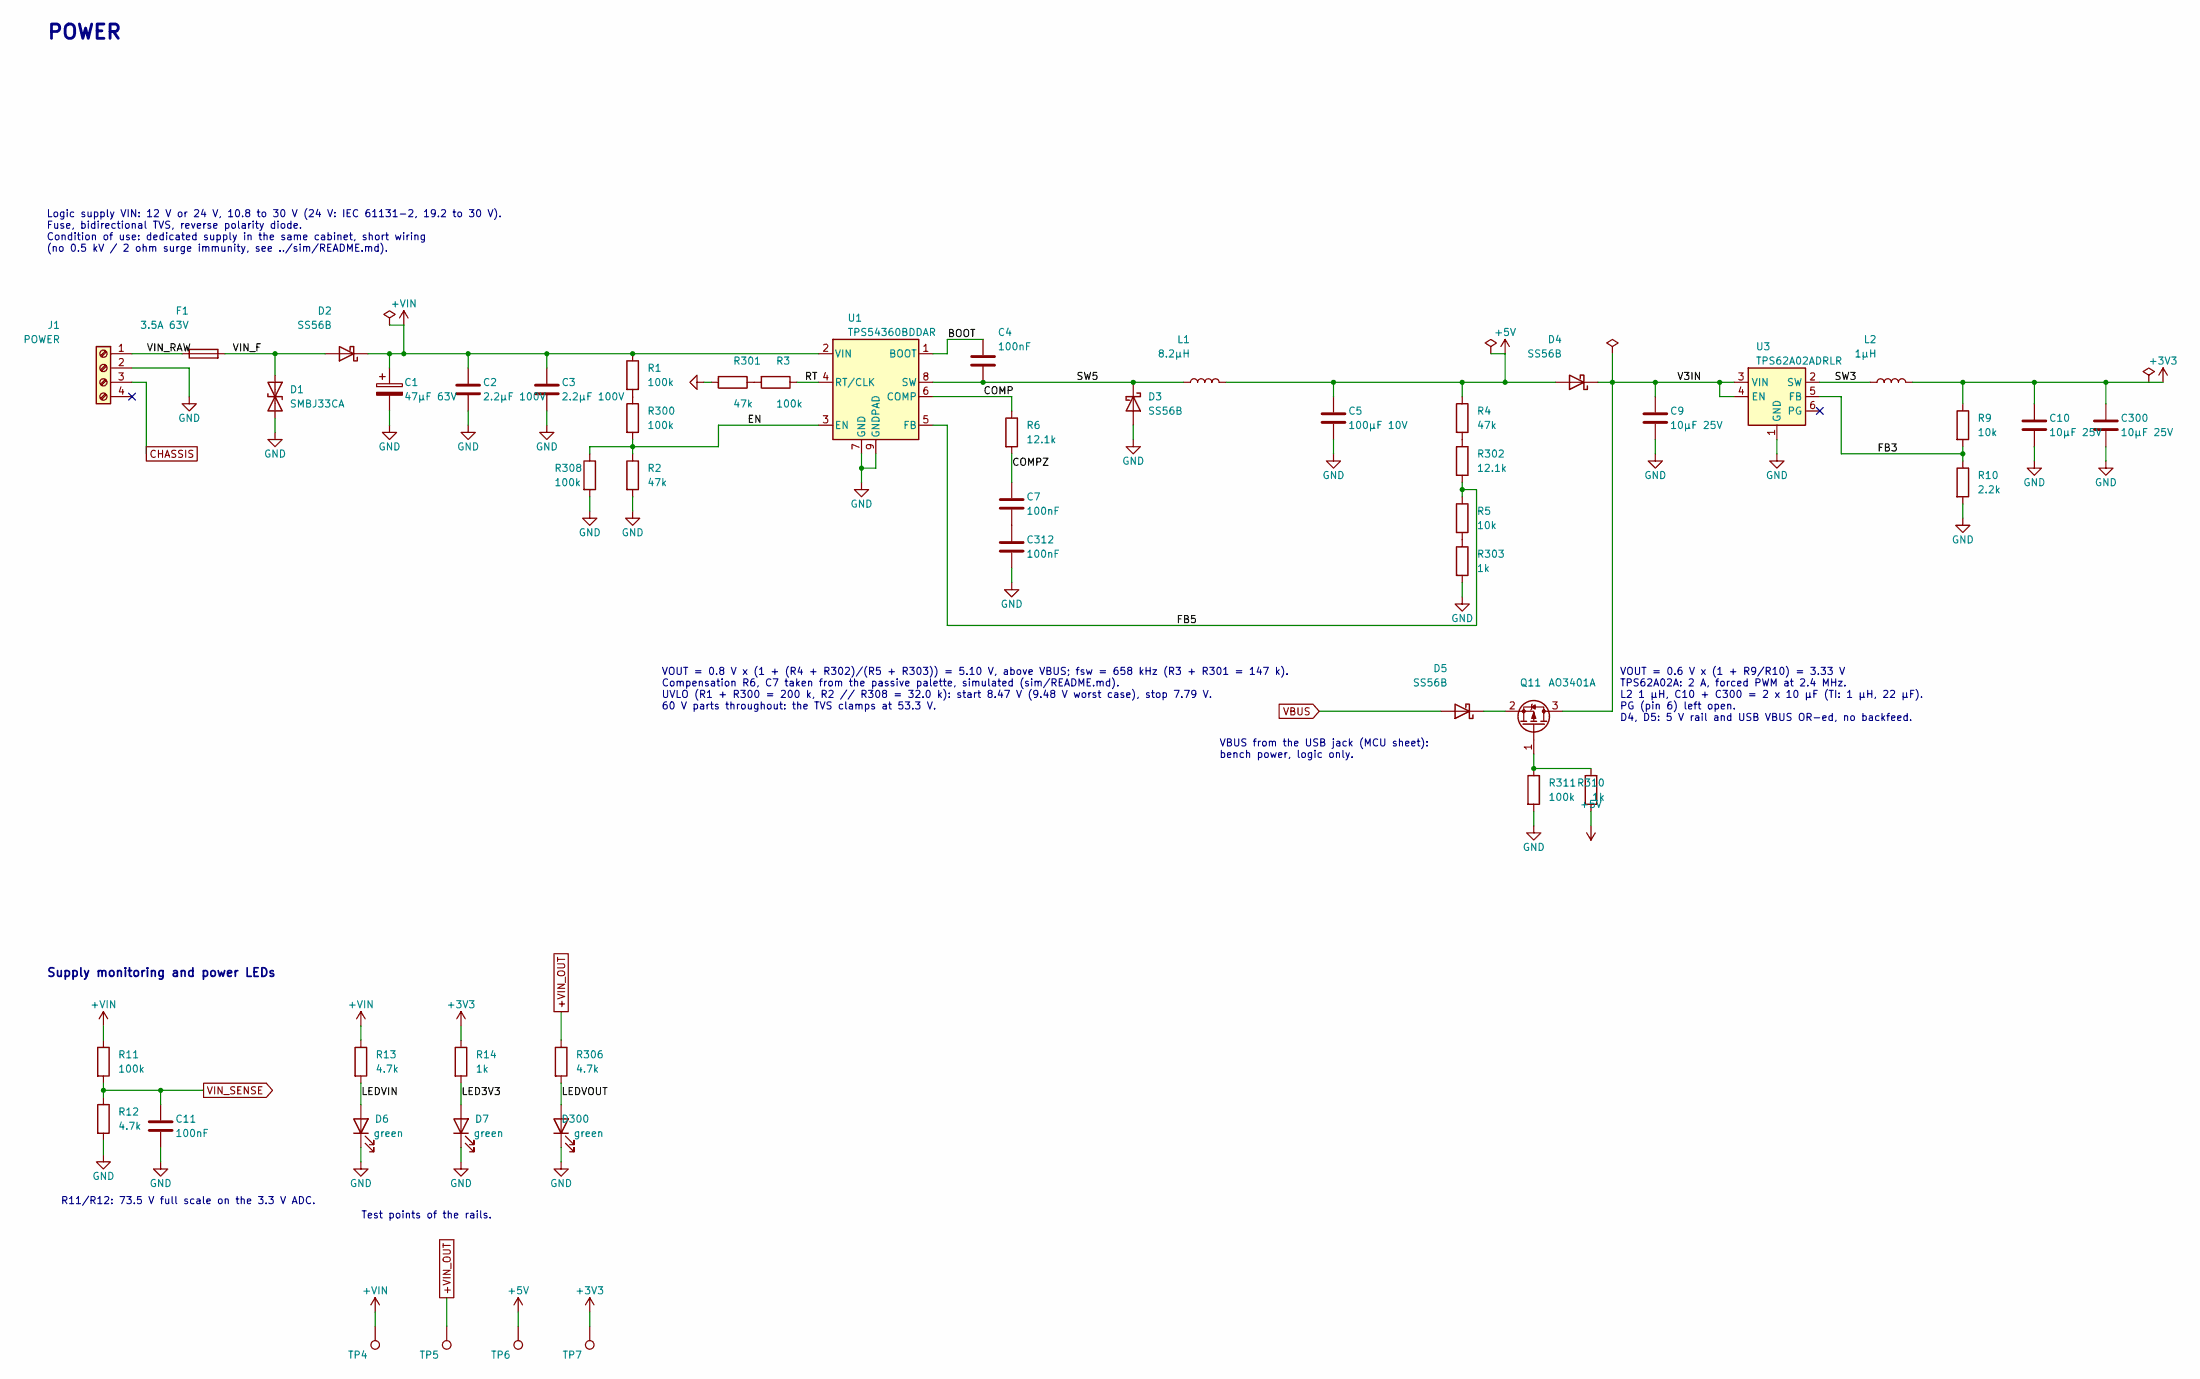
[picture p11: schematic power.kicad_sch, 12 or 24 V input, 5 V and 3.3 V bucks, USB VBUS]

Parts:
C1: 47µF 63V; CP_Elec_6.3x7.7; LCSC C46550423
C2, C3: 2.2µF 100V; C_1210_3225Metric; LCSC C153036
C4, C7, C11, C312: 100nF; C_0402_1005Metric; LCSC C307331
C5: 100µF 10V; C_1210_3225Metric; LCSC C84455
C9, C10, C300: 10µF 25V; C_0805_2012Metric; LCSC C15850
D1: SMBJ33CA; D_SMB; LCSC C78420
D2, D3, D4, D5: SS56B; D_SMB; LCSC C14651
D6, D7, D300: green; LED_0603_1608Metric; LCSC C2289
F1: 3.5A 63V; Fuse_1206_3216Metric; LCSC C182975
J1: POWER; PhoenixContact_MC_1,5_4-G-3.81_1x04_P3.81mm_Horizontal; LCSC C441184
L1: 8.2µH; L_Sunlord_MWSA1004S; LCSC C408486
L2: 1µH; L_1008_2520Metric; LCSC C435392
Q11: AO3401A; SOT-23; LCSC C15127
R1, R3, R11, R300, R308, R311: 100k; R_0402_1005Metric; LCSC C25741
R2, R4, R301: 47k; R_0402_1005Metric; LCSC C25792
R5, R9: 10k; R_0402_1005Metric; LCSC C25744
R6, R302: 12.1k; R_0402_1005Metric; LCSC C25852
R10: 2.2k; R_0402_1005Metric; LCSC C25879
R12: 4.7k; R_0402_1005Metric; LCSC C25900
R13, R306: 4.7k; R_1206_3216Metric; LCSC C17936
R14, R303, R310: 1k; R_0402_1005Metric; LCSC C11702
TP4: +VIN; TestPoint_Pad_D1.5mm
TP5: +VIN_OUT; TestPoint_Pad_D1.5mm
TP6: +5V; TestPoint_Pad_D1.5mm
TP7: +3V3; TestPoint_Pad_D1.5mm
U1: TPS54360BDDAR; TI_SO-PowerPAD-8_ThermalVias; LCSC C524806
U3: TPS62A02ADRLR; SOT-563; LCSC C5820994

Connections:
+3V3: C10.1, C300.1, L2.2, R9.1, R14.1, TP7.1; also elsewhere on the board
+5V: C5.1, D4.2 (A), L1.2, R4.1, R310.1, TP6.1; also elsewhere on the board
+VIN: C1.1, C2.1, C3.1, D2.1 (K), R1.1, R11.1, R13.1, TP4.1, U1.2 (VIN); also elsewhere on the board
+VIN_OUT: R306.1, TP5.1; also elsewhere on the board
/Power/BOOT: C4.1, U1.1 (BOOT)
/Power/COMP: R6.1, U1.6 (COMP)
/Power/COMPZ: C7.1, R6.2
/Power/EN: R2.1, R300.2, R308.1, U1.3 (EN)
/Power/FB3: R9.2, R10.1, U3.5 (FB)
/Power/FB5: R5.1, R302.2, U1.5 (FB)
/Power/LED3V3: D7.2 (A), R14.2
/Power/LEDVIN: D6.2 (A), R13.2
/Power/LEDVOUT: D300.2 (A), R306.2
/Power/RT: R3.1, U1.4 (RT/CLK)
/Power/SW3: L2.1, U3.2 (SW)
/Power/SW5: C4.2, D3.1 (K), L1.1, U1.8 (SW)
/Power/V3IN: C9.1, D4.1 (K), Q11.3 (D), U3.3 (VIN), U3.4 (EN)
/Power/VIN_F: D1.1 (A1), D2.2 (A), F1.2
/Power/VIN_RAW: F1.1, J1.1
CHASSIS: J1.3; also elsewhere on the board
GND: C1.2, C2.2, C3.2, C5.2, C9.2, C10.2, C11.2, C300.2, C312.2, D1.2 (A2), D3.2 (A), D6.1 (K), D7.1 (K), D300.1 (K), J1.2, R2.2, R10.2, R12.2, R301.2, R303.2, R308.2, R311.2, U1.7 (GND), U1.9 (GNDPAD), U3.1 (GND); also elsewhere on the board
unnamed: C7.2, C312.1
unnamed: D5.1 (K), Q11.2 (S)
unnamed: Q11.1 (G), R310.2, R311.1
unnamed: R1.2, R300.1
unnamed: R3.2, R301.1
unnamed: R4.2, R302.1
unnamed: R5.2, R303.1
VBUS: D5.2 (A); also elsewhere on the board
VIN_SENSE: C11.1, R11.2, R12.1; also elsewhere on the board

Notes on the sheet:
POWER
Logic supply VIN: 12 V or 24 V, 10.8 to 30 V (24 V: IEC 61131-2, 19.2 to 30 V). Fuse, bidirectional TVS, reverse polarity diode. Condition of use: dedicated supply in the same cabinet, short wiring (no 0.5 kV / 2 ohm surge immunity, see ../sim/README.md).
VOUT = 0.8 V x (1 + (R4 + R302)/(R5 + R303)) = 5.10 V, above VBUS; fsw = 658 kHz (R3 + R301 = 147 k). Compensation R6, C7 taken from the passive palette, simulated (sim/README.md). UVLO (R1 + R300 = 200 k, R2 // R308 = 32.0 k): start 8.47 V (9.48 V worst case), stop 7.79 V. 60 V parts throughout: t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
VBUS from the USB jack (MCU sheet): bench power, logic only.
VOUT = 0.6 V x (1 + R9/R10) = 3.33 V TPS62A02A: 2 A, forced PWM at 2.4 MHz. L2 1 µH, C10 + C300 = 2 x 10 µF (TI: 1 µH, 22 µF). PG (pin 6) left open. D4, D5: 5 V rail and USB VBUS OR-ed, no backfeed.
Supply monitoring and power LEDs
R11/R12: 73.5 V full scale on the 3.3 V ADC.
Test points of the rails.

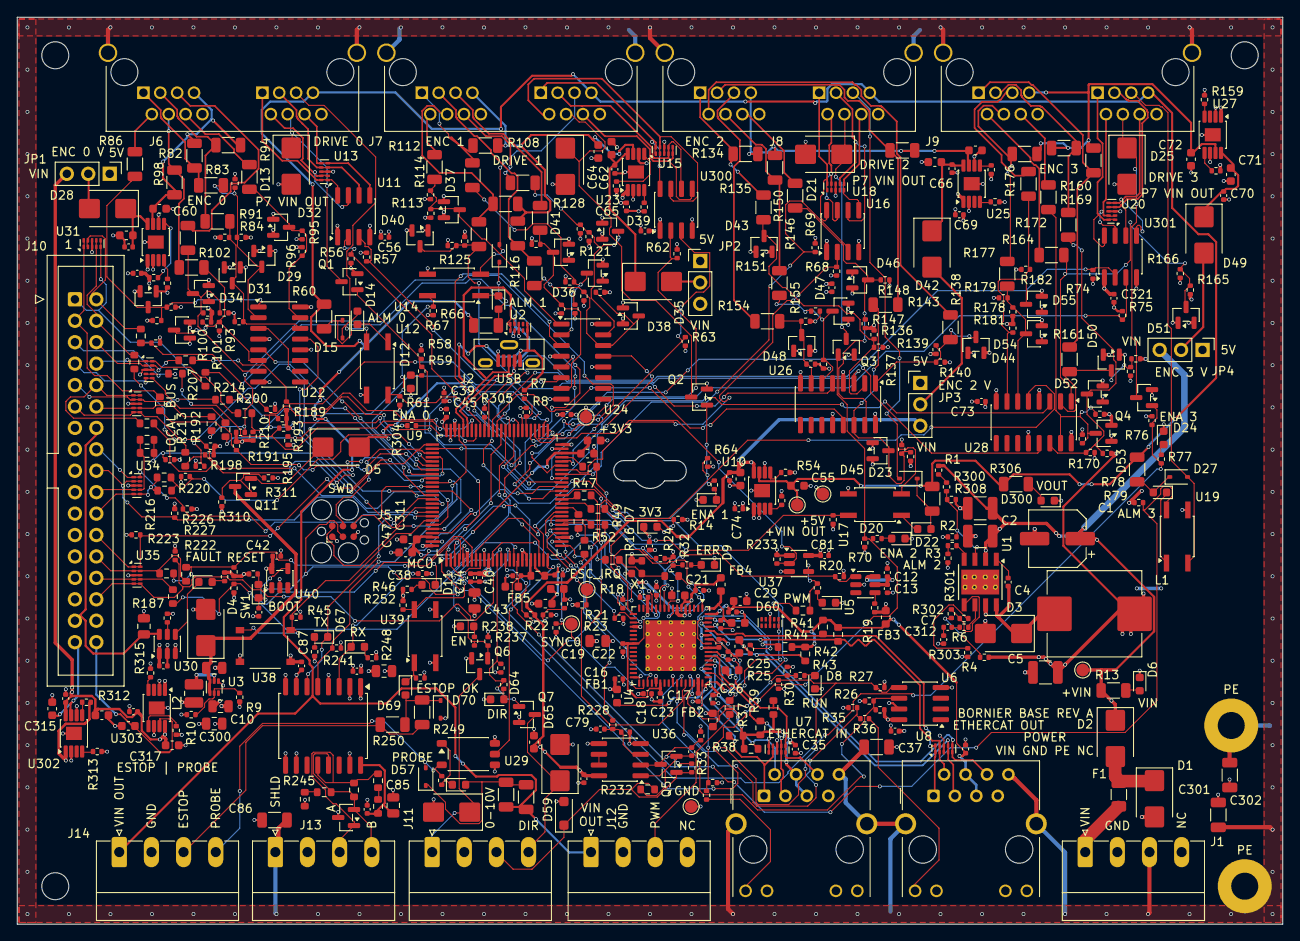
[picture p12: board base.kicad_pcb from above]

Board: 4 copper layers, 150.0 x 107.5 mm, 517 parts (0 on the bottom side), 309 nets.
