bornier-dev/bornier/firmware/boards/base/clock.hpp

// SPDX-License-Identifier: MPL-2.0
// SPDX-FileCopyrightText: 2026 Thomas Legrand

/**
 ******************************************************************************
 * @file    clock.hpp
 * @author  Thomas Legrand
 * @brief   Bornier base board system clock: 250 MHz from the 25 MHz oscillator via PLL1,
 *          instruction cache on
 *
 *          No HAL. All register accesses go through the typed wrappers in
 *          @c rcc.hpp, @c pwr.hpp and @c flash.hpp.
 *
 * @par PLL1 configuration (HSE → 250 MHz)
 *   | Parameter | Value | Note                                  |
 *   |-----------|-------|---------------------------------------|
 *   | Source    | HSE   | 25 MHz oscillator X1, on PH0          |
 *   | PLL1M     | 5     | PLL input = 5 MHz (RGE 10: 4–8 MHz)  |
 *   | PLL1N     | 100   | VCO = 500 MHz (wide VCO, VCOSEL = 0) |
 *   | PLL1P     | 1(÷2) | PLL1P = 250 MHz → SYSCLK              |
 *
 * @par Bus clock tree
 *   | Bus   | Prescaler | Frequency |
 *   |-------|-----------|-----------|
 *   | AHB   | /1        | 250 MHz   |
 *   | APB1  | /1        | 250 MHz   |
 *   | APB2  | /1        | 250 MHz   |
 *   | APB3  | /1        | 250 MHz   |
 ******************************************************************************
 */

#pragma once

#include <cstdint>

#include <STM32H523/flash.hpp>
#include <STM32H523/icache.hpp>
#include <STM32H523/pwr.hpp>
#include <STM32H523/rcc.hpp>

namespace STM32H523
{

/**
 * @brief System clock initialisation for the Bornier base board.
 *
 *        Brings the core to 250 MHz from the 25 MHz oscillator X1, which
 *        also clocks the EtherCAT slave controller. The oscillator drives
 *        PH0 with a square wave: HSE runs in digital bypass, and PH1 stays
 *        a GPIO.
 *        All steps are performed in the order mandated by the reference
 *        manual: voltage scaling first, then flash latency, then PLL,
 *        then bus dividers, then clock switch.
 */
class clock
{
public:

	/**
	 * @brief Configures and switches the system clock to 250 MHz.
	 *
	 *        Call once, early in @c main(), before any driver that depends
	 *        on the final clock frequency (timers, baud rates, …).
	 *        Safe to call from the main stack — does not interact with the
	 *        RTOS scheduler.
	 */
	static void init()
	{
		// ── 1. Voltage scaling ────────────────────────────────────────────
		// VOS0 (Scale 0, encoding 0b11) is required for SYSCLK > 200 MHz.
		// The reset value is 0b00 (Scale 3): set it explicitly and wait for
		// VOSRDY before the frequency goes up.
		pwr.voscr = pwr_p::voscr_r::vos_f(3);
		while (!pwr.vossr.load().vosrdy()) {}

		// ── 2. Flash access latency and prefetch ──────────────────────────
		// At 250 MHz with VOS0: 5 wait states, WRHIGHFREQ = 2.
		// Must be programmed *before* the clock frequency is increased.
		// PRFTEN: smart prefetch, recommended as soon as there is a wait state;
		// read back so that it is taken into account before going on.
		flash.acr = flash_p::acr_r::latency_f(5)
		                | flash_p::acr_r::wrhighfreq_f(2)
		                | flash_p::acr_r::prften_f();
		(void)flash.acr.load();

		// ── 3. HSE in digital bypass ──────────────────────────────────────
		// HSEBYP and HSEEXT are written while HSE is off: with HSEON alone,
		// the crystal amplifier would take PH1.
		rcc.cr = rcc.cr.load() | rcc_p::cr_r::hsebyp_f() | rcc_p::cr_r::hseext_f();
		rcc.cr = rcc.cr.load() | rcc_p::cr_r::hseon_f();
		while (!rcc.cr.load().hserdy()) {}

		// ── 4. PLL1 configuration ─────────────────────────────────────────
		// HSE (25 MHz) / PLL1M(5) = 5 MHz → × PLL1N(100) = 500 MHz VCO
		//   → / PLL1P(1→÷2) = 250 MHz PLL1P_CK (SYSCLK source)
		//
		// PLL1SRC = 11: HSE
		// PLL1RGE = 10: 4–8 MHz input range
		// VCOSEL  =  0: wide VCO (128–560 MHz) — default, not written
		// P output enabled; Q and R outputs left disabled
		rcc.pll1cfgr = rcc_p::pll1cfgr_r::pll1src_f(0b11)
		                 | rcc_p::pll1cfgr_r::pll1rge_f(0b10)
		                 | rcc_p::pll1cfgr_r::pll1m_f(5)
		                 | rcc_p::pll1cfgr_r::pll1pen_f()
		                 | rcc_p::pll1cfgr_r::pll1fracen_f();

		rcc.pll1divr = rcc_p::pll1divr_r::pll1n_f(99)   // N-1 encoding: register 99 → actual ×100
		                 | rcc_p::pll1divr_r::pll1p_f(1);   // P-1 encoding: register 1  → actual ÷2

		// ── 5. Enable PLL1 and wait for lock ─────────────────────────────
		rcc.cr = rcc.cr.load() | rcc_p::cr_r::pll1on_f();
		while (!rcc.cr.load().pll1rdy()) {}

		// ── 6. Bus prescalers ─────────────────────────────────────────────
		// HPRE  = 0 → AHB  = SYSCLK / 1 = 250 MHz
		// PPREx = 0 → APBx = HCLK  / 1 = 250 MHz
		rcc.cfgr2 = rcc_p::cfgr2_r::hpre_f(0)
		              | rcc_p::cfgr2_r::ppre1_f(0)
		              | rcc_p::cfgr2_r::ppre2_f(0)
		              | rcc_p::cfgr2_r::ppre3_f(0);

		// ── 7. Switch SYSCLK to PLL1P and wait for confirmation ──────────
		// SW = 011: PLL1 P-output as system clock source
		rcc.cfgr1 = rcc_p::cfgr1_r::sw_f(0b011);
		while (static_cast<uint8_t>(rcc.cfgr1.load().sws()) != 0b011u) {}

		// ── 8. Instruction cache ─────────────────────────────────────────
		// Code runs from flash with 5 wait states: without the cache, every
		// fetch outside the prefetch buffer stalls. The invalidation started
		// at reset must be over (BUSYF = 0) before the cache is enabled,
		// otherwise accesses stay non-cacheable until it ends.
		while (icache.sr.load().busyf()) {}
		icache.cr = icache.cr.load() | icache_p::cr_r::en_f();
	}
};

} // namespace STM32H523
