bornier-dev/bornier/(commit log)

2026-10-17 Firmware scaffold: CMake build, STM32H563 support, NUCLEO-H563ZI board, on-target tests
2026-10-19 Add the base board schematic and its generators
    Base board of the EtherCAT slave (STM32H523 + LAN9253), generated by script:
    - hardware/lib/kicadgen: schematic generator, hierarchical sheets reused
    per instance, closed passive palette, ERC and netlist check;
    - hardware/lib/symbols, hardware/lib/footprints: parts missing from the
    KiCad libraries, drawn from their datasheets;
    - hardware/base/gen: reference circuit (circuit.py) and the 16 sheets;
    - hardware/base/kicad: generated KiCad project (ERC clean, netlist matches);
    - hardware/base/sim: behavioural ngspice simulation of the 24 V to 5 V buck.
    [base.kicad_sch, bus.kicad_sch, clock.kicad_sch, drive_pair.kicad_sch, drive_supply.kicad_sch, encoder.kicad_sch, esc.kicad_sch, mcu.kicad_sch]
2026-10-19 Harden the base board protections and unify its terminal blocks
    - TVS (SMBJ33CA) on the spindle EN and DIR drains: a relay coil driven
    without a flyback diode no longer avalanches the FET.
    - ESD (5 x TPD4E05U06) on every signal of the local bus header.
    - A single terminal block type, KF2EDGR-3.81-4P, five times. Pinout rule:
    pole 1 withstands 24 V, pole 2 is 0 V, so the power plug damages
    nothing whichever header it lands in.
    - Functional earth on pole 3 of the power terminal block, replacing the
    M3 earth lug.
    - 100 k pull-down on the DAC node: the 0-10 V output stays at 0 V while
    the DAC pin is not configured (reset, bootloader).
    - "24V OUT" LED on +24V_DRV and test points on the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
    [bus.kicad_sch, clock.kicad_sch, drive_pair.kicad_sch, drive_supply.kicad_sch, encoder.kicad_sch, esc.kicad_sch, mcu.kicad_sch, modbus.kicad_sch]
2026-10-19 Update the README to the current state: single base board, layout, status
2026-10-19 Accept a 12 V or 24 V supply on the base board (10.8 to 30 V)
    - Supply nets renamed +VIN and +VIN_OUT (silkscreen VIN OUT).
    - UVLO 200 k over 47 k // 100 k: start 8.47 V (9.48 V worst case),
    stop 7.79 V; fuse 3.5 A (12H1350C).
    - 0-10 V: OPA2990 rail-to-rail op amp supplied by +VIN, SS8550 current
    limit across the 120 ohm; 10 V into 10 k from 10.9 V of supply.
    - E-stop and probe inputs: 2 x 4.7 k in parallel, shunts 1 k and 4.7 k.
    - Buck simulated from 7.8 to 30 V with the smallest slope compensation
    the datasheet allows: 79 deg, 11.6 dB minimum.
    [bus.kicad_sch, clock.kicad_sch, drive_pair.kicad_sch, drive_supply.kicad_sch, encoder.kicad_sch, esc.kicad_sch, mcu.kicad_sch, modbus.kicad_sch]
2026-10-19 Trim the base board BOM: 60 to 58 lines
    - ESD of NRST and of the PWM output on one channel of the TPD4E05U06
    already used on the PHY lines, instead of a PESD5V0S1BA.
    - SS56B instead of SS34 for the 5 V / USB OR-ing and the encoder
    supplies.
    - One 100 uF 10 V X5R 1210 on the 5 V buck output instead of two 47 uF:
    about 55 uF at 5 V, inside the simulated 34-80 uF.
    [encoder.kicad_sch, mcu.kicad_sch, power.kicad_sch, spindle.kicad_sch]
2026-10-19 Add four M3 mounting holes, one plated on CHASSIS
    Screw mounting on standoffs for users who do not want the DIN rail profile. H1 is plated and earths CHASSIS through its screw to the panel; the holes stay clear of the profile grooves along the long edges.
    [bus.kicad_sch, clock.kicad_sch, drive_pair.kicad_sch, drive_supply.kicad_sch, encoder.kicad_sch, esc.kicad_sch, mcu.kicad_sch, modbus.kicad_sch]
2026-10-19 Start the base board PCB: outline, profile rules, connectors on the edges
    - pcb.py builds the board from the schematic: 72 x 150 mm, 4 layers,
    C-LOCK keyhole, M3 holes, connectors on both long edges; the other
    parts are parked beside the board until they are placed.
    - base.kicad_dru: rules of the Phoenix UM-BASIC 72 profile (no part at
    the short edges on the top side, no through-hole lead on the rim the
    board rests on), proved by the DRC.
    - Dual shielded RJ45 per axis (HC-WK88-H132-1X2-55B): port A for the
    drive, port B for the encoder. kicadgen draws multi-unit symbols, one
    unit per sheet; footprint and 3D model generated from the datasheet.
    [base.kicad_pcb, bus.kicad_sch, clock.kicad_sch, drive_pair.kicad_sch, drive_supply.kicad_sch, encoder.kicad_sch, esc.kicad_sch, mcu.kicad_sch]
2026-10-19 Widen the base board to 107.5 x 150 mm, vertical USB, PE contact hole
    - The parts covered 94 % of the free top area on 72 mm, 53 % on 107.5 mm:
    Phoenix UM-BASIC 108 profile (kit UM-BASIC-KIT-B108-L150-7035), one side.
    - M3 holes at the four corners; H1 plated next to POWER.
    - H5: plated hole for the Phoenix PE contact L1, which earths CHASSIS to
    the DIN rail; no lead over the contact body under the board.
    - USB jack: vertical Molex 105133-0001, to sit next to the MCU.
    [base.kicad_pcb, power.kicad_sch, safety.kicad_sch]
2026-10-19 3D models for every part of the base board; edge connectors flush
    - gen_3d.py: simplified STEP models from the datasheets of the
    HY911105AE magjack, the Molex 105133-0001 vertical micro-B, the
    HX PZ2.54 SMD header and the TS-1187A switch.
    - pcb.py: KiCad library footprints whose model is missing point to the
    same package under another name, or to a generated model.
    - Edge connectors placed from their real front face, set back just enough
    for the pads of their front leads to clear the rim on the profile walls.
    [base.kicad_pcb]
2026-10-19 Regenerate the KiCad project file (ERC settings)
2026-10-19 Place the base board parts; DIP switches for the encoder terminations
    Placement (gen/pcb.py): one zone per schematic sheet, key parts placed by
    hand, the other parts next to the pin they serve, bulkiest first, with a
    1 mm gap preferred when it costs at most 2 mm. The local bus header stands
    at the left end, centred across the board, facing the modules.
    Encoder terminations: one CTS 218-4LPSTR DIP switch per encoder (100 mA
    non-switching) replaces three SMD jumpers; the supply selector and the
    Modbus termination use a through-hole 1x3 header. Split DIP symbol, one
    unit per switch, drawn on the pair it serves.
    DRC rules: 0.2 mm thermal vias, per-package clearance for 0.65 mm pitch
    parts. Tes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
    [base.kicad_pcb, bus.kicad_sch, clock.kicad_sch, drive_pair.kicad_sch, drive_supply.kicad_sch, encoder.kicad_sch, esc.kicad_sch, mcu.kicad_sch]
2026-10-19 Net classes, Modbus isolation barrier rule, power routing pass (not run yet)
    project.py: net classes from the rail currents (Default 0.2/0.15, Input 1.5,
    Rail 0.5, Limited 0.4, Ground 0.4, Chassis 1.0/1.0), and a save() that keeps
    the schematic settings and the classes in the project file (SaveBoard run
    outside KiCad drops both).
    pcb.py: 1 mm clearance between the bus side of the Modbus port and the rest,
    written both ways (KiCad evaluates one order of each pair).
    route.py: stack-up S / GND / PWR / S; "power" pass draws the planes (ground
    with a GNDISO island, +5V / +3V3 / +VIN, chassis band on layer 4) and runs
    Freerouting on the supply, ground and chassis nets only. Written, not run yet.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
    [base.kicad_pcb]
2026-10-20 Route in stages: ground fanout by script, minimum widths and clearances
    - Net classes at the JLCPCB multilayer minimum at no extra cost: 0.1/0.1 mm,
    0.4/0.2 mm vias; buck nodes in a class of their own; board minimums to match.
    - route.py works in passes, each from the stage written by the one before
    (kicad/stages/, not versioned); "back" restores a stage.
    - Pass "gnd": a stub and a via of its own from every surface pad of GND and
    GNDISO to the layer 2 plane, checked against clearances, holes and planes.
    - Modbus placement: bus side parts below the axis of U38, so the GND/GNDISO
    split follows the isolation barrier.
    - Fixes: zone outline freed by Python, Zones() after Remove, Freerouti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
    [base.kicad_pcb]
2026-10-20 Supply passes one at a time; 3.3 V fanout and layer 4 links
    - Passes 3v3, 5v, vin in turn. A pad off its plane gets its via anyway, then a
    layer 4 track, L-shaped first, to a via of the net in its plane (existing or
    new); the linked vias serve the next ones.
    - Clearance checks gathered in Copper: pads, tracks and vias of the passes
    before, per layer, holes, planes.
    - Layer 3 outlines follow the regulators: +5V down to L1 and C5, +3V3 over the
    3.3 V buck and the safety and drive supply logic, +VIN around the 5 V buck
    input and the power entry.
    - C5 against the output of L1, C1 2 mm lower.
    [base.kicad_pcb]
2026-10-20 Decoupling capacitors against their pins; 3.3 V plane under the axes
    - Placement: the ICs and their decoupling capacitors first, each capacitor
    waiting for every IC of its sheet on its supply and kept against the pin, no
    spreading; the other passives after. 27 capacitors were over 3 mm from their
    pin (the ESC ones up to 14 mm), 8 are now, among them C1 placed by hand.
    - Modbus bus side: no growth beyond its zone, 3 mm wider into the spindle
    block; JP5 and D66 placed by hand between U38 and J13.
    - Layer 3: +3V3 up to y = 47.5 across x = 3 to 131, +5V fed to the axes along
    the right edge.
    - Layer 4 links: an existing via of the plane or a new one, whichever gives
    the shorter track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
    [base.kicad_pcb]
2026-10-20 Supplies done: +VIN trunk to the encoder jumpers, +5V and +VIN fanouts
    - Pass "trunk" first: the planes, then a 1 mm +VIN track on layer 4 to the
    four encoder supply jumpers (4 x 0.6 A at most), along the first clear
    corridor above the axes and down the first clear line from the right edge
    to two 0.8/0.4 mm vias in the plane. All or nothing.
    - Encoder supply jumpers JP1 to JP4 turned over: +VIN pin up toward the trunk,
    +5V pin down over its plane.
    - Passes in order: trunk, gnd, vin, 5v, 3v3, short; the supplies that carry
    current first, the thin links of the later ones route around them.
    - A new via keeps its hole 0.25 mm from the tracks of other nets.
    - Pass "short" (written, not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
    [base.kicad_pcb]
2026-10-20 Pass short: pads up to 3 mm apart joined on layer 1, straight or with one bend
    [base.kicad_pcb]
2026-10-20 Placement for the fast signals: Ethernet terminations and the 25 MHz clock
    - The Ethernet terminations (49.9 ohm on the pair lines) go in the first
    phase, against the PHY pins, unspread: they were 20 mm away on the far side
    of the ESC, a stub on every pair.
    - X1 placed by hand between the ESC and the MCU; an oscillator comes first as
    an anchor, so its series resistors R15 and R16 stand at its output (they
    were 18 mm away, next to the ESC).
    - Pass short leaves out the differential pairs (Ethernet, USB): routed as
    pairs later.
    Claude-Session: https://claude.ai/code/session_01D6Na26JP4CWdxCU6BKa4Yc
    [base.kicad_pcb]
2026-10-20 Pair impedances by a 2D field solver; Ethernet and USB pair classes
    sim/impedance.py: finite difference Laplace solver on the cross section of
    the JLC04161H-7628 outer layer (0.2104 mm 7628, er 4.4, 35 um copper, solder
    mask). Checked against Hammerstad and Jensen (1.6 %) and the JLCPCB 50 ohm
    width. Gap 0.15 mm: 100 ohm at 0.20 mm (Ethernet), 90 ohm at 0.265 mm (USB).
    The pair router keeps 0.3 mm (about 3 W) to other copper; the DRC keeps the
    class clearance, the pins of the ESD arrays being 0.5 mm apart.
    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
    [base.kicad_pcb]
2026-10-20 Differential pairs routed by script; PHY to jack mapping for a planar layout
    - pairs.py, pass "pairs" right after the planes and trunks: A* on a 0.1 mm
    grid for the centre line of each pair, clear of the other copper by about
    3 W (by the clearance alone near the pads), offset into its two lines;
    straight out of the QFN pads, straight through the ESD arrays, each line on
    its own into the through-hole pins of the jack. Ethernet 100 ohm and USB
    90 ohm at 0.15 mm gap (sim/impedance.py).
    - Schematic: the lines on the jack pins and ESD channels in the order that
    routes without a crossing (port A with P and N swapped, port B with TX and
    RX swapped: the LAN9253 PHYs correct the polarit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
    [base.kicad_pcb, bus.kicad_sch, clock.kicad_sch, esc.kicad_sch, mcu.kicad_sch, power.kicad_sch]
2026-10-20 Fast signals routed: 25 MHz clock and OCTOSPI by Freerouting on a fixed board
    - Passes "fast" and "signals" replace "power": Freerouting on the nets asked,
    everything already laid fixed, fanout off.
    - Own session import: only the tracks and vias of the nets asked, added
    locked (ImportSpecctraSES clears every track of the board).
    - DSN: the classes kept with their nets only; keepouts for the chassis band
    of layer 4; vias drawn 0.1 mm wider (Freerouting has no hole clearance);
    CHASSIS kept in the network for its 1 mm clearance, its routes not taken.
    - Java 25 found on its own when JAVA is not set.
    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
    [base.kicad_pcb]
2026-10-20 3.3 V buck laid out after the TPS62A02 example, chassis pass
    The inductor sits against SW, the input capacitor across the VIN pins, the
    output capacitors at the inductor output and the feedback divider on the FB
    side. A +3V3 notch in the layer 3 +VIN plane lies under the buck.
    The short pass necks a wide class down to the narrower pad, so the SOT-563
    pins can be reached. Freerouting gets every net of the board, with pads
    widened for the SO-4 instance images too. A chassis pass routes the shields
    to the layer 4 band.
    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
2026-10-20 Signals and chassis routed, planes kept whole, passes complete and islands
    Planes keep 0.2 mm from the other nets, so vias at a 1 mm pitch no longer wall
    pockets off them. The chassis band joins the shields solid. The chassis pass
    gives the signals left unrouted a second chance. The complete pass gives the
    fine-pitch IC pads of the incomplete nets a way out before a last Freerouting
    run. The islands pass links the vias left on a piece of plane to its main body.
    Freerouting runs without its optimizer and with a four-hour timeout.
    The board is the chassis stage: 22 connections left.
    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
    [base.kicad_pcb]
2026-10-22 Routing work in progress: long supply links left to Freerouting, OCTOSPI resistors at their pins, clash check, rip-up in the complete pass
2026-10-22 DSN: pair wires split at the pads they run across, for Freerouting to see the pairs routed; supplies never ripped up
2026-10-22 Supply links up to 12 mm laid by script, VBUS in the limited class, no rip-up in the complete pass
2026-10-22 Power entry on the line of the fuse; +5V links left to Freerouting routed at 0.15 mm
2026-10-23 VBUS on the outer channel of U2, Tag-Connect at the SWD corner, V3IN at 0.3 mm in the complete pass
    [power.kicad_sch]
2026-10-23 USB_DP on the ESD channel nearer its MCU pin: the pair flows through U2 without crossing
    [power.kicad_sch]
2026-10-23 USB jack, its ESD and VBUS sense on the MCU sheet; channel and block checks; renet and unroute of the working board
    [bus.kicad_sch, clock.kicad_sch, drive_pair.kicad_sch, drive_supply.kicad_sch, encoder.kicad_sch, esc.kicad_sch, mcu.kicad_sch, modbus.kicad_sch]
2026-10-23 Blocks laid out around their main part, edge connectors first, axis instances copied; floor plan of the blocks on the board
    [base.kicad_pcb]
2026-10-24 One drive sheet per axis with its own dual RS-422 driver; one placement score for every step, block refinement, cost breakdown by block
    [base.kicad_sch, bus.kicad_sch, clock.kicad_sch, drive.kicad_sch, drive_supply.kicad_sch, encoder.kicad_sch, esc.kicad_sch, mcu.kicad_sch]
2026-10-24 Pairs laid in the block layout: arrays on the way, wiring searched, ICs step back, lanes kept; isolated region of the Modbus bus side; supply planes drawn from the placement; pcb.py takes the floor p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
    [base.kicad_pcb, esc.kicad_sch]
2026-10-24 Pairs kept from the block layout to the board, their terminations placed with them; tracks laid are an obstacle for every part; wiring of the block layouts checked against the schematic; fixed hash s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
    [base.kicad_pcb, esc.kicad_sch]
2026-10-24 Lanes no longer shadowed in the assembly; channel assignments carried; encoder sheet drawn from the wired channels; trunk drop found across the board
    [base.kicad_pcb, bus.kicad_sch, encoder.kicad_sch]
2026-10-24 Routing: supply planes whole, gated
    planes.py forces each source onto its plane, gives far pads a finger
    (NECK wide at the pad for thermal spokes) and records a bridge where a
    corridor would split another supply. route.py makes one zone per plane
    piece, lays the bridges, links pads out of plane reach by a bridge
    track, and refuses to save a stage that leaves its supply nets cut or
    any non-silkscreen violation.
2026-10-25 Routing: exact connectivity gate, far links clear of fine-pitch escapes
    The stage gate counts missing connections from the board connectivity
    (the DRC report lists at most 499) and holds the fast pass to its nets.
    Links to pads out of plane reach take the width of their class unless a
    supply needs BRIDGE, keep off the way out of fine-pitch ICs, and fall back
    to an A* search when no L shape fits.
2026-10-25 Routing: PHY islands fed on layer 3, supply planes keep off them
    Each PHY island reaches its ferrite on the far side of the PHY by a neck
    on layer 3: a layer 4 track from there walled the way out of the PHY
    pins to its SPI resistors. The supply planes take the islands and necks
    as keep-outs, so their fingers go round instead of being cut.
2026-10-25 Rules aligned on the JLCPCB multilayer capabilities: 0.09 mm tracks and spacing, 0.45/0.3 mm vias, 0.2 mm from a via hole, 0.28 mm from a through-hole lead, 0.2 mm to the edge; via hole read from its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
2026-10-25 Pairs: 0.28 mm from a through-hole lead
2026-10-25 Routing: the chassis pass routes the chassis only, the signals left open go to the complete pass
2026-10-25 Routing: working board set back to the fast stage
    [base.kicad_pcb]
2026-10-26 Routing: KiCadRoutingTools run on the base board, DRC clean with zero unconnected items
    Scripts of the run (per-step audit, scoped retry laps, edge keep-out, widening of necked
    classed nets, dangling cleanup), the placed seed, the final board and its fab export.
    [c33.kicad_pcb, s10.kicad_pcb]
2026-10-27 Net classes written in KiCad's order (Default, then by name): opening the project no longer modifies it
2026-10-27 Base board: the KiCadRoutingTools board (DRC clean, zero unconnected) becomes the main board; trial boards, scripts and Freerouting sessions removed, Gerbers in hardware/base/fab
    [base.kicad_pcb, c33.kicad_pcb, s10.kicad_pcb]
2026-10-27 Base board: the PCB is edited in KiCad, its placement and routing generators removed; only the schematic stays generated
2026-10-27 Local bus: chip selects first on consecutive pins, every other line on an even pin facing a ground, board VIN on pins 33-34 behind one 480 mA switch per pin, a ground as its only neighbour
    [bus.kicad_sch]
2026-10-27 Flow-through ESD arrays: the NC pin opposite each protected line carries it on every TPD4E05, not only on the PHY lines
    [bus.kicad_sch, drive.kicad_sch, mcu.kicad_sch, spindle.kicad_sch]
2026-10-27 Encoder inputs: no termination switch on the board; an RS-422 encoder on a long or fast line takes its 120 ohm at the end of its cable
    [bus.kicad_sch, clock.kicad_sch, drive.kicad_sch, drive_supply.kicad_sch, encoder.kicad_sch, esc.kicad_sch, mcu.kicad_sch, modbus.kicad_sch]
2026-10-27 Modbus termination always fitted (R246, removed for a master in the middle of the line); no ESD array on NRST; Ethernet line nets named TXA_P/TXA_N so that tools pair them
    [bus.kicad_sch, clock.kicad_sch, drive.kicad_sch, drive_supply.kicad_sch, encoder.kicad_sch, esc.kicad_sch, mcu.kicad_sch, modbus.kicad_sch]
2026-10-27 Base: pin swaps of the placed board (chip selects, step/dir/enable channels, encoder timers 0 and 1, ribbon and Ethernet A ESD channels)
    [bus.kicad_sch, esc.kicad_sch, mcu.kicad_sch]
2026-10-28 Base: VREF+ filtered from VDDA through 49.9 ohm (R316, AN5711 47 ohm option)
    VREF+ (pin 21) was tied straight to VDDA. It now has its own net, fed from
    VDDA through R316 (49.9 ohm, palette value) and decoupled by C50 and C51:
    with C50 (1 uF) the filter corner is 3.2 kHz. ERC 0, netlist 0.
    [mcu.kicad_sch]
2026-10-28 NUCLEO-H563ZI: clock from the ST-LINK 8 MHz (HSE bypass), instruction cache and flash prefetch on
    The HSI wandered by up to 700 ppm from one millisecond to the next (measured against a logic
    analyzer), too much for timing measurements; the board now runs from the crystal-based 8 MHz
    the ST-LINK drives on PH0 by default, in digital bypass like the Bornier base board's
    oscillator. The instruction cache was off, so code ran from flash at 5 wait states; prefetch
    is on too. hello and atomic_mmio pass on the debug and release images.
    Claude-Session: https://claude.ai/code/session_011suY1Xkp8FNCev4RF2LcQ9
    [clock.hpp]
2026-10-28 Step generator on-target test: four STEP/DIR axes on TIM1 slots, locked on SYNC0
    TIM1 runs at the maximum step rate, one slot per counter period; a DMA burst per update
    writes CCR1..CCR4 from a byte ring, and each cycle is filled with a phase accumulator per
    axis. SYNC0 resets TIM5 through ETR and TIM5 resets TIM1 (ITR4, URS = 1). DIR is written
    to GPIOE_BSRR by a chain of two DMA channels on TIM5 CC1, the second one gated by the
    first one's transfer complete so that it does not read the DIR word ahead. The DMA
    position at each SYNC0 places the next cycle; steps are counted, never lost.
    The test image simulates SYNC0 with TIM16 on PB8 and the motion per axis; the HIL script
    checks the outpu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
    [main.cpp]
2026-10-28 Step generator: TIM1 runs free from the first SYNC0, phase locked by per-slot ARR in the DMA burst
    Resetting TIM1 on every SYNC0 (URS = 1) played a step twice when SYNC0 came late and lost one
    when it came early, as soon as the distributed clock drifts (measured at +/-96 ppm). TIM1 now
    starts on the first SYNC0 (trigger mode) and is never reset. Each slot carries its own length:
    the DMA burst writes ARR, RCR and CCR1..CCR4 (six bytes per slot). Each cycle the phase of the
    slot grid is read to the tick from the DMA position, TIM1 and TIM5; the drift is low-pass
    filtered and the next cycle lengthens or shortens that many slots by one tick, spread evenly,
    plus a quarter of the phase error. No s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
    [main.cpp]
2026-10-28 Step generator: slot pairs cleared as aligned words, full-speed walk kept in registers, fill statistics once locked
    The ring is stored as words and addressed by bytes; two slots (12 bytes) are cleared with
    three word stores instead of a 6-byte struct copied through the stack with unaligned stores
    (18 to 8 cycles per slot). The common walk (single-slot pulses, no check) is a small
    out-of-line function with scalar parameters: inlined in fill_axis, -Os ran out of registers
    and reloaded three loop invariants from the stack on every step. Fill statistics start once
    the phase is locked, as the phase ones, and report the steps of the longest fill.
    Four axes at full speed, worst fill per 1 ms cycle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
2026-10-28 Step generator test: competing DMA load option, chunked counts-only check for long runs
    dma_load.hpp copies a 4 KB block over and over on GPDMA2 or GPDMA1, lowest priority, as a
    stand-in for the slave controller interface; "load <controller> <ms>" measures it alone.
    The HIL script reads captures memory-mapped and, with --counts-only, checks counts and
    positions chunk by chunk, so that a 10-minute capture fits.
    Measured, release: 10 minutes at 1 MHz, mixed profile, SYNC0 at -96 ppm, 367 million steps
    exact on the four axes (debug image too). Competing copies keep 133 MB/s at worst (2 MHz,
    four axes at full speed, same DMA controller as the steps) against 492 MB/s alone; the steps
    are unaffec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
2026-10-28 OpSy moved to 15bb902; the step generator starts the cycle counter with opsy::cortex_m::enable_cycle_count
    OpSy 8453c26..15bb902: counting and binary semaphores, a bounded queue on the proposed
    std::bounded_queue interface, callback on the std::move_only_function interface,
    task::stack_high_water, and enable_cycle_count, which starts the DWT cycle counter that
    cycle_count reads. The step generator no longer writes DEMCR and DWT_CTRL itself.
    hello, atomic_mmio and step_generator (mixed profile at -96 ppm, four axes at 2 MHz at
    +96 ppm, checked with the logic analyzer) pass on the debug and release images.
    Claude-Session: https://claude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
    [main.cpp]
2026-10-28 Step generator: missed frames extrapolated up to a tolerance, then ramp down and hold until acknowledged
    A cycle whose target did not arrive is extrapolated at the last velocity of each axis, up to
    missed_tolerance cycles in a row (3 by default). One more and the generator faults: every axis
    ramps down to rest at its stop deceleration (per axis, steps/s^2; by default from f_max to
    rest in 100 ms), in 16.16 fixed point, then holds. It takes targets again only after
    acknowledge() and from a target one cycle away at most from where the axes stand, so that the
    master resumes from the actual position and never with a jump.
    The test image loses frames on request (isolated, in bursts, outage) and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
    [main.cpp]
2026-11-01 Base board: final routing, DRC clean with no unconnected items; fabrication outputs
    Gerbers, drill files, BOM and pick-and-place file for JLCPCB, generated from this board.
    [base-bom.csv, base.kicad_pcb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]
2026-11-01 Base board: pick-and-place file checked pad by pad against the JLCPCB footprint of every part
    [base-cpl.csv]
2026-11-01 Base board: Ethernet pairs rerouted without branches
    Each line now runs from the ESC through its ESD protection to its jack.
    Terminations moved next to the pairs, length matched within 2 mm.
    The Ethernet net class patterns now match the net names, so its width
    and clearance apply. Pick-and-place and Gerbers regenerated.
    [base.kicad_pcb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]
2026-11-02 Base board: routing tightened for the validation prototype, fewer corners, vias and detours; fabrication outputs
    [base.kicad_pcb]
2026-11-02 Base board: silkscreen legends for connectors, jumpers, test points and LEDs; references placed without overlap
    [base.kicad_pcb]
2026-11-02 Base board: red LEDs turned in the pick-and-place file; their JLCPCB footprint numbers anode and cathode the other way round
    [base-cpl.csv]
2026-11-02 Base board: power traces widened in place (ground returns, 3.3 V output, core and PHY supplies); no track, via or part moved
    [base.kicad_pcb]
2026-11-13 Firmware: STM32H523 support and base board bring-up (clock, MCU LED, blink example)
    Register headers generated from the ST STM32H523 SVD 1.2, linker script for the 512 KB / 272 KB variant, board support for the base board (250 MHz from the 25 MHz oscillator in HSE bypass, MCU LED on PC13) and a blink example. Checked on the board in debug: PLL locked on HSE, LED pin toggling at 1 Hz.
    [clock.hpp]
2026-11-13 Base board: text output on SWO, blink prints numbered lines, HIL check through J-Link
    trace.hpp writes on ITM stimulus port 0 (PB3). blink_swo.py listens with J-Link SWO Viewer and checks consecutive lines at 1 Hz: passes on the board in debug and in release. CONTRIBUTING describes flashing with J-Link Commander.
2026-11-13 Base board: LAN9253 register reads through the OCTOSPI, esc_probe on-target test
    esc_bus.hpp drives the OCTOSPI as a single-line SPI master in indirect mode (READ, 10 MHz). It waits for BUSY to clear after each transfer: the OCTOSPI ignores the set-up of the next command while SCS# is still in its high time. esc_probe reads BYTE_TEST (0x87654321) and ID_REV (0x92530000) and passes on the board in debug and in release.
2026-11-13 Base board: LAN9253 register writes and EtherCAT core access, esc_probe checks the user RAM
    esc_bus.hpp gains write(), core_read() and core_write() (ECAT_CSR_CMD / ECAT_CSR_DATA). esc_probe writes two patterns to the user RAM of the core and reads them back in 32, 16 and 8 bits; it also prints HW_CFG, the core type, the AL event request and the EEPROM status. On the board, debug and release: verdict PASS, and the core shows a pending EEPROM emulation request (READY stays 0 until the firmware serves it).
2026-11-13 Base board: quad (SQI) bus mode to the LAN9253 at 62.5 MHz, esc_probe checks both modes
    esc_bus.hpp drives SIO2 and SIO3 and gains set_mode(): single (READ, 10 MHz) or quad (EQIO, FASTREAD with 8 dummy cycles, 62.5 MHz). init() sends RSTQIO, since the LAN9253 keeps its bus mode through a reset of the MCU alone. The dummy cycle count was measured on the board: the only one out of 0 to 11 that reads BYTE_TEST right, from 10 to 83 MHz. esc_probe runs its checks in both modes: PASS on the board in debug and in release.
    [esc_bus.hpp, main.cpp]
2026-11-13 Base board: isolated RS-485 port on USART2, rs485_echo on-target test
    rs485.hpp drives the MODBUS port (hardware DE, 115200 8N1). rs485_echo sends the 256 byte values with nothing wired and checks the echo that the always-on receiver returns through the isolated transceiver and the biased line. PASS on the board in debug and in release.
2026-11-13 Register headers regenerated with SvdGenerator 1.0.0-pre.57111ab, code ported
    The generated headers no longer need OpSy (mmio.hpp next to them), a register
    no longer repeats the name of its peripheral, GPIO ports and timers share one
    type per kind on both devices, and the GPDMA channels are an array.
    Ported: board support of the base board and of the NUCLEO-H563ZI, examples and
    on-target tests. dma_load takes a channel reference instead of ten pointers to
    members. mmio.hpp is MIT (REUSE.toml, LICENSES/MIT.txt).
    Both build types compile. blink, esc_probe and rs485_echo pass on the base
    board in debug and release. The NUCLEO-H563ZI images are not yet run on target.
    [clock.hpp]
2026-11-13 Vector tables built with the generated vectors.hpp, OpSy updated
    OpSy no longer carries interrupt_vector.hpp nor memory.hpp. Both startup files
    build their table with vector_table<Default_Handler, opsy::hooked_isr>:
    opsy::scheduler::isrs places the handlers of the scheduler, and every unhandled
    exception or interrupt now goes to Default_Handler.
    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
    [startup.cpp]
2026-11-13 Register headers regenerated with SvdGenerator 1.0.0-pre.f55d06c
    Each peripheral header now starts with a map of its registers, and the README
    of each device directory is written by the generator. No change of the C++ API.
    board in debug and release.
    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
2026-11-13 REUSE: the generated device READMEs are Apache-2.0, like the headers
2026-11-13 Register headers regenerated with SvdGenerator 1.0.0-pre.97428b0
    No change of the C++ API. Both build types compile. blink, esc_probe and
    rs485_echo pass on the base board in debug and release.
2026-11-13 REUSE: the generated device READMEs are documentation of this repository, not STMicroelectronics files
2026-11-13 Register headers regenerated with SvdGenerator 1.0.0
    Only the version in the first line of each generated file changes. Both build
    types compile. blink, esc_probe and rs485_echo pass on the base board in debug
    and release.
2026-11-13 NUCLEO-H563ZI removed: the firmware targets the base board only
    Removed: the NUCLEO-H563ZI board support, the STM32H563 register headers, the
    hello example, the step_generator test and their host scripts. The step
    generator comes back when it is ported to the base board.
    atomic_mmio now runs on the base board and reports on SWO. Two of its register
    bits do not exist on the STM32H523 (GPIOE ODR bit 1, the GPIOI clock enable):
    it uses GPIOE ODR bits 2 and 3 and the GPIOF/GPIOG clock enables.
    Both build types compile. blink, esc_probe, rs485_echo and atomic_mmio pass on
    the base board in debug and release.
